Viktor-Matitsin/Hardware/FMU_V.2/BOM_FMU_V.2.xlsx

Oty | Value | Device | Package | Parts | Description | LINK
1 | 0u01 | CAP0603 | 0603-CAP | C515 | Capacitor | https://www.digikey.com/product-detail/en/kemet/C0603C103K3RACTU/399-7840-1-ND/3471563
4 | 0u01 | CAP0805 | 0805-CAP | C913, C914, C918, C920 | Capacitor | https://www.digikey.com/product-detail/en/kemet/C0805C103K3RACTU/399-7994-1-ND/3471717
2 | 0u022 | CAP0805 | 0805-CAP | C917, C919 | Capacitor | https://www.digikey.com/product-detail/en/kemet/C0805C223K3RACTU/399-11169-1-ND/4357887
32 | 0u1 | CAP0603 | 0603-CAP | C101, C201, C301, C302, C305, C308, C309, C401, C402, C403, C404, C405, C503, C507, C508, C514, C516, C606, C607, C608, C610, C612, C615, C616, C617, C619, C702, C703, C704, C707, C804, C805 | Capacitor | https://www.digikey.com/product-detail/en/kemet/C0603C104K3RACTU/399-1281-1-ND/416057
2 | 0u1 | CAP0805 | 0805-CAP | C333, C334 | Capacitor | https://www.digikey.com/product-detail/en/tdk-corporation/C2012X7R2A104K125AA/445-1418-1-ND/569084
4 | 0u33 | CAP1210 | 1210-CAP | C406, C407, C408, C409 | Capacitor | https://www.digikey.com/product-detail/en/kemet/C1210C334K1RAC7800/399-14726-1-ND/7104018
2 | 0u47 | CAP0603 | 0603-CAP | C204, C509 | Capacitor | https://www.digikey.com/product-detail/en/kemet/C0603C474K3RAC7867/399-11934-1-ND/5267654
2 | 0u47 | CAP0805 | 0805-CAP | C915, C915 | Capacitor | https://www.digikey.com/product-detail/en/kemet/C0805C474K5RACTU/399-8100-1-ND/3471823
8 | 100u | CAP1206 | 1206-CAP | C925, C926, C927, C929, C930, C931, C614, C618 | Capacitor | https://www.digikey.com/product-detail/en/taiyo-yuden/EMK325ABJ107MM-T/587-3152-1-ND/2774765
2 | 100u | CAP_POL1206 | EIA3216 | C310, C311 | Capacitor | https://www.digikey.com/product-detail/en/avx-corporation/TLNS107M010R2500/478-6249-1-ND/2470134
1 | 10u | CAP0603 | 0603-CAP | C807 | Capacitor | https://www.digikey.com/product-detail/en/kemet/C0603C106M9PACTU/399-5504-1-ND/1950682
7 | 10u/25V | CAP0805 | 0805-CAP | C312, C410, C506, C511, C803, C601, C620 | Capacitor | https://www.digikey.com/product-detail/en/kemet/C0805C106K3PAC7800/399-11939-1-ND/5267657
3 | 1u | CAP0603 | 0603-CAP | C202, C808, C603 | Capacitor | https://www.digikey.com/product-detail/en/kemet/C0603C105K3RACTU/399-7376-1-ND/3317410
4 | 1u | CAP0805 | 0805-CAP | C303, C304, C306, C307 | Capacitor | https://www.digikey.com/product-detail/en/kemet/C0805C105K3RACTU/399-8004-1-ND/3471727
4 | 22u/25V | CAP0805 | 0805-CAP | C313, C411, C604, C605 | Capacitor | https://www.digikey.com/product-detail/en/murata-electronics-north-america/GRT21BR61E226ME13L/490-12389-1-ND/5417090
4 | 2u2 | CAP0603 | 0603-CAP | C512, C513, C611, C613 | Capacitor | https://www.digikey.com/product-detail/en/kemet/C0603C225K4PACTU/399-7886-1-ND/3471609
4 | 330p | CAP0805 | 0805-CAP | C911, C912, C923, C924 | Capacitor | https://www.digikey.com/product-detail/en/kemet/C0805C331K1RACTU/399-9224-1-ND/3522742
2 | 33u | CAP1206 | 1206 | C928, C932 | Capacitor | https://www.digikey.com/product-detail/en/kemet/C1206C476M8PACTU/399-5508-1-ND/1950686
8 | 22u | CAP1812 | 1812-CAP | C901, C902,C903, C904, C905, C906, C907, C908 | Capacitor | https://www.digikey.com/product-detail/en/tdk-corporation/CKG57NX7S2A226M500JH/445-5217-1-ND/2116352
1 | 5n6 | CAP0603 | 0603-CAP | C203 | Capacitor | https://www.digikey.com/product-detail/en/kemet/C0603C562K5RACTU/399-7943-1-ND/3471666
4 | 8p | CAP0603 | 0603-CAP | C102, C103, C705, C706 | Capacitor | https://www.digikey.com/product-detail/en/kemet/CBR06C809BAGAC/399-8740-1-ND/3480389
6 | 100K | RESISTOR0603-RES | 0603-RES | R214, R301, R302, R303, R304, R305 | Resistor | https://www.digikey.com/product-detail/en/vishay-dale/CRCW0603100KFKEA/541-100KHCT-ND/1180038
8 | 10K | RESISTOR0603-RES | 0603-RES | R102, R103, R212, R611, R615, R701, R702, R706 | Resistor | https://www.digikey.com/product-detail/en/vishay-dale/CRCW060310K0FKEA/541-10.0KHCT-ND/1179924
7 | 10K/0,1% | RESISTOR0603-RES | 0603-RES | R407, R408, R609, R610, R809, R810, R811 | Resistor | https://www.digikey.com/product-detail/en/vishay-dale/TNPW060310K0BEEA/TNP10.0KAACT-ND/1857057
2 | 10R | RESISTOR2512-RES | 2512-RES | R916, R917 | Resistor | https://www.digikey.com/product-detail/en/vishay-dale/CRCW251210R0FKEGHP/541-10.0RCT-ND/2222586
10 | 120R | RESISTOR0603-RES | 0603-RES | R201, R202, R203, R204, R208, R209, R210, R211, R404, R405 | Resistor | https://www.digikey.com/product-detail/en/vishay-dale/CRCW0603120RFKEAHP/541-120SCT-ND/5326818
1 | 120R | RESISTOR0805-RES | 0805-RES | R310 | Resistor | https://www.digikey.com/product-detail/en/vishay-dale/CRCW0805120RFKEAHP/541-120TCT-ND/5326877
2 | 16K5 | RESISTOR0603-RES | 0603-RES | R218, R617 | Resistor | https://www.digikey.com/product-detail/en/vishay-dale/CRCW060316K5FKEA/541-16.5KHCT-ND/1179947
1 | 1K | RESISTOR0603-RES | 0603-RES | R608 | Resistor | https://www.digikey.com/product-detail/en/vishay-dale/CRCW06031K00FKEA/541-1.00KHCT-ND/1179809
3 | 1K2 | RESISTOR0603-RES | 0603-RES | R309, R311, R312 | Resistor | https://www.digikey.com/product-detail/en/vishay-dale/CRCW06031K20FKEA/541-1.20KHCT-ND/1179817
4 | 1K5 | RESISTOR0603-RES | 0603-RES | R401, R402, R306, R307 | Resistor | https://www.digikey.com/product-detail/en/vishay-dale/CRCW06031K50FKEA/541-1.50KHCT-ND/1179827
2 | 1K65 | RESISTOR0805-RES | 0805-RES | R914, R915 | Resistor | https://www.digikey.com/product-detail/en/vishay-dale/CRCW08051K65FKEA/541-1.65KCCT-ND/1180806
5 | 1M | RESISTOR0603-RES | 0603-RES | R104, R602, R604, R901, R902 | Resistor | https://www.digikey.com/product-detail/en/vishay-dale/RCS06031M00FKEA/541-2803-1-ND/5867096
2 | 21K | RESISTOR0805-RES | 0805-RES | R910, R911 | Resistor | https://www.digikey.com/product-detail/en/yageo/RC0603FR-0721KL/311-21.0KHRCT-ND/729995
10 | 220R | RESISTOR0603-RES | 0603-RES | R621, R703, R704, R705, R802, R803, R804, R805, R806, R807 | Resistor | https://www.digikey.com/product-detail/en/vishay-dale/CRCW0603220RFKEAHP/541-220SCT-ND/2825993
2 | 22K/1% | RESISTOR0603-RES | 0603-RES | R903, R904 | Resistor | https://www.digikey.com/product-detail/en/vishay-dale/CRCW060322K0FKEA/541-22.0KHCT-ND/1179960
2 | 22K | RESISTOR0603-RES | 0603-RES | R903, R904 | Resistor | https://www.digikey.com/product-detail/en/yageo/RC0603JR-0722KL/311-22KGRCT-ND/729691
1 | 25K5 | RESISTOR0603-RES | 0603-RES | R616 | Resistor | https://www.digikey.com/product-detail/en/vishay-dale/CRCW060325K5FKEA/541-25.5KHCT-ND/1179968
4 | 330R | RESISTOR0603-RES | 0603-RES | R206, R213, R216, R921 | Resistor | https://www.digikey.com/product-detail/en/vishay-dale/CRCW0603330RFKEAHP/541-330SCT-ND/2826009
1 | 453K | RESISTOR0603-RES | 0603-RES | R217 | Resistor | https://www.digikey.com/product-detail/en/vishay-dale/CRCW0603453KFKEA/541-453KHCT-ND/1180112
1 | 470R | RESISTOR0603-RES | 0603-RES | R101 | Resistor | https://www.digikey.com/product-detail/en/vishay-dale/CRCW0603470RFKEA/541-470HCT-ND/1179771
2 | 49K9 | RESISTOR0805-RES | 0805-RES | R912, R913 | Resistor | https://www.digikey.com/product-detail/en/vishay-dale/CRCW080549K9FKEA/541-49.9KCCT-ND/1180976
2 | 510R | RESISTOR0603-RES | 0603-RES | R205, R215 | Resistor | https://www.digikey.com/product-detail/en/vishay-dale/CRCW0603510RFKEAHP/541-510S-CT-ND/5326852
2 | 5K11 | RESISTOR0805-RES | 0805-RES | R918, R919 | Resistor | https://www.digikey.com/product-detail/en/vishay-dale/CRCW08055K11FKEA/541-5.11KCCT-ND/1180864
4 | 60R | RESISTOR0805-RES | 0805-RES | R409, R410, R411, R412 | Resistor | https://www.digikey.com/product-detail/en/vishay-dale/CRCW080559R0FKEA/541-59.0CCT-ND/1180643
1 | 9K09 | RESISTOR0603-RES | 0603-RES | R207 | Resistor | https://www.digikey.com/product-detail/en/vishay-dale/TNPW06039K09BEEA/TNP9.09KAACT-ND/1857092
1 | 2908-05WB-MG | MICROSDSDI | MICROSD | U301 | CONN MICRO SD CARD PUSH-PUSH R/A | https://www.digikey.com/product-detail/en/3m/2908-05WB-MG/3M5607CT-ND/1242498
2 | ADUM5402CRWZ-RL | ADUM1301 | SO-16W | U303, U401 | DGTL ISO 2.5KV GEN PURP 16SOIC | https://www.digikey.com/product-detail/en/analog-devices-inc/ADUM5402CRWZ-RL/ADUM5402CRWZ-RLDKR-ND/3664615
2 | BQ24315DSGR | BQ24315 | QFN8-DSG | U601, U602 | IC LI+ CHARGER FRONT END 8-SON | https://www.digikey.com/product-detail/en/texas-instruments/BQ24315DSGR/296-23341-1-ND/1833318
1 | FM25V01A-G | FM25V01 | SO08 | U102 | IC FRAM 128KBIT 40MHZ 8SOIC | https://www.digikey.com/product-detail/en/cypress-semiconductor-corp/FM25V01A-G/428-3385-ND/5210379
1 | ICM20608-G | ICM20608 | LGA-16-3PX5P | U502 | IMU ACCEL/GYRO I2C/SPI 16LGA | https://www.digikey.com/product-detail/en/tdk-invensense/ICM-20608-G/1428-1052-1-ND/5177387
3 | LM1117IMPX-3.3/NOPB | LM1117 | TO-261-4 | U603, U604, U803 | IC REG LIN 3.3V 800MA SOT223-4 | https://www.digikey.com/product-detail/en/texas-instruments/LM1117IMPX-3.3-NOPB/LM1117IMPX-3.3-NOPBCT-ND/3440160
2 | LM5005MHX/NOPB | LM5005 | TSSOP20 | U901, U902 | IC REG BUCK ADJ 2.5A 20TSSOP | https://www.digikey.com/product-detail/en/texas-instruments/LM5005MHX-NOPB/LM5005MHX-NOPBCT-ND/3526995
1 | LT3469ETS8 | LT3469 | SOT23-8 | U202 | IC AMP DVR W/REG 1.3MHZ TSOT23-8 | https://www.digikey.com/product-detail/en/linear-technology/LT3469ETS8-TRMPBF/LT3469ETS8-TRMPBFCT-ND/3830402
1 | MAX13487EESA+T | MAX13487 | SO08 | U304 | IC TXRX RS485/RS422 8-SOIC | https://www.digikey.com/product-detail/en/maxim-integrated/MAX13487EESA-T/MAX13487EESA-CT-ND/5639993
1 | MAX232ECWE | MAX232E | SO16L | U305 | IC TXRX RS232 5V ESD-PROT 16SOIC | https://www.digikey.com/product-detail/en/maxim-integrated/MAX232ECWE-/MAX232ECWE--ND/947838
2 | MAX3051EKA+T | MAX3051 | SOT23-8 | U402, U403 | IC TXRX CAN 3.3V SOT23-8 | https://www.digikey.com/product-detail/en/maxim-integrated/MAX3051EKA-T/MAX3051EKA-TCT-ND/2699450
1 | MPU-6000 | MPU-6000 | QFN-24 (4x4x1 mm) | U504 | IMU ACCEL/GYRO I2C/SPI 24QFN | https://www.digikey.com/product-detail/en/tdk-invensense/MPU-6000/1428-1005-1-ND/4038006
1 | MPU-9250 | MPU-9250 | QFN-24 (3x3x1 mm) | U503 | IMU ACCEL/GYRO/MAG I2C/SPI 24QFN | https://www.digikey.com/product-detail/en/tdk-invensense/MPU-9250/1428-1019-1-ND/4626450
1 | MS5611-01BA03-00 | MS5611-01BA | MS5611-01BA | U506 | BAROMETRIC PRESSURE SENSOR | https://www.digikey.com/products/en?keywords=MS5611-01BA03-00
1 | NUF2042XV6T1G | NUF2042XV6 | SOT563-6 | U302 | FILTER RC(PI) 22 OHM/42PF SMD | https://www.digikey.com/product-detail/en/on-semiconductor/NUF2042XV6T1G/NUF2042XV6T1GOSCT-ND/2122047
1 | STM32F100C8T6B | STM32F10XCXT6 | TQFP48 | U701 | IC MCU 32BIT 64KB FLASH 48LQFP | https://www.digikey.com/product-detail/en/stmicroelectronics/STM32F100C8T6B/497-10499-ND/2259224
1 | STM32F427VIT6 | STM32F4X7VX | TQFP100 | U101 | IC MCU 32BIT 2MB FLASH 100LQFP | https://www.digikey.com/product-detail/en/stmicroelectronics/STM32F427VIT6/497-14049-ND/4357419
2 | TXS0108EPWR | TXS0108TSSOP-20 | R-PDSO-G20 | U201, U801 | IC 8BIT NON-INV TRANSLTR 20TSSOP | https://www.digikey.com/product-detail/en/texas-instruments/TXS0108EPWR/296-23011-1-ND/1775304
1 | MSS1P4-M3/89A | MSS1P4-M3 | MicroSMP | D302 | DIODE SCHOTTKY 40V 1A MICROSMP | https://www.digikey.com/product-detail/en/vishay-semiconductor-diodes-division/MSS1P4-M3-89A/MSS1P4-M3-89AGICT-ND/2071761
1 | 30BQ100TR | DIODE-SCHOTTKI-SMA | SMA-DIODE | D909 | DIODE SCHOTTKY 100V SMC | https://www.digikey.com/product-detail/en/smc-diode-solutions/30BQ100TR/1655-1389-1-ND/6022834
4 | 6CWQ10FN-M3 | MOSFET-NCHANNEL-DPAK | D-PAK (TO-252AA) “M” | D901, D902, D903, D904 | DIODE ARRAY SCHOTTKY 100V DPAK | https://www.digikey.com/products/en?keywords=6CWQ10FN-M3
6 | PESD0402-140 | DIODE-TVS | 0402-TVS | D201, D202, D203, D401, D403, D701 | TVS DIODE 14VWM 40VC 0402 | https://www.digikey.com/product-detail/en/littelfuse-inc/PESD0402-140/PESD0402-140CT-ND/1968526
3 | PESD1CAN | PESD1CAN | SOT23 | D301, D404, D405 | TVS DIODE 24VWM 50VC SC70 | https://www.digikey.com/product-detail/en/nexperia-usa-inc/PESD1CAN-UX/1727-1306-1-ND/4386316
1 | RB751V40T1G | DIODE-SCHOTTKY_SOD323 | SOD323 | D601 | DIODE SCHOTTKY 30V 30MA SOD323 | https://www.digikey.com/product-detail/en/on-semiconductor/RB751V40T1G/RB751V40T1GOSCT-ND/964629
3 | APHHS1005ZGC | LED0603 | 0603-LED | LED2, LED3, LED6 | LED GREEN CLEAR 0402 SMD | https://www.digikey.com/product-detail/en/kingbright/APHHS1005ZGC/754-1503-1-ND/2263583
1 | APHHS1005QBC/D | LED0603 | 0603-LED | LED5 | LED BLUE CLEAR 0402 SMD | https://www.digikey.com/product-detail/en/kingbright/APHHS1005QBC-D/754-1504-1-ND/2263581
2 | APHHS1005SURCK | LED0603 | 0603-LED | LED1, LED4 | LED RED CLEAR 0402 SMD | https://www.digikey.com/product-detail/en/kingbright/APHHS1005SURCK/754-1104-1-ND/1747821
2 | DR120-330-R | SLF10145 | SLF10145 | L901, L902 | 33µH Shielded Wirewound Inductor | https://www.digikey.com/product-detail/en/eaton/DR127-330-R/513-1047-1-ND/695328
1 | LBR2012T470K | INDUCTOR0805 | 0805-IND | L204 | FIXED IND 47UH 75MA 1.7 OHM SMD | https://www.digikey.com/product-detail/en/taiyo-yuden/LBR2012T470K/587-2047-1-ND/1788994
11 | NFM15PC104D0J3D | KNH16C104DA5TS | 0402-1.0x0.5mm | L201, L202, L203, L401, L404, L603, L604,L801, L802, L903, L904 | CAP FEEDTHRU 0.1UF 20% 6.3V 0402 | https://www.digikey.com/product-detail/en/murata-electronics-north-america/NFM15PC104D0J3D/490-14730-1-ND/6606336
1 | MS621FE-FL11E | MS621FE | MS621FE | B601 | BATT LITH 3V 5.5MAH COIN 6.8MM | https://www.digikey.com/products/en?keywords=MS621FE-FL11E
2 | NX3225SA-24.000MHZ-STD-CSR-1 | OSCILLATOR-3.2X2.5 | OSCILLATOR-3.2X2.5 | X101, X701 | 24MHz ±15ppm Crystal 8pF | https://www.digikey.com/product-detail/en/ndk-america-inc/NX3225SA-24.000MHZ-STD-CSR-1/644-1052-1-ND/1128924
2 | EVQ-P7A01P | SWITCH-MOMENTARY-2 | EVQP7J01K | S601, S701 | SWITCH TACTILE SPST-NO 0.05A 12V | https://www.digikey.com/product-detail/en/panasonic-electronic-components/EVQ-P7A01P/P16763CT-ND/4429456
1 | 473460001 | MOLEX-47346-0001 | MOLEX-47346-0001 | USB1 | CONN RCPT 5POS MICRO USB-2 R/A | https://www.digikey.com/product-detail/en/molex-llc/0473460001/WM17141CT-ND/1782474
