Viktor-Matitsin/Hardware/FMU_V.2/FMU_V.2.brd

## EAGLE design FMU_V.2/FMU_V.2.brd (2017-08-23)

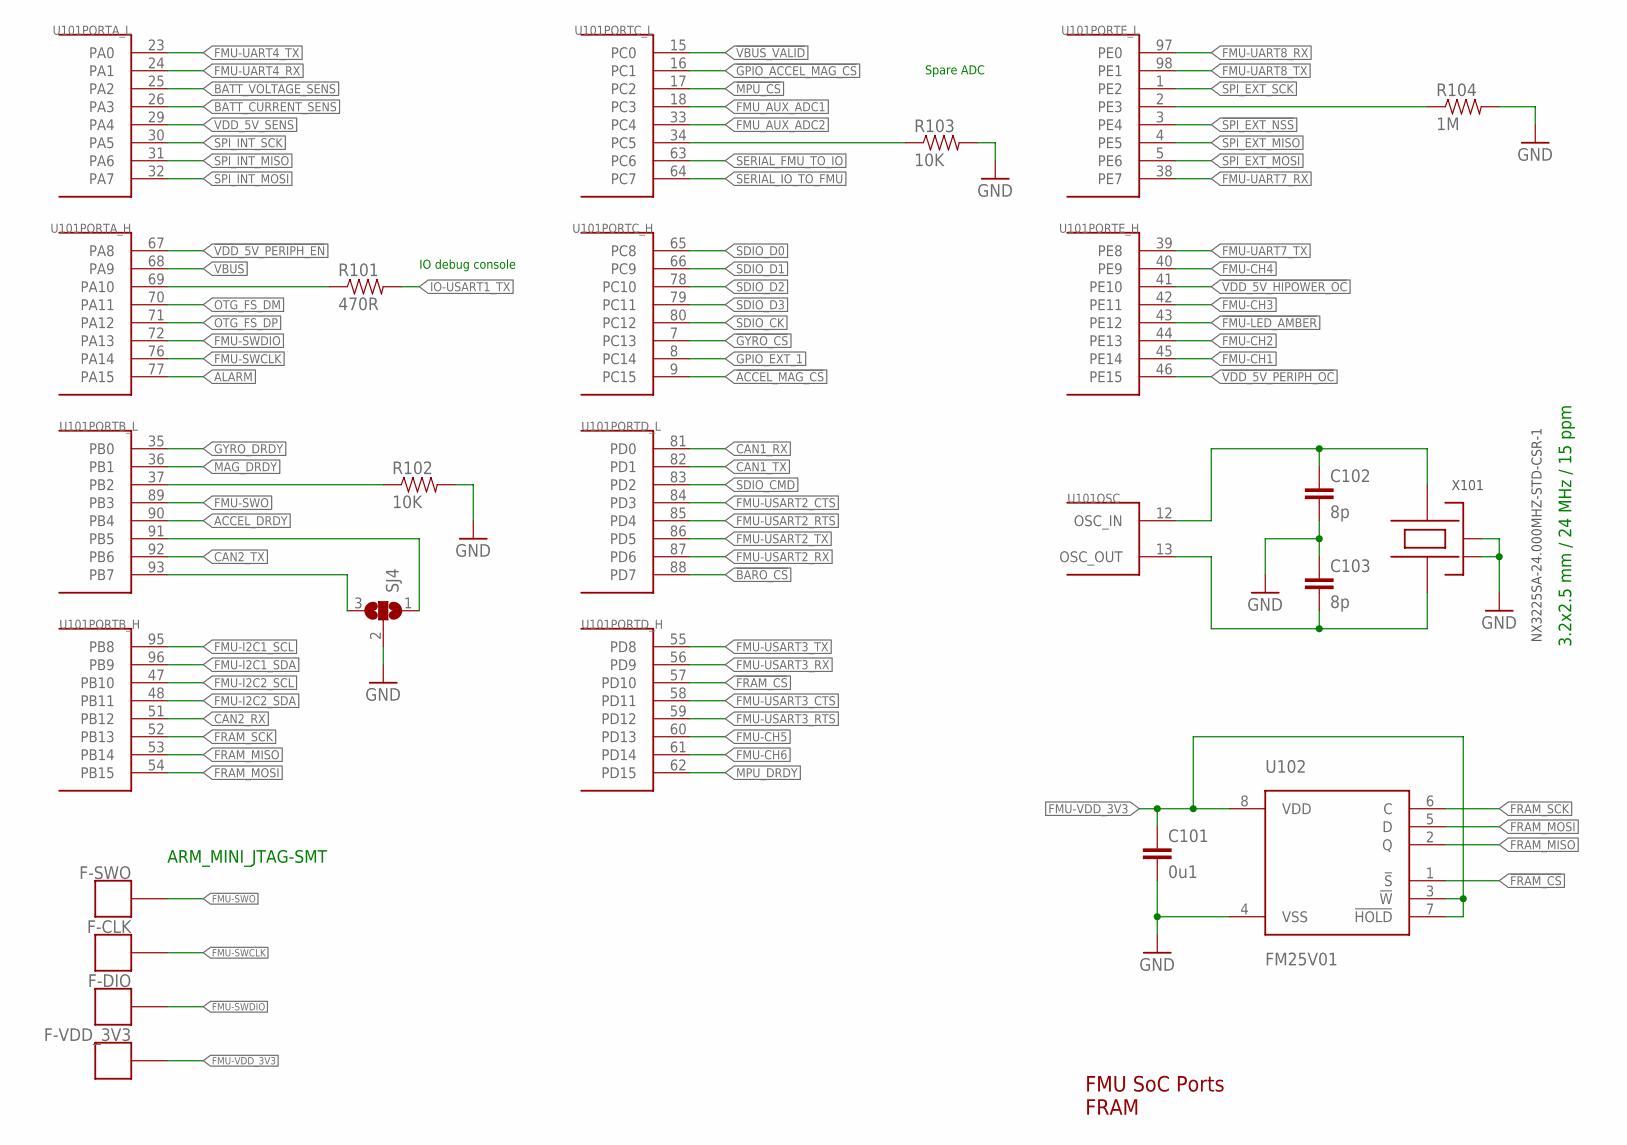
[picture p1: schematic FMU_V.2.sch, sheet 1]

Parts:
C101: 0u1; 0603-CAP
C102, C103: 8p; 0603-CAP
F-CLK: PAD.04; PAD.04X.04
F-DIO: PAD.04; PAD.04X.04
F-SWO: PAD.04; PAD.04X.04
F-VDD_3V3: PAD.04; PAD.04X.04
R101: 470R; 0603-RES
R102, R103: 10K; 0603-RES
R104: 1M; 0603-RES
SJ4: SJ2W; SJ_2
U101: STM32F4X7VX; TQFP100; PARTNO STM32F427VI
U102: FM25V01; SO08; PARTNO FM25V01-G
X101: NX3225SA-24.000MHZ-STD-CSR-1; OSCILLATOR-3.2X2.5; PARTNO NX3225SA-24.000000MHZ

Connections:
!ACCEL_MAG_CS: U101.9 (PC15); also elsewhere on the board
!BARO_CS: U101.88 (PD7); also elsewhere on the board
!FMU-LED_AMBER: U101.43 (PE12); also elsewhere on the board
!FRAM_CS: U101.57 (PD10), U102.1 (!S)
!GPIO_ACCEL_MAG_CS: U101.16 (PC1); also elsewhere on the board
!GYRO_CS: U101.7 (PC13); also elsewhere on the board
!MPU_CS: U101.17 (PC2); also elsewhere on the board
!SPI_EXT_NSS: U101.3 (PE4); also elsewhere on the board
!VBUS_VALID: U101.15 (PC0)
!VDD_5V_HIPOWER_OC: U101.41 (PE10); also elsewhere on the board
!VDD_5V_PERIPH_EN: U101.67 (PA8); also elsewhere on the board
!VDD_5V_PERIPH_OC: U101.46 (PE15); also elsewhere on the board
!VDD_BRICK_VALID: SJ4.1, U101.91 (PB5)
!VDD_SERVO_VALID: SJ4.3, U101.93 (PB7)
ACCEL_DRDY: U101.90 (PB4); also elsewhere on the board
ALARM: U101.77 (PA15); also elsewhere on the board
BATT_CURRENT_SENS: U101.26 (PA3); also elsewhere on the board
BATT_VOLTAGE_SENS: U101.25 (PA2); also elsewhere on the board
CAN1_RX: U101.81 (PD0); also elsewhere on the board
CAN1_TX: U101.82 (PD1); also elsewhere on the board
CAN2_RX: U101.51 (PB12); also elsewhere on the board
CAN2_TX: U101.92 (PB6); also elsewhere on the board
FMU-CH1: U101.45 (PE14); also elsewhere on the board
FMU-CH2: U101.44 (PE13); also elsewhere on the board
FMU-CH3: U101.42 (PE11); also elsewhere on the board
FMU-CH4: U101.40 (PE9); also elsewhere on the board
FMU-CH5: U101.60 (PD13); also elsewhere on the board
FMU-CH6: U101.61 (PD14); also elsewhere on the board
FMU-I2C1_SCL: U101.95 (PB8); also elsewhere on the board
FMU-I2C1_SDA: U101.96 (PB9); also elsewhere on the board
FMU-I2C2_SCL: U101.47 (PB10); also elsewhere on the board
FMU-I2C2_SDA: U101.48 (PB11); also elsewhere on the board
FMU-SWCLK: F-CLK.P$1, U101.76 (PA14)
FMU-SWDIO: F-DIO.P$1, U101.72 (PA13)
FMU-SWO: F-SWO.P$1, U101.89 (PB3)
FMU-UART4_RX: U101.24 (PA1); also elsewhere on the board
FMU-UART4_TX: U101.23 (PA0); also elsewhere on the board
FMU-UART7_RX: U101.38 (PE7); also elsewhere on the board
FMU-UART7_TX: U101.39 (PE8); also elsewhere on the board
FMU-UART8_RX: U101.97 (PE0); also elsewhere on the board
FMU-UART8_TX: U101.98 (PE1); also elsewhere on the board
FMU-USART2_CTS: U101.84 (PD3); also elsewhere on the board
FMU-USART2_RTS: U101.85 (PD4); also elsewhere on the board
FMU-USART2_RX: U101.87 (PD6); also elsewhere on the board
FMU-USART2_TX: U101.86 (PD5); also elsewhere on the board
FMU-USART3_CTS: U101.58 (PD11)
FMU-USART3_RTS: U101.59 (PD12)
FMU-USART3_RX: U101.56 (PD9); also elsewhere on the board
FMU-USART3_TX: U101.55 (PD8); also elsewhere on the board
FMU-VDD_3V3: C101.P$1 (1), F-VDD_3V3.P$1, U102.3 (!W), U102.7 (!HOLD), U102.8 (VDD); also elsewhere on the board
FMU_AUX_ADC1: U101.18 (PC3); also elsewhere on the board
FMU_AUX_ADC2: U101.33 (PC4); also elsewhere on the board
FRAM_MISO: U101.53 (PB14), U102.2 (Q)
FRAM_MOSI: U101.54 (PB15), U102.5 (D)
FRAM_SCK: U101.52 (PB13), U102.6 (C)
GND: C101.P$2 (2), C102.P$2 (2), C103.P$1 (1), R102.2, R103.2, R104.2, SJ4.2, U102.4 (VSS), X101.2 (NC_2), X101.4 (NC_4); also elsewhere on the board
GPIO_EXT_1: U101.8 (PC14); also elsewhere on the board
GYRO_DRDY: U101.35 (PB0); also elsewhere on the board
IO-USART1_TX: R101.2; also elsewhere on the board
MAG_DRDY: U101.36 (PB1); also elsewhere on the board
MPU_DRDY: U101.62 (PD15); also elsewhere on the board
unnamed: C103.P$2 (2), U101.13 (OSC_OUT), X101.1
unnamed: C102.P$1 (1), U101.12 (OSC_IN), X101.3
unnamed: R104.1, U101.2 (PE3)
unnamed: R103.1, U101.34 (PC5)
unnamed: R101.1, U101.69 (PA10)
OTG_FS_DM: U101.70 (PA11); also elsewhere on the board
OTG_FS_DP: U101.71 (PA12); also elsewhere on the board
PC5: R102.1, U101.37 (PB2)
SDIO_CK: U101.80 (PC12); also elsewhere on the board
SDIO_CMD: U101.83 (PD2); also elsewhere on the board
SDIO_D0: U101.65 (PC8); also elsewhere on the board
SDIO_D1: U101.66 (PC9); also elsewhere on the board
SDIO_D2: U101.78 (PC10); also elsewhere on the board
SDIO_D3: U101.79 (PC11); also elsewhere on the board
SERIAL_FMU_TO_IO: U101.63 (PC6); also elsewhere on the board
SERIAL_IO_TO_FMU: U101.64 (PC7); also elsewhere on the board
SPI_EXT_MISO: U101.4 (PE5); also elsewhere on the board
SPI_EXT_MOSI: U101.5 (PE6); also elsewhere on the board
SPI_EXT_SCK: U101.1 (PE2); also elsewhere on the board
SPI_INT_MISO: U101.31 (PA6); also elsewhere on the board
SPI_INT_MOSI: U101.32 (PA7); also elsewhere on the board
SPI_INT_SCK: U101.30 (PA5); also elsewhere on the board
VBUS: U101.68 (PA9); also elsewhere on the board
VDD_5V_SENS: U101.29 (PA4); also elsewhere on the board

Notes on the sheet:
FMU SoC Ports FRAM
IO debug console
Spare ADC
3.2x2.5 mm / 24 MHz / 15 ppm
ARM_MINI_JTAG-SMT

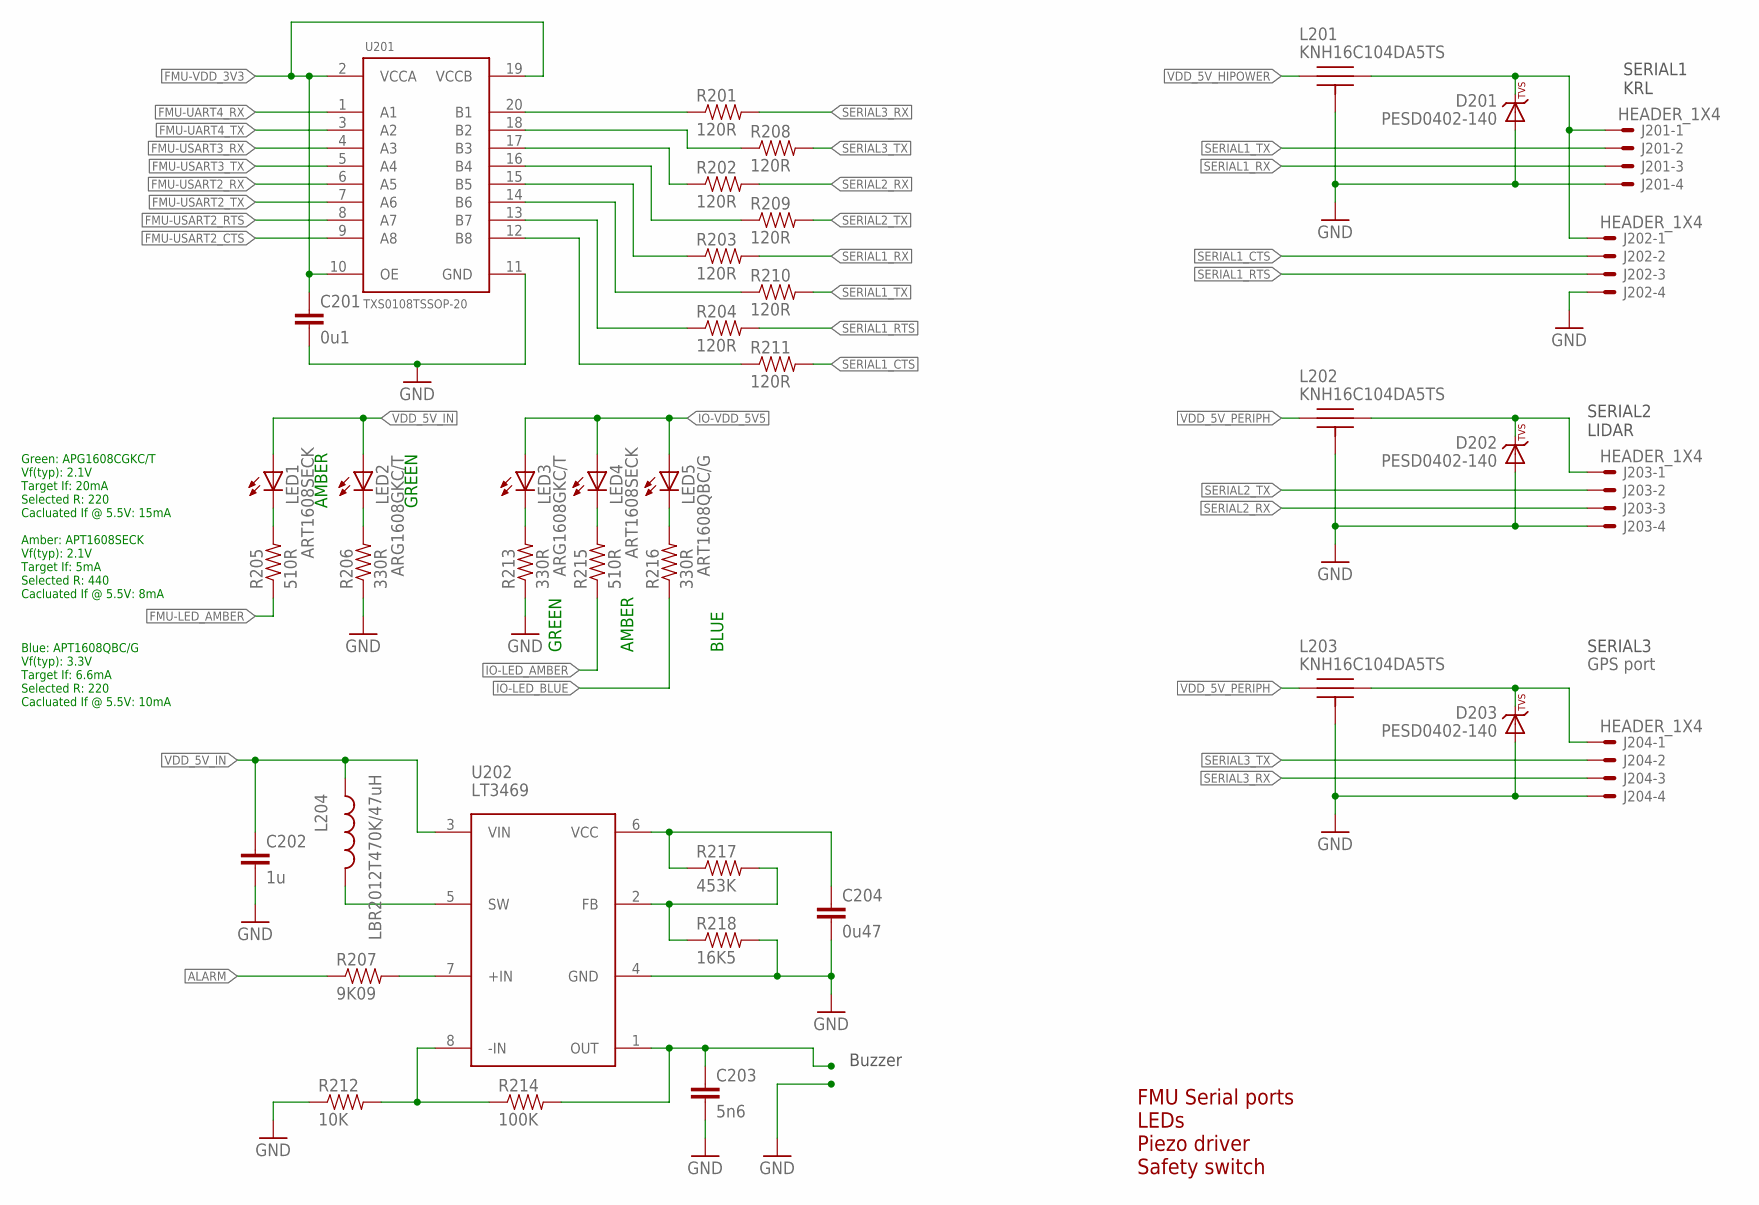
[picture p2: schematic FMU_V.2.sch, sheet 2]

Parts:
C201: 0u1; 0603-CAP
C202: 1u; 0603-CAP
C203: 5n6; 0603-CAP
C204: 0u47; 0603-CAP
D201, D202, D203: PESD0402-140; 0402-TVS; PARTNO PESD0402-140
J201, J202, J203, J204: HEADER_1X4; HEADER_2.54MM-1X04
L201, L202, L203: KNH16C104DA5TS; KYOCERA-KNH16-DA; PARTNO KNH16C104DA5TS
L204: LBR2012T470K/47uH; 0805-IND
LED1, LED4: ART1608SECK; 0603-LED
LED2, LED3: ARG1608GKC/T; 0603-LED
LED5: ART1608QBC/G; 0603-LED
R201, R202, R203, R204, R208, R209, R210, R211: 120R; 0603-RES
R205, R215: 510R; 0603-RES
R206, R213, R216: 330R; 0603-RES
R207: 9K09; 0603-RES
R212: 10K; 0603-RES
R214: 100K; 0603-RES
R217: 453K; 0603-RES
R218: 16K5; 0603-RES
U201: TXS0108TSSOP-20; R-PDSO-G20
U202: LT3469; SOT23-8

Connections:
!FMU-LED_AMBER: R205.1; also elsewhere on the board
!IO-LED_AMBER: R215.1; also elsewhere on the board
!IO-LED_BLUE: R216.1; also elsewhere on the board
ALARM: R207.1; also elsewhere on the board
FMU-UART4_RX: U201.1 (A1); also elsewhere on the board
FMU-UART4_TX: U201.3 (A2); also elsewhere on the board
FMU-USART2_CTS: U201.9 (A8); also elsewhere on the board
FMU-USART2_RTS: U201.8 (A7); also elsewhere on the board
FMU-USART2_RX: U201.6 (A5); also elsewhere on the board
FMU-USART2_TX: U201.7 (A6); also elsewhere on the board
FMU-USART3_RX: U201.4 (A3); also elsewhere on the board
FMU-USART3_TX: U201.5 (A4); also elsewhere on the board
FMU-VDD_3V3: C201.P$1 (1), U201.2 (VCCA), U201.10 (OE), U201.19 (VCCB); also elsewhere on the board
GND: C201.P$2 (2), C202.P$2 (2), C203.P$2 (2), C204.P$2 (2), D201.A, D202.A, D203.A, J201.4, J202.4, J203.4, J204.4, L201.P$3, L201.P$4, L201.P$5, L202.P$3, L202.P$4, L202.P$5, L203.P$3, L203.P$4, L203.P$5, R206.1, R212.1, R213.1, R218.2, U201.11 (GND), U202.4 (GND); also elsewhere on the board
IO-VDD_5V5: LED3.A, LED4.A, LED5.A; also elsewhere on the board
unnamed: D201.C, J201.1, J202.1, L201.P$2
unnamed: R201.1, U201.20 (B1)
unnamed: R208.1, U201.18 (B2)
unnamed: R202.1, U201.17 (B3)
unnamed: R209.1, U201.16 (B4)
unnamed: R203.1, U201.15 (B5)
unnamed: R210.1, U201.14 (B6)
unnamed: R204.1, U201.13 (B7)
unnamed: R211.1, U201.12 (B8)
unnamed: LED1.C, R205.2
unnamed: LED2.C, R206.2
unnamed: L204.P$2 (2), U202.5 (SW)
unnamed: LED3.C, R213.2
unnamed: LED4.C, R215.2
unnamed: LED5.C, R216.2
unnamed: D203.C, J204.1, L203.P$2
unnamed: D202.C, J203.1, L202.P$2
unnamed: C203.P$1 (1), R214.2, U202.1 (OUT)
unnamed: R207.2, U202.7 (+IN)
unnamed: R212.2, R214.1, U202.8 (-IN)
unnamed: C204.P$1 (1), R217.1, U202.6 (VCC)
unnamed: R217.2, R218.1, U202.2 (FB)
SERIAL1_CTS: J202.2, R211.2
SERIAL1_RTS: J202.3, R204.2
SERIAL1_RX: J201.3, R203.2
SERIAL1_TX: J201.2, R210.2
SERIAL2_RX: J203.3, R202.2
SERIAL2_TX: J203.2, R209.2
SERIAL3_RX: J204.3, R201.2
SERIAL3_TX: J204.2, R208.2
VDD_5V_HIPOWER: L201.P$1; also elsewhere on the board
VDD_5V_IN: C202.P$1 (1), L204.P$1 (1), LED1.A, LED2.A, U202.3 (VIN); also elsewhere on the board
VDD_5V_PERIPH: L202.P$1, L203.P$1; also elsewhere on the board

Notes on the sheet:
FMU Serial ports LEDs Piezo driver Safety switch
SERIAL2 LIDAR
SERIAL1 KRL
SERIAL3
GPS port
Green: APG1608CGKC/T Vf(typ): 2.1V Target If: 20mA Selected R: 220 Cacluated If @ 5.5V: 15mA Amber: APT1608SECK Vf(typ): 2.1V Target If: 5mA Selected R: 440 Cacluated If @ 5.5V: 8mA Blue: APT1608QBC/G Vf(typ): 3.3V Target If: 6.6mA Selected R: 220 Cacluated If @ 5.5V: 10mA
Buzzer
AMBER
GREEN
BLUE

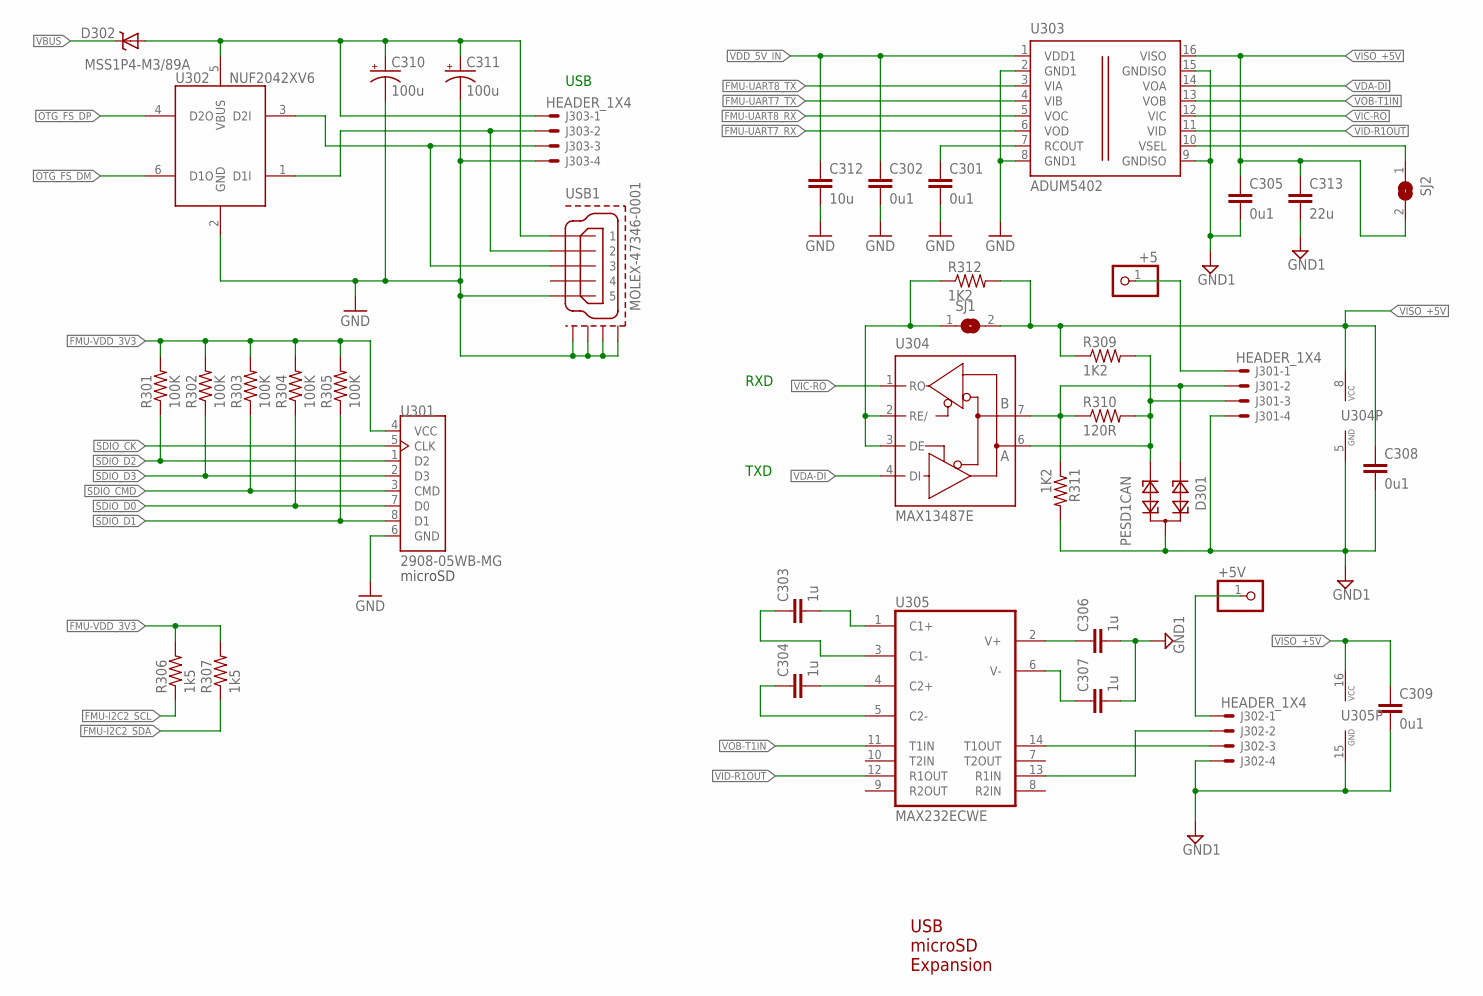
[picture p3: schematic FMU_V.2.sch, sheet 3]

Parts:
+5, +5V: PINHD-1X1; 1X01
C301, C302, C305, C308, C309: 0u1; 0603-CAP
C303, C304, C306, C307: 1u; 0805-CAP
C310, C311: 100u; EIA3216
C312: 10u; 0805-CAP
C313: 22u; 0805-CAP
D301: PESD1CAN; SOT23
D302: MSS1P4-M3/89A; MICROSMP
J301, J302, J303: HEADER_1X4; HEADER_2.54MM-1X04
R301, R302, R303, R304, R305: 100K; 0603-RES
R306, R307: 1k5; 0603-RES
R309, R311, R312: 1K2; 0603-RES
R310: 120R; 0805
SJ1, SJ2: SJ
U301: 2908-05WB-MG; MICROSD; PARTNO 2908-05WB-MG
U302: NUF2042XV6; SOT563-6; PARTNO NUF2042XV6T1G
U303: ADUM5402; SO-16W
U304: MAX13487E; SO08
U305: MAX232ECWE; SO16L
USB1: MOLEX-47346-0001

Connections:
1: C310.A (+), C311.A (+), D302.ANODE (A), J303.1, U302.5 (VBUS), USB1.VBUS (1)
FMU-I2C2_SCL: R306.1; also elsewhere on the board
FMU-I2C2_SDA: R307.1; also elsewhere on the board
FMU-UART7_RX: U303.6 (VOD); also elsewhere on the board
FMU-UART7_TX: U303.4 (VIB); also elsewhere on the board
FMU-UART8_RX: U303.5 (VOC); also elsewhere on the board
FMU-UART8_TX: U303.3 (VIA); also elsewhere on the board
FMU-VDD_3V3: R301.2, R302.2, R303.2, R304.2, R305.2, R306.2, R307.2, U301.4 (VCC); also elsewhere on the board
GND: C301.P$2 (2), C302.P$2 (2), C310.C (-), C311.C (-), C312.P$2 (2), J303.4, U301.6 (GND), U302.2 (GND), U303.2 (GND1), U303.8 (GND1), USB1.GND (5), USB1.GND1, USB1.GND2, USB1.GND3, USB1.GND4; also elsewhere on the board
GND1: C305.P$2 (2), C306.P$2 (2), C307.P$2 (2), C308.P$2 (2), C309.P$2 (2), C313.P$2 (2), D301.3, J301.4, J302.4, R311.2, U303.9 (GNDISO), U303.15 (GNDISO), U304.5 (GND), U305.15 (GND); also elsewhere on the board
unnamed: SJ2.1, U303.10 (VSEL)
unnamed: C304.P$2 (2), U305.4 (C2+)
unnamed: C304.P$1 (1), U305.5 (C2-)
unnamed: C303.P$1 (1), U305.3 (C1-)
unnamed: R312.1, SJ1.1, U304.2 (RE/), U304.3 (DE)
unnamed: C301.P$1 (1), U303.7 (RCOUT)
unnamed: C303.P$2 (2), U305.1 (C1+)
unnamed: C306.P$1 (1), U305.2 (V+)
unnamed: D301.1, J301.2, R310.1, R311.1, U304.7 (B)
unnamed: D301.2, J301.3, R309.2, R310.2, U304.6 (A)
unnamed: C307.P$1 (1), U305.6 (V-)
unnamed: J302.3, U305.14 (T1OUT)
unnamed: J302.2, U305.13 (R1IN)
unnamed: +5.1, J301.1
unnamed: +5V.1, J302.1
OTG_DM1: J303.2, U302.1 (D1I), USB1.D- (2)
OTG_DP1: J303.3, U302.3 (D2I), USB1.D+ (3)
OTG_FS_DM: U302.6 (D1O); also elsewhere on the board
OTG_FS_DP: U302.4 (D2O); also elsewhere on the board
SDIO_CK: U301.5 (CLK); also elsewhere on the board
SDIO_CMD: R303.1, U301.3 (CMD); also elsewhere on the board
SDIO_D0: R304.1, U301.7 (D0); also elsewhere on the board
SDIO_D1: R305.1, U301.8 (D1); also elsewhere on the board
SDIO_D2: R301.1, U301.1 (D2); also elsewhere on the board
SDIO_D3: R302.1, U301.2 (D3); also elsewhere on the board
VBUS: D302.CATHODE (C); also elsewhere on the board
VDA-DI: U303.14 (VOA), U304.4 (DI)
VDD_5V_IN: C302.P$1 (1), C312.P$1 (1), U303.1 (VDD1); also elsewhere on the board
VIC-RO: U303.12 (VIC), U304.1 (RO)
VID-R1OUT: U303.11 (VID), U305.12 (R1OUT)
VISO_+5V: C305.P$1 (1), C308.P$1 (1), C309.P$1 (1), C313.P$1 (1), R309.1, R312.2, SJ1.2, SJ2.2, U303.16 (VISO), U304.8 (VCC), U305.16 (VCC)
VOB-T1IN: U303.13 (VOB), U305.11 (T1IN)

Notes on the sheet:
USB microSD Expansion
microSD
USB
RXD
TXD

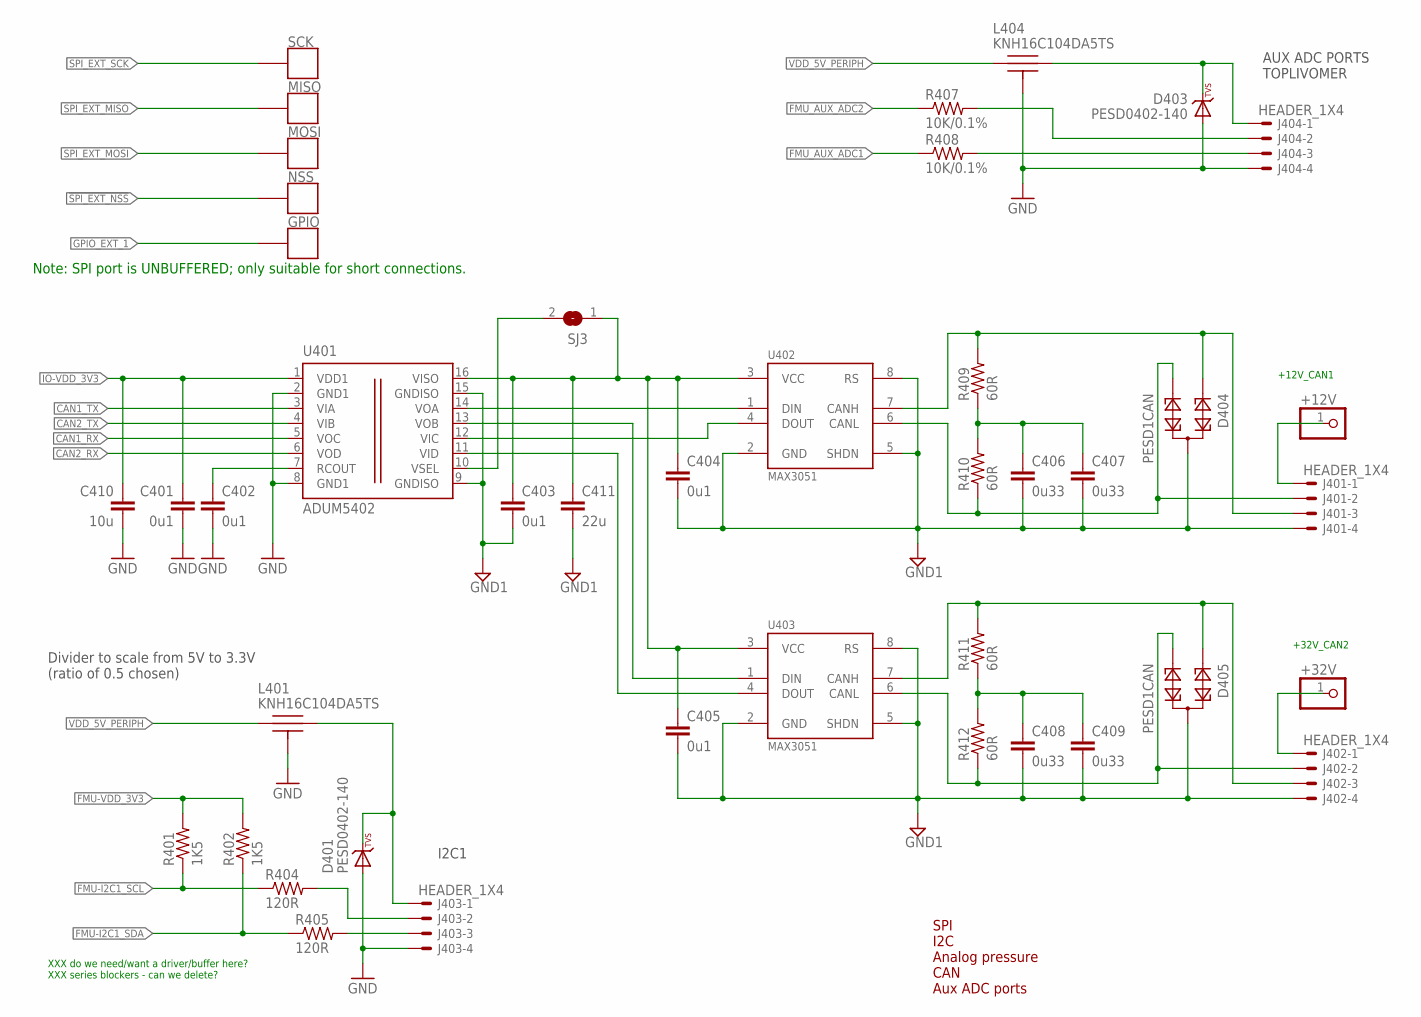
[picture p4: schematic FMU_V.2.sch, sheet 4]

Parts:
+12V, +32V: PINHD-1X1; 1X01
C401, C402, C403, C404, C405: 0u1; 0603-CAP
C406, C407, C408, C409: 0u33; 1210
C410: 10u; 0805-CAP
C411: 22u; 0805-CAP
D401, D403: PESD0402-140; 0402-TVS; PARTNO PESD0402-140
D404, D405: PESD1CAN; SOT23
GPIO: PAD.04; PAD.04X.04
J401, J402, J403, J404: HEADER_1X4; HEADER_2.54MM-1X04
L401, L404: KNH16C104DA5TS; KYOCERA-KNH16-DA; PARTNO KNH16C104DA5TS
MISO: PAD.04; PAD.04X.04
MOSI: PAD.04; PAD.04X.04
NSS: PAD.04; PAD.04X.04
R401, R402: 1K5; 0603-RES
R404, R405: 120R; 0603-RES
R407, R408: 10K/0.1%; 0603-RES
R409, R410, R411, R412: 60R; 0805
SCK: PAD.04; PAD.04X.04
SJ3: SJ
U401: ADUM5402; SO-16W
U402, U403: MAX3051; SOT23-8; PARTNO MAX3051EKA

Connections:
!SPI_EXT_NSS: NSS.P$1; also elsewhere on the board
CAN1_RX: U401.5 (VOC); also elsewhere on the board
CAN1_TX: U401.3 (VIA); also elsewhere on the board
CAN2_RX: U401.6 (VOD); also elsewhere on the board
CAN2_TX: U401.4 (VIB); also elsewhere on the board
FMU-I2C1_SCL: R401.1, R404.1; also elsewhere on the board
FMU-I2C1_SDA: R402.1, R405.1; also elsewhere on the board
FMU-VDD_3V3: R401.2, R402.2; also elsewhere on the board
FMU_AUX_ADC1: R408.1; also elsewhere on the board
FMU_AUX_ADC2: R407.1; also elsewhere on the board
FMU_AUX_ADC2_PROT: J404.2, R407.2
GND: C401.P$2 (2), C402.P$2 (2), C410.P$2 (2), D401.A, D403.A, J403.4, J404.4, L401.P$3, L401.P$4, L401.P$5, L404.P$3, L404.P$4, L404.P$5, U401.2 (GND1), U401.8 (GND1); also elsewhere on the board
GND1: C403.P$2 (2), C404.P$2 (2), C405.P$2 (2), C406.2, C407.2, C408.2, C409.2, C411.P$2 (2), D404.3, D405.3, J401.4, J402.4, U401.9 (GNDISO), U401.15 (GNDISO), U402.2 (GND), U402.5 (SHDN), U402.8 (RS), U403.2 (GND), U403.5 (SHDN), U403.8 (RS); also elsewhere on the board
GPIO_EXT_1: GPIO.P$1; also elsewhere on the board
IO-VDD_3V3: C401.P$1 (1), C410.P$1 (1), U401.1 (VDD1); also elsewhere on the board
unnamed: J404.3, R408.2
unnamed: C406.1, C407.1, R409.1, R410.2
unnamed: D405.1, J402.3, R411.2, U403.7 (CANH)
unnamed: D404.1, J401.3, R409.2, U402.7 (CANH)
unnamed: SJ3.2, U401.10 (VSEL)
unnamed: U401.13 (VOB), U403.1 (DIN)
unnamed: D405.2, J402.2, R412.1, U403.6 (CANL)
unnamed: D404.2, J401.2, R410.1, U402.6 (CANL)
unnamed: U401.14 (VOA), U402.1 (DIN)
unnamed: U401.12 (VIC), U402.4 (DOUT)
unnamed: U401.11 (VID), U403.4 (DOUT)
unnamed: C402.P$1 (1), U401.7 (RCOUT)
unnamed: J403.2, R404.2
unnamed: C408.1, C409.1, R411.1, R412.2
unnamed: J403.3, R405.2
unnamed: C403.P$1 (1), C404.P$1 (1), C405.P$1 (1), C411.P$1 (1), SJ3.1, U401.16 (VISO), U402.3 (VCC), U403.3 (VCC)
unnamed: D401.C, J403.1, L401.P$2
unnamed: D403.C, J404.1, L404.P$2
P1: +12V.1, J401.1
P2: +32V.1, J402.1
SPI_EXT_MISO: MISO.P$1; also elsewhere on the board
SPI_EXT_MOSI: MOSI.P$1; also elsewhere on the board
SPI_EXT_SCK: SCK.P$1; also elsewhere on the board
VDD_5V_PERIPH: L401.P$1, L404.P$1; also elsewhere on the board

Notes on the sheet:
XXX do we need/want a driver/buffer here? XXX series blockers - can we delete?
I2C1
AUX ADC PORTS TOPLIVOMER
SPI I2C Analog pressure CAN Aux ADC ports
Note: SPI port is UNBUFFERED; only suitable for short connections.
Divider to scale from 5V to 3.3V (ratio of 0.5 chosen)
+12V_CAN1
+32V_CAN2

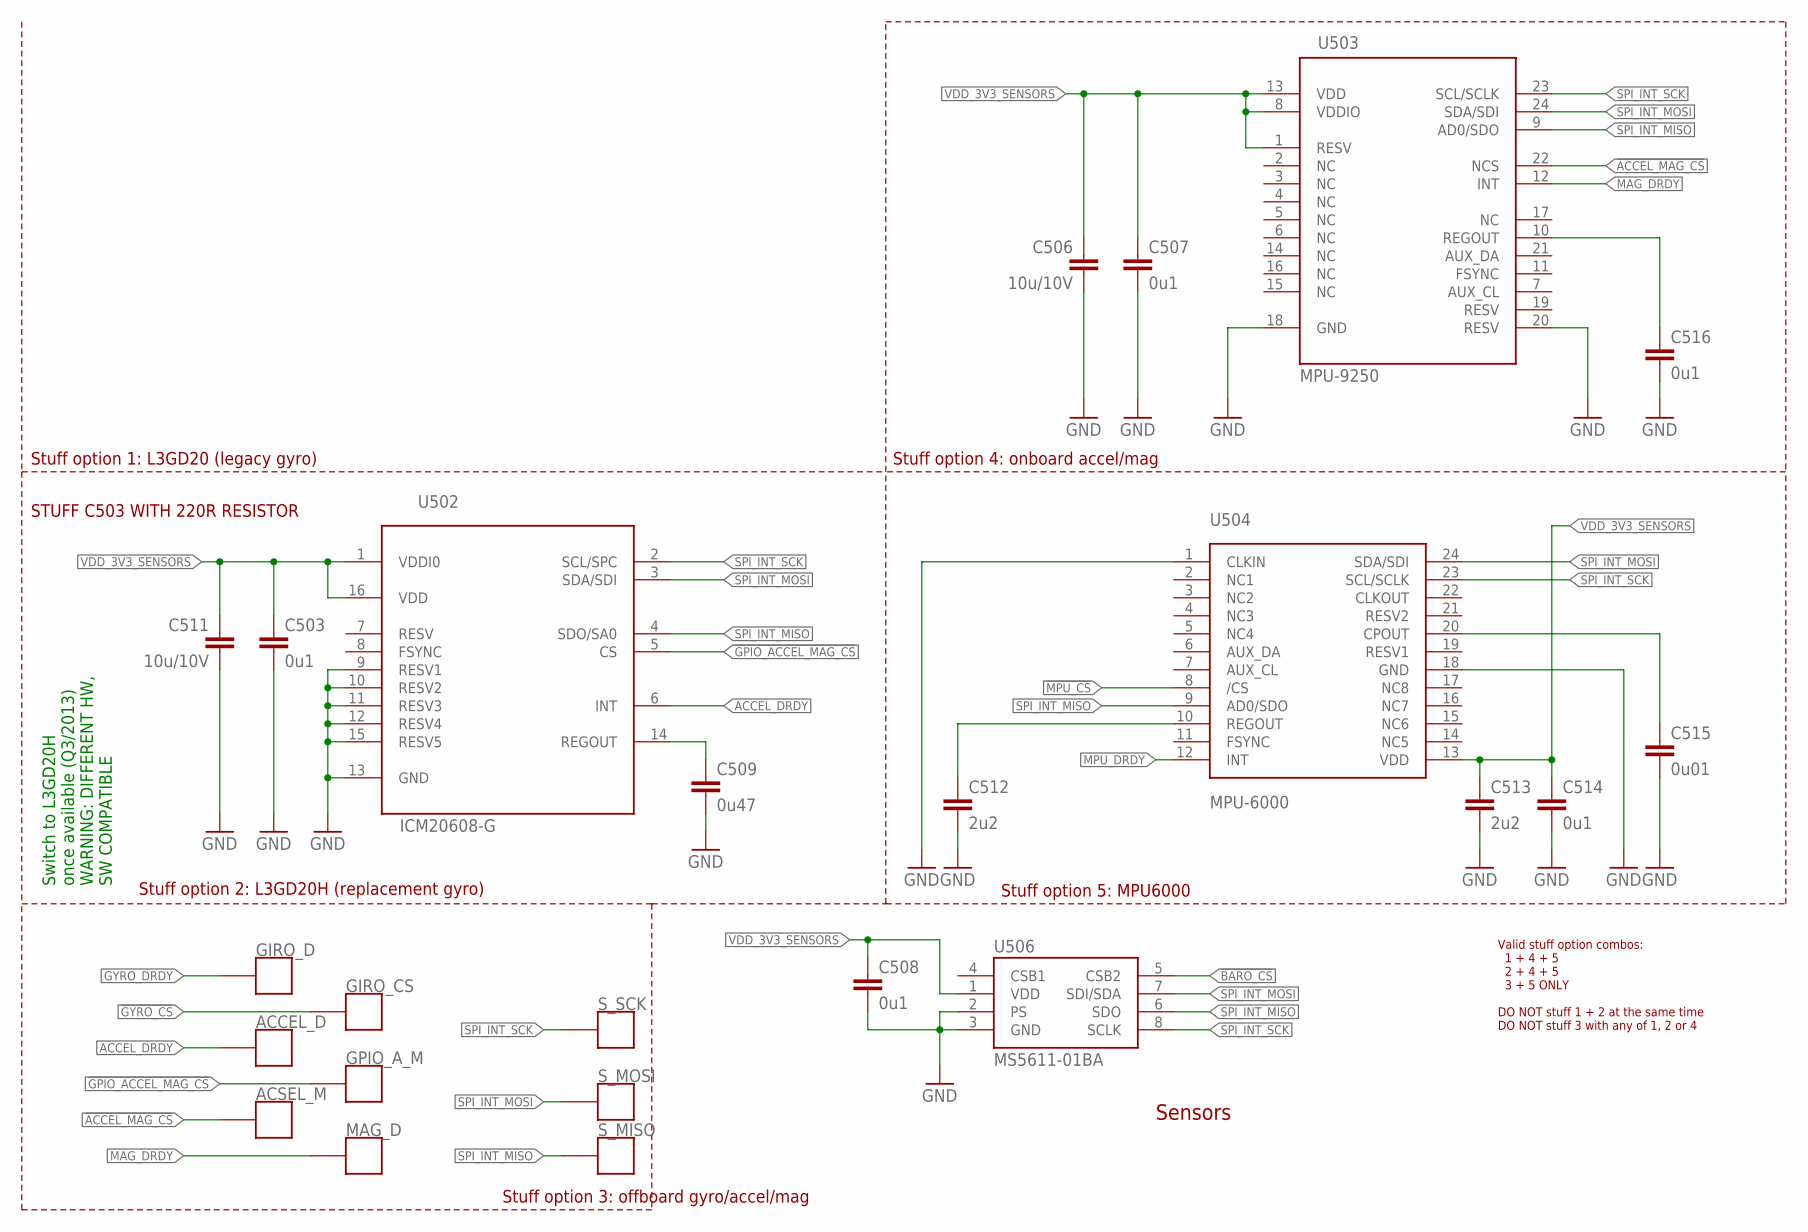
[picture p5: schematic FMU_V.2.sch, sheet 5]

Parts:
ACCEL_D: PAD.04; PAD.04X.04
ACSEL_M: PAD.04; PAD.04X.04
C503, C507, C508, C514, C516: 0u1; 0603-CAP
C506, C511: 10u/10V; 0805-CAP; PARTNO CC0805ZKY5V6BB106
C509: 0u47; 0603-CAP
C512, C513: 2u2; 0603-CAP; PARTNO C1608X6S1C225K080AC
C515: 0u01; 0603-CAP; PARTNO 06033C103JAT2A
GIRO_CS: PAD.04; PAD.04X.04
GIRO_D: PAD.04; PAD.04X.04
GPIO_A_M: PAD.04; PAD.04X.04
MAG_D: PAD.04; PAD.04X.04
S_MISO: PAD.04; PAD.04X.04
S_MOSI: PAD.04; PAD.04X.04
S_SCK: PAD.04; PAD.04X.04
U502: ICM20608-G; LGA-16-3PX5P
U503: MPU-9250; QFN
U504: MPU-6000; QFN-24; PARTNO MPU-6000
U506: MS5611-01BA; PARTNO MS5611-01BA

Connections:
!ACCEL_MAG_CS: ACSEL_M.P$1, U503.22 (NCS); also elsewhere on the board
!BARO_CS: U506.5 (CSB2); also elsewhere on the board
!GPIO_ACCEL_MAG_CS: GPIO_A_M.P$1, U502.5 (CS); also elsewhere on the board
!GYRO_CS: GIRO_CS.P$1; also elsewhere on the board
!MPU_CS: U504.8 (/CS); also elsewhere on the board
ACCEL_DRDY: ACCEL_D.P$1, U502.6 (INT); also elsewhere on the board
GND: C503.P$2 (2), C506.P$2 (2), C507.P$2 (2), C508.P$2 (2), C509.P$2 (2), C511.P$2 (2), C512.P$2 (2), C513.P$2 (2), C514.P$2 (2), C515.P$2 (2), C516.P$2 (2), U502.9 (RESV1), U502.10 (RESV2), U502.11 (RESV3), U502.12 (RESV4), U502.13 (GND), U502.15 (RESV5), U503.18 (GND), U503.20 (RESV), U504.1 (CLKIN), U504.18 (GND), U506.2 (PS), U506.3 (GND); also elsewhere on the board
GYRO_DRDY: GIRO_D.P$1; also elsewhere on the board
MAG_DRDY: MAG_D.P$1, U503.12 (INT); also elsewhere on the board
MPU_DRDY: U504.12 (INT); also elsewhere on the board
unnamed: C509.P$1 (1), U502.14 (REGOUT)
unnamed: C516.P$1 (1), U503.10 (REGOUT)
unnamed: C512.P$1 (1), U504.10 (REGOUT)
unnamed: C515.P$1 (1), U504.20 (CPOUT)
SPI_INT_MISO: S_MISO.P$1, U502.4 (SDO/SA0), U503.9 (AD0/SDO), U504.9 (AD0/SDO), U506.6 (SDO); also elsewhere on the board
SPI_INT_MOSI: S_MOSI.P$1, U502.3 (SDA/SDI), U503.24 (SDA/SDI), U504.24 (SDA/SDI), U506.7 (SDI/SDA); also elsewhere on the board
SPI_INT_SCK: S_SCK.P$1, U502.2 (SCL/SPC), U503.23 (SCL/SCLK), U504.23 (SCL/SCLK), U506.8 (SCLK); also elsewhere on the board
VDD_3V3_SENSORS: C503.P$1 (1), C506.P$1 (1), C507.P$1 (1), C508.P$1 (1), C511.P$1 (1), C513.P$1 (1), C514.P$1 (1), U502.1 (VDDI0), U502.16 (VDD), U503.1 (RESV), U503.8 (VDDIO), U503.13 (VDD), U504.13 (VDD), U506.1 (VDD); also elsewhere on the board

Notes on the sheet:
Sensors
Switch to L3GD20H once available (Q3/2013) WARNING: DIFFERENT HW, SW COMPATIBLE
Stuff option 1: L3GD20 (legacy gyro)
Stuff option 2: L3GD20H (replacement gyro)
Stuff option 4: onboard accel/mag
Valid stuff option combos: 1 + 4 + 5 2 + 4 + 5 3 + 5 ONLY DO NOT stuff 1 + 2 at the same time DO NOT stuff 3 with any of 1, 2 or 4
Stuff option 5: MPU6000
Stuff option 3: offboard gyro/accel/mag
STUFF C503 WITH 220R RESISTOR

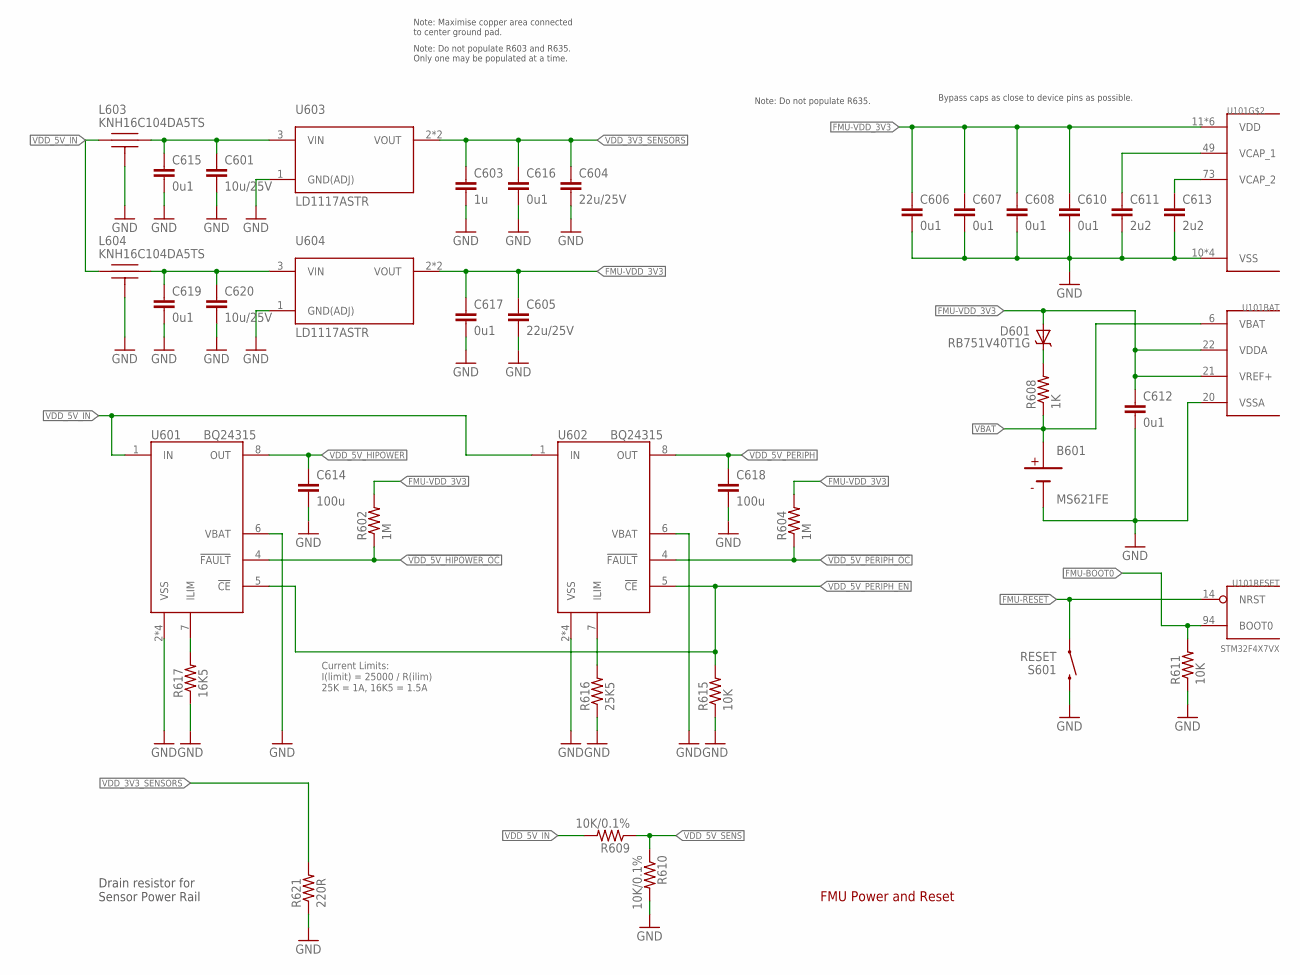
[picture p6: schematic FMU_V.2.sch, sheet 6]

Parts:
B601: MS621FE; PARTNO MS621FE-FL11E
C601, C620: 10u/25V; 0805-CAP; PARTNO CL21A106KAYNNNE
C603: 1u; 0603-CAP; PARTNO CC0603ZRY5V7BB105
C604, C605: 22u/25V; 0805-CAP; PARTNO CL21A226MAQNNNE
C606, C607, C608, C610, C612, C615, C616, C617, C619: 0u1; 0603-CAP
C611, C613: 2u2; 0603-CAP; PARTNO C1608X6S1C225K080AC
C614, C618: 100u; 1206-CAP; PARTNO C3216X5R1A107M160AC
D601: RB751V40T1G; SOD323
L603, L604: KNH16C104DA5TS; KYOCERA-KNH16-DA; PARTNO KNH16C104DA5TS
R602, R604: 1M; 0603-RES
R608: 1K; 0603-RES
R609, R610: 10K/0.1%; 0603-RES
R611, R615: 10K; 0603-RES
R616: 25K5; 0603-RES
R617: 16K5; 0603-RES
R621: 220R; 0603-RES
S601: RESET; EVQP7J01K; PARTNO EVQ-P7J01P
U101: STM32F4X7VX; TQFP100; PARTNO STM32F427VI
U601, U602: BQ24315; QFN8-DSG; PARTNO BQ24315DSGR
U603, U604: LD1117ASTR; SOT-223

Connections:
!VDD_5V_HIPOWER_OC: R602.1, U601.4 (!FAULT); also elsewhere on the board
!VDD_5V_PERIPH_EN: R615.2, U601.5 (!CE), U602.5 (!CE); also elsewhere on the board
!VDD_5V_PERIPH_OC: R604.1, U602.4 (!FAULT); also elsewhere on the board
FMU-!RESET: S601.A1 (1), U101.14 (NRST)
FMU-BOOT0: R611.2, U101.94 (BOOT0); also elsewhere on the board
FMU-VDD_3V3: C605.P$1 (1), C606.P$1 (1), C607.P$1 (1), C608.P$1 (1), C610.P$1 (1), C612.P$1 (1), C617.P$1 (1), D601.A, R602.2, R604.2, U101.11 (VDD), U101.19 (VDD), U101.21 (VREF+), U101.22 (VDDA), U101.28 (VDD), U101.50 (VDD), U101.75 (VDD), U101.100 (VDD), U604.2 (VOUT), U604.4 (VOUT); also elsewhere on the board
FMU-VDD_5V5: C601.P$1 (1), C615.P$1 (1), L603.P$2, U603.3 (VIN)
GND: B601.2 (NEG), C601.P$2 (2), C603.P$2 (2), C604.P$2 (2), C605.P$2 (2), C606.P$2 (2), C607.P$2 (2), C608.P$2 (2), C610.P$2 (2), C611.P$2 (2), C612.P$2 (2), C613.P$2 (2), C614.P$2 (2), C615.P$2 (2), C616.P$2 (2), C617.P$2 (2), C618.P$2 (2), C619.P$2 (2), C620.P$2 (2), L603.P$3, L603.P$4, L603.P$5, L604.P$3, L604.P$4, L604.P$5, R610.2, R611.1, R615.1, R616.1, R617.1, R621.1, S601.B3 (2), U101.10 (VSS), U101.20 (VSSA), U101.27 (VSS), U101.74 (VSS), U101.99 (VSS), U601.2 (VSS), U601.6 (VBAT), U601.GND (VSS), U601.P$2 (VSS), U601.P$3 (VSS), U602.2 (VSS), U602.6 (VBAT), U602.GND (VSS), U602.P$2 (VSS), U602.P$3 (VSS), U603.1 (GND(ADJ)), U604.1 (GND(ADJ)); also elsewhere on the board
unnamed: C613.P$1 (1), U101.73 (VCAP_2)
unnamed: C611.P$1 (1), U101.49 (VCAP_1)
unnamed: D601.C, R608.2
unnamed: C619.P$1 (1), C620.P$1 (1), L604.P$2, U604.3 (VIN)
unnamed: R616.2, U602.7 (ILIM)
unnamed: R617.2, U601.7 (ILIM)
VBAT: B601.1 (POS), R608.1, U101.6 (VBAT); also elsewhere on the board
VDD_3V3_SENSORS: C603.P$1 (1), C604.P$1 (1), C616.P$1 (1), R621.2, U603.2 (VOUT), U603.4 (VOUT); also elsewhere on the board
VDD_5V_HIPOWER: C614.P$1 (1), U601.8 (OUT); also elsewhere on the board
VDD_5V_IN: L603.P$1, L604.P$1, R609.2, U601.1 (IN), U602.1 (IN); also elsewhere on the board
VDD_5V_PERIPH: C618.P$1 (1), U602.8 (OUT); also elsewhere on the board
VDD_5V_SENS: R609.1, R610.1; also elsewhere on the board

Notes on the sheet:
FMU Power and Reset
Bypass caps as close to device pins as possible.
Note: Maximise copper area connected to center ground pad.
Current Limits: I(limit) = 25000 / R(ilim) 25K = 1A, 16K5 = 1.5A
Drain resistor for Sensor Power Rail
Note: Do not populate R603 and R635. Only one may be populated at a time.
Note: Do not populate R635.
