Viktor-Matitsin/Hardware/FMU_V.2/FMU_V.2.brd

## EAGLE design FMU_V.2/FMU_V.2.brd (continued)

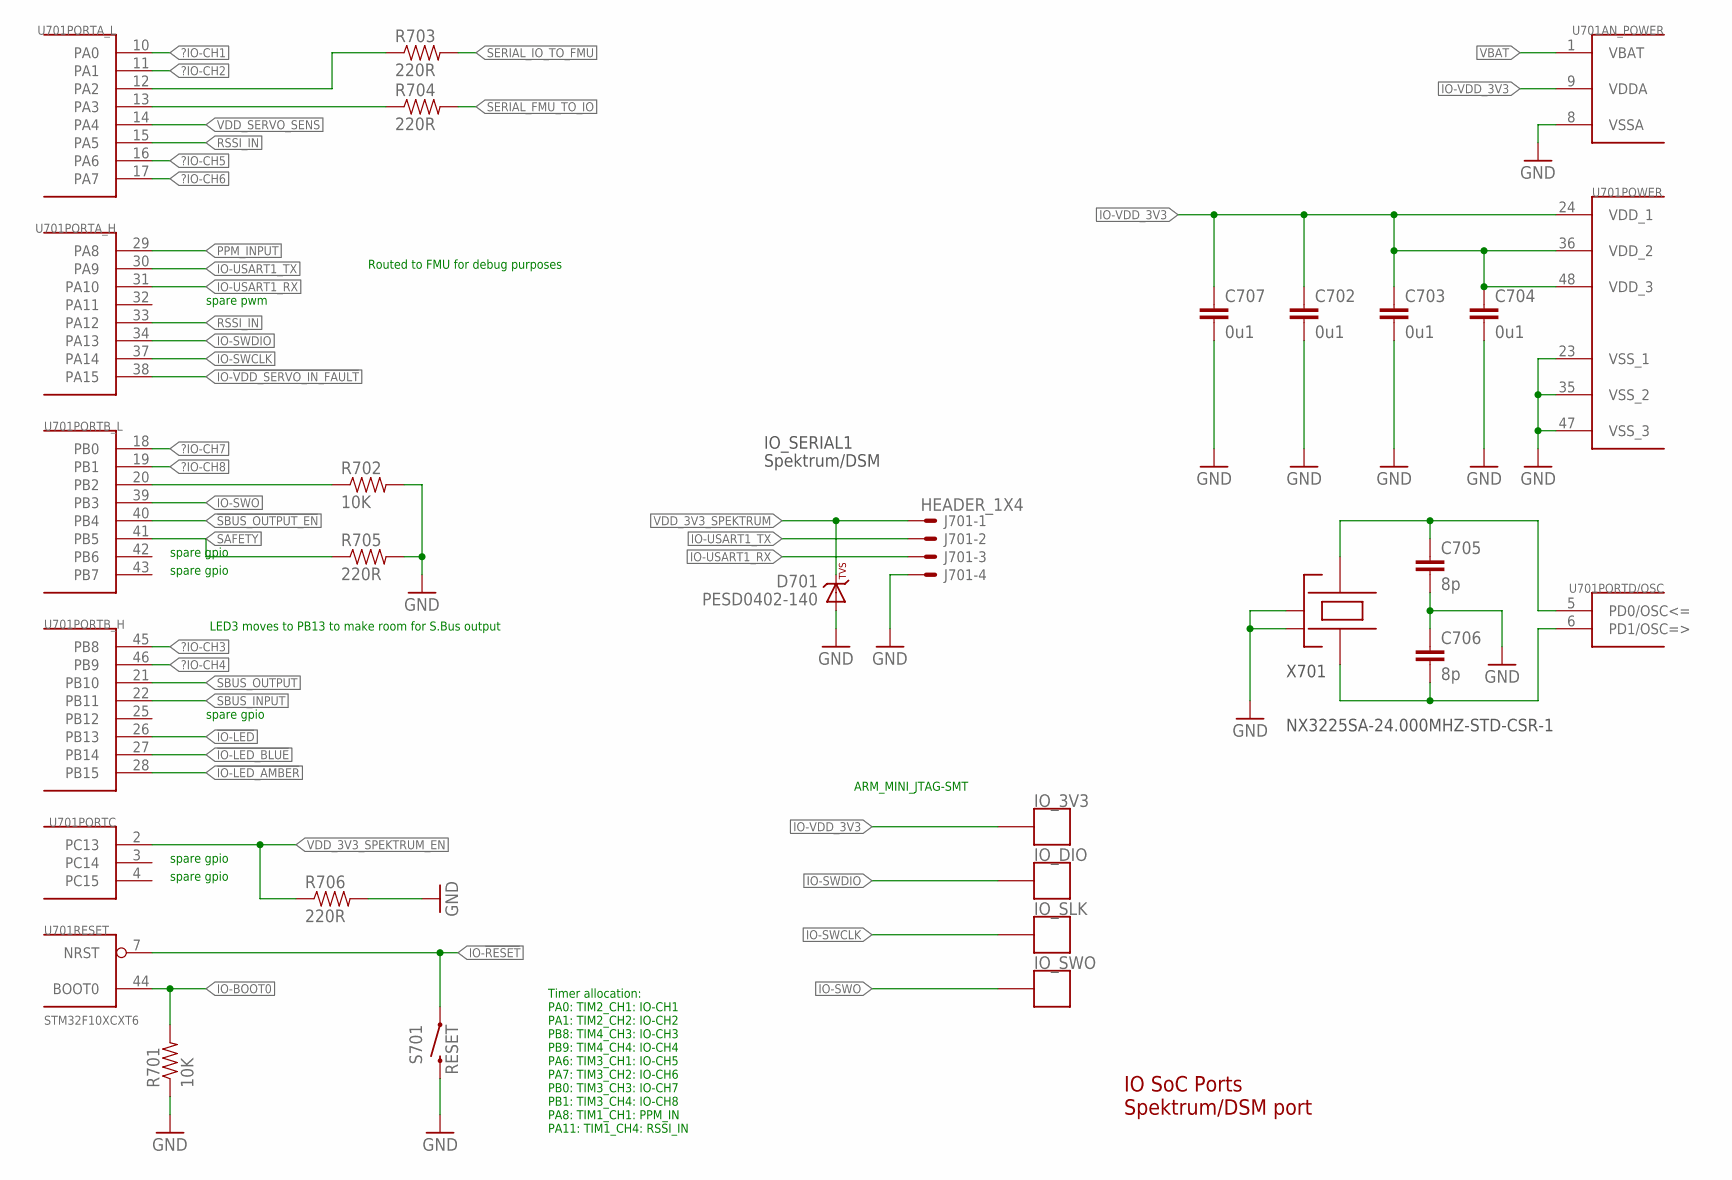
[picture p7: schematic FMU_V.2.sch, sheet 7]

Parts:
C702, C703, C704, C707: 0u1; 0603-CAP
C705, C706: 8p; 0603-CAP
D701: PESD0402-140; 0402-TVS; PARTNO PESD0402-140
IO_3V3: PAD.04; PAD.04X.04
IO_DIO: PAD.04; PAD.04X.04
IO_SLK: PAD.04; PAD.04X.04
IO_SWO: PAD.04; PAD.04X.04
J701: HEADER_1X4; HEADER_2.54MM-1X04
R701, R702: 10K; 0603-RES
R703, R704, R705, R706: 220R; 0603-RES
S701: RESET; EVQP7J01K; PARTNO EVQ-P7J01P
U701: STM32F10XCXT6; TQFP48; PARTNO STM32F100C8T6B
X701: NX3225SA-24.000MHZ-STD-CSR-1; OSCILLATOR-3.2X2.5; PARTNO NX3225SA-24.000000MHZ

Connections:
!IO-LED: U701.26 (PB13)
!IO-LED_AMBER: U701.28 (PB15); also elsewhere on the board
!IO-LED_BLUE: U701.27 (PB14); also elsewhere on the board
!SBUS_OUTPUT_EN: U701.40 (PB4)
?IO-CH1: U701.10 (PA0)
?IO-CH2: U701.11 (PA1)
?IO-CH3: U701.45 (PB8)
?IO-CH4: U701.46 (PB9)
?IO-CH5: U701.16 (PA6)
?IO-CH6: U701.17 (PA7)
?IO-CH7: U701.18 (PB0)
?IO-CH8: U701.19 (PB1)
GND: C702.P$2 (2), C703.P$2 (2), C704.P$2 (2), C705.P$2 (2), C706.P$1 (1), C707.P$2 (2), D701.A, J701.4, R701.1, R702.2, R705.2, R706.2, S701.B3 (2), U701.8 (VSSA), U701.23 (VSS_1), U701.35 (VSS_2), U701.47 (VSS_3), X701.2 (NC_2), X701.4 (NC_4); also elsewhere on the board
IO-!RESET: S701.A1 (1), U701.7 (NRST)
IO-!VDD_SERVO_IN_FAULT: U701.38 (PA15)
IO-BOOT0: R701.2, U701.44 (BOOT0); also elsewhere on the board
IO-BOOT1: R702.1, U701.20 (PB2)
IO-SWCLK: IO_SLK.P$1, U701.37 (PA14)
IO-SWDIO: IO_DIO.P$1, U701.34 (PA13)
IO-SWO: IO_SWO.P$1, U701.39 (PB3)
IO-USART1_RX: J701.3, U701.31 (PA10)
IO-USART1_TX: J701.2, U701.30 (PA9); also elsewhere on the board
IO-VDD_3V3: C702.P$1 (1), C703.P$1 (1), C704.P$1 (1), C707.P$1 (1), IO_3V3.P$1, U701.9 (VDDA), U701.24 (VDD_1), U701.36 (VDD_2), U701.48 (VDD_3); also elsewhere on the board
unnamed: R704.1, U701.13 (PA3)
unnamed: R703.1, U701.12 (PA2)
unnamed: C706.P$2 (2), U701.6 (PD1/OSC=>), X701.1
unnamed: C705.P$1 (1), U701.5 (PD0/OSC<=), X701.3
PPM_INPUT: U701.29 (PA8)
RSSI_IN: U701.15 (PA5), U701.33 (PA12)
SAFETY: R705.1, U701.41 (PB5)
SBUS_INPUT: U701.22 (PB11)
SBUS_OUTPUT: U701.21 (PB10)
SERIAL_FMU_TO_IO: R704.2; also elsewhere on the board
SERIAL_IO_TO_FMU: R703.2; also elsewhere on the board
VBAT: U701.1 (VBAT); also elsewhere on the board
VDD_3V3_SPEKTRUM: D701.C, J701.1; also elsewhere on the board
VDD_3V3_SPEKTRUM_EN: R706.1, U701.2 (PC13)
VDD_SERVO_SENS: U701.14 (PA4); also elsewhere on the board

Notes on the sheet:
IO SoC Ports Spektrum/DSM port
LED3 moves to PB13 to make room for S.Bus output
Routed to FMU for debug purposes
IO_SERIAL1
Spektrum/DSM
Timer allocation: PA0: TIM2_CH1: IO-CH1 PA1: TIM2_CH2: IO-CH2 PB8: TIM4_CH3: IO-CH3 PB9: TIM4_CH4: IO-CH4 PA6: TIM3_CH1: IO-CH5 PA7: TIM3_CH2: IO-CH6 PB0: TIM3_CH3: IO-CH7 PB1: TIM3_CH4: IO-CH8 PA8: TIM1_CH1: PPM_IN PA11: TIM1_CH4: RSSI_IN
spare pwm
spare gpio
ARM_MINI_JTAG-SMT

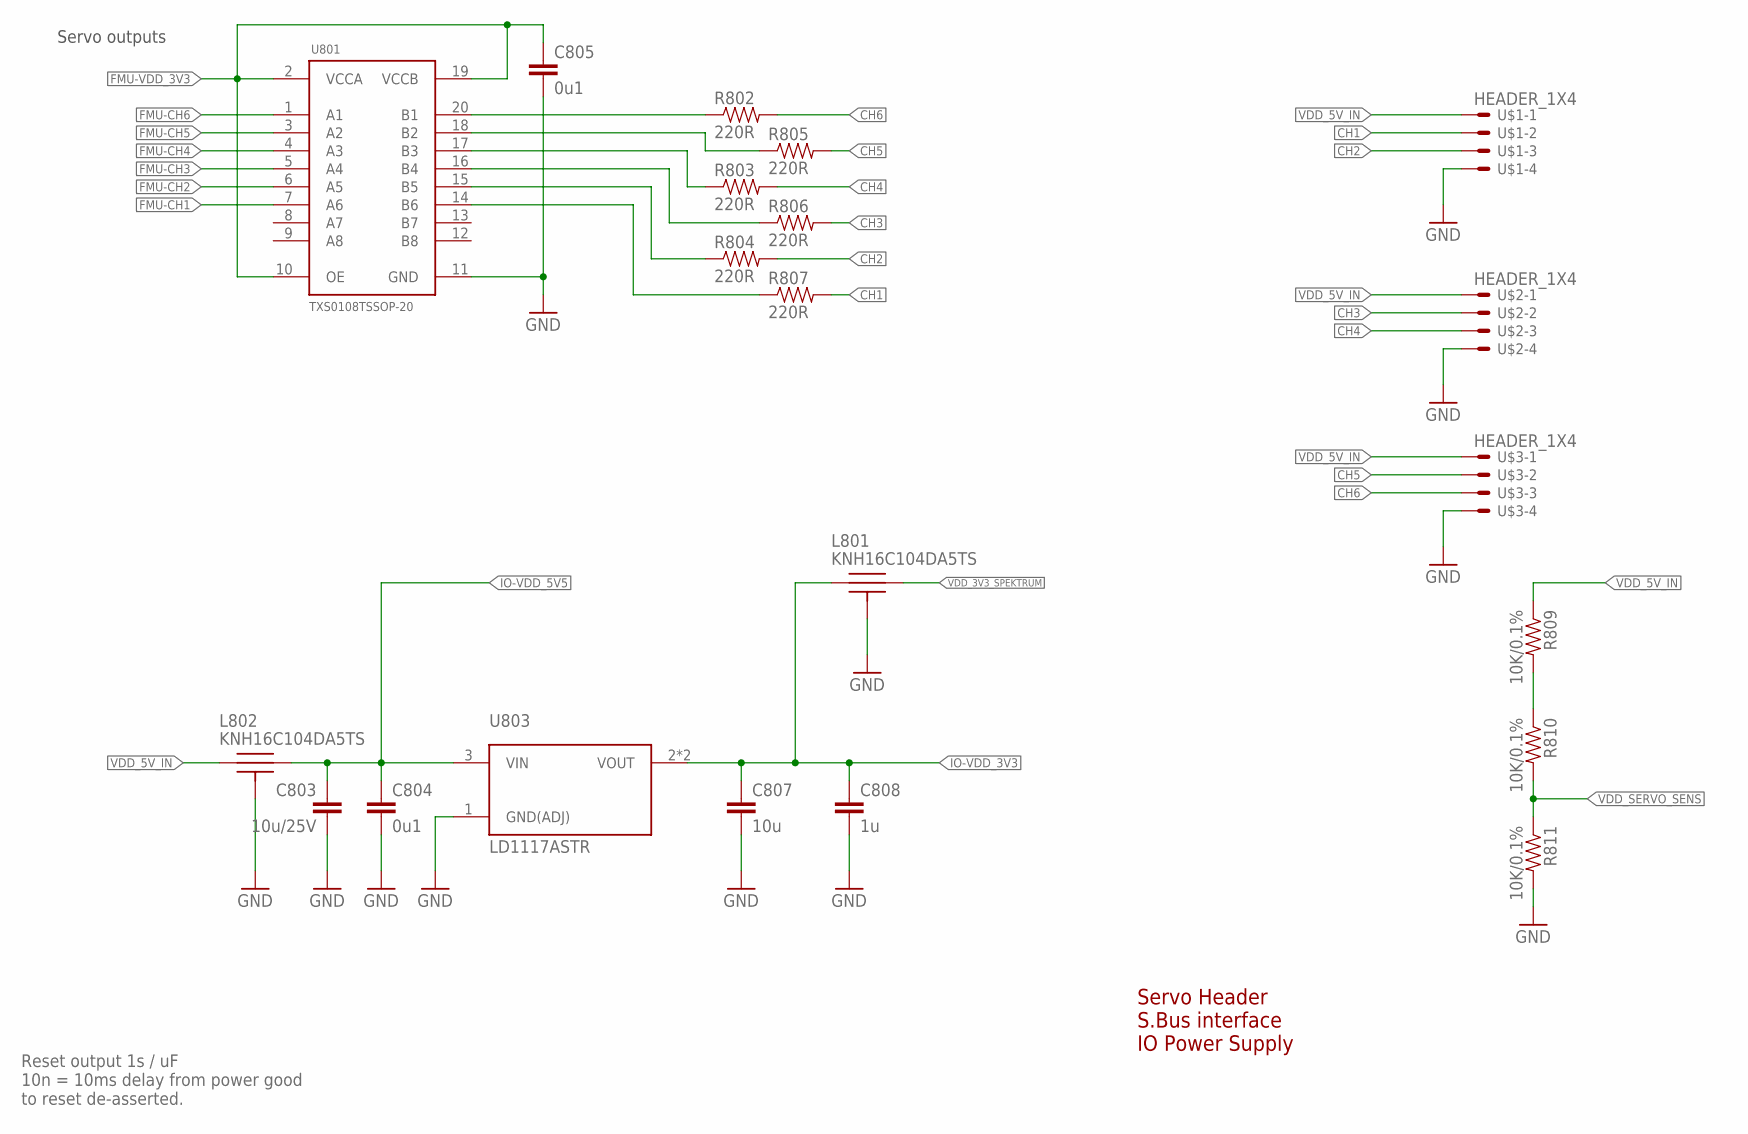
[picture p8: schematic FMU_V.2.sch, sheet 8]

Parts:
C803: 10u/25V; 0805-CAP
C804, C805: 0u1; 0603-CAP
C807: 10u; 0603-CAP
C808: 1u; 0603-CAP
L801, L802: KNH16C104DA5TS; KYOCERA-KNH16-DA
R802, R803, R804, R805, R806, R807: 220R; 0603-RES
R809, R810, R811: 10K/0.1%; 0603-RES
U801: TXS0108TSSOP-20; R-PDSO-G20
U803: LD1117ASTR; SOT-223
U$1, U$2, U$3: HEADER_1X4; HEADER_2.54MM-1X04

Connections:
CH1: R807.2, U$1.2
CH2: R804.2, U$1.3
CH3: R806.2, U$2.2
CH4: R803.2, U$2.3
CH5: R805.2, U$3.2
CH6: R802.2, U$3.3
FMU-CH1: U801.7 (A6); also elsewhere on the board
FMU-CH2: U801.6 (A5); also elsewhere on the board
FMU-CH3: U801.5 (A4); also elsewhere on the board
FMU-CH4: U801.4 (A3); also elsewhere on the board
FMU-CH5: U801.3 (A2); also elsewhere on the board
FMU-CH6: U801.1 (A1); also elsewhere on the board
FMU-VDD_3V3: C805.P$1 (1), U801.2 (VCCA), U801.10 (OE), U801.19 (VCCB); also elsewhere on the board
GND: C803.P$2 (2), C804.P$2 (2), C805.P$2 (2), C807.P$2 (2), C808.P$2 (2), L801.P$3, L801.P$4, L801.P$5, L802.P$3, L802.P$4, L802.P$5, R811.2, U801.11 (GND), U803.1 (GND(ADJ)), U$1.4, U$2.4, U$3.4; also elsewhere on the board
IO-VDD_3V3: C807.P$1 (1), C808.P$1 (1), L801.P$1, U803.2 (VOUT), U803.4 (VOUT); also elsewhere on the board
IO-VDD_5V5: C803.P$1 (1), C804.P$1 (1), L802.P$2, U803.3 (VIN); also elsewhere on the board
unnamed: R809.2, R810.1
unnamed: R802.1, U801.20 (B1)
unnamed: R805.1, U801.18 (B2)
unnamed: R803.1, U801.17 (B3)
unnamed: R806.1, U801.16 (B4)
unnamed: R804.1, U801.15 (B5)
unnamed: R807.1, U801.14 (B6)
VDD_3V3_SPEKTRUM: L801.P$2; also elsewhere on the board
VDD_5V_IN: L802.P$1, R809.1, U$1.1, U$2.1, U$3.1; also elsewhere on the board
VDD_SERVO_SENS: R810.2, R811.1; also elsewhere on the board

Notes on the sheet:
Servo Header S.Bus interface IO Power Supply
Servo outputs
Reset output 1s / uF 10n = 10ms delay from power good to reset de-asserted.

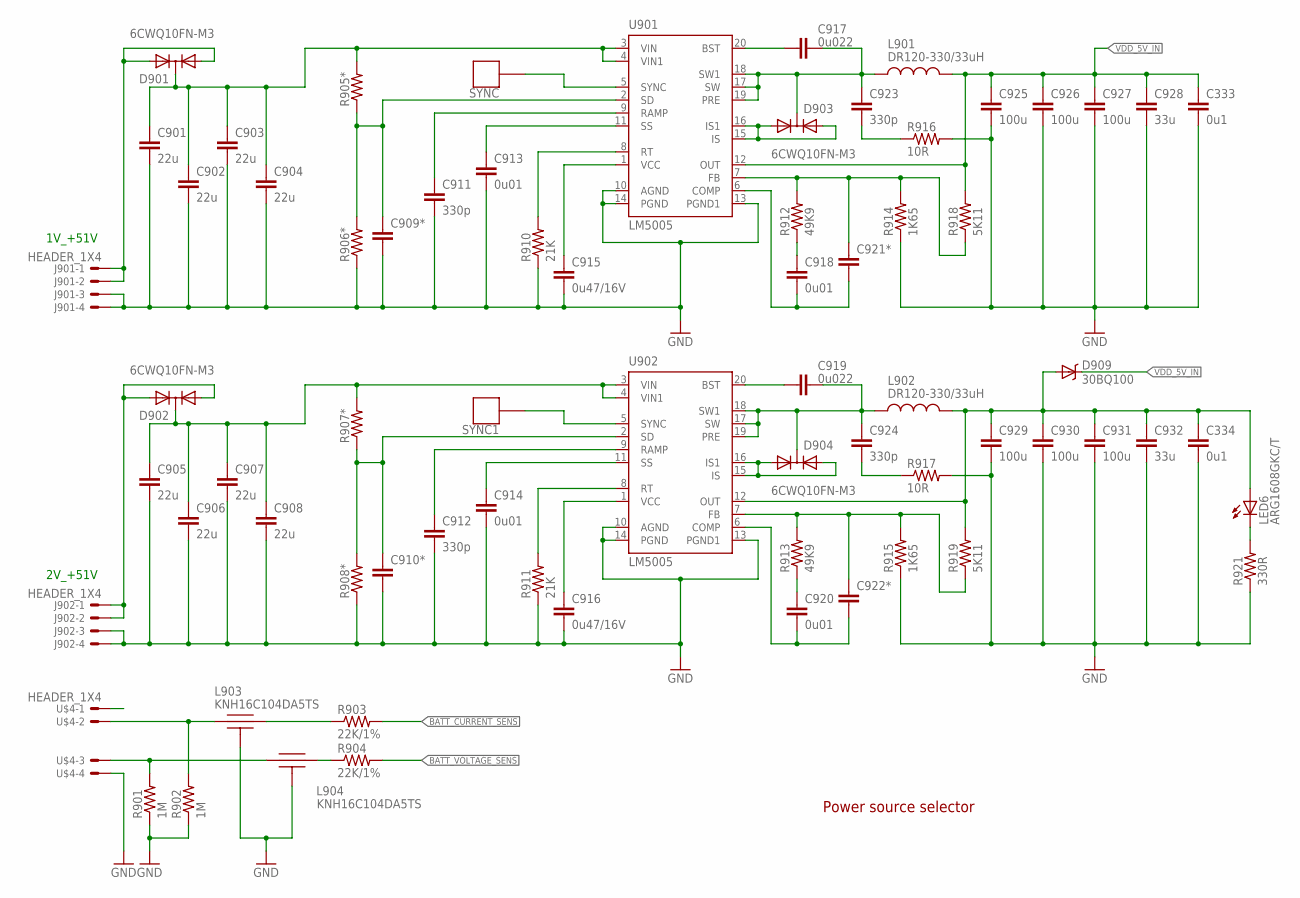
[picture p9: schematic FMU_V.2.sch, sheet 9]

Parts:
C333, C334: 0u1; 0805-CAP
C901, C902, C903, C904, C905, C906, C907, C908: 22u; 1812-CAP
C909*, C910*, C921*, C922*: CAP0805; 0805-CAP
C911, C912, C923, C924: 330p; 0805-CAP
C913, C914, C918, C920: 0u01; 0805-CAP
C915, C916: 0u47/16V; 0805-CAP
C917, C919: 0u022; 0805-CAP
C925, C926, C927, C929, C930, C931: 100u; 1206-CAP
C928, C932: 33u; 1206-CAP
D901, D902, D903, D904: 6CWQ10FN-M3; DPAK
D909: 30BQ100; SMA-DIODE
J901, J902: HEADER_1X4; HEADER_2.54MM-1X04
L901, L902: DR120-330/33uH; SLF10145
L903, L904: KNH16C104DA5TS; KYOCERA-KNH16-DA; PARTNO KNH16C104DA5TS
LED6: ARG1608GKC/T; 0603-LED
R901, R902: 1M; 0603-RES
R903, R904: 22K/1%; 0603-RES
R905*, R906*, R907*, R908*: RESISTOR0805; 0805
R910, R911: 21K; 0805
R912, R913: 49K9; 0805
R914, R915: 1K65; 0805
R916, R917: 10R; R2512
R918, R919: 5K11; 0805
R921: 330R; 0603-RES
SYNC, SYNC1: PAD.03; PAD.03X.03
U901, U902: LM5005; TSSOP20
U$4: HEADER_1X4; HEADER_2.54MM-1X04

Connections:
BATT_CURRENT_SENS: R903.2; also elsewhere on the board
BATT_VOLTAGE_SENS: R904.2; also elsewhere on the board
CURRENT: L903.P$1, R902.2, U$4.2
GND: C333.P$2 (2), C334.P$2 (2), C901.2, C902.2, C903.2, C904.2, C905.2, C906.2, C907.2, C908.2, C909*.P$2 (2), C910*.P$2 (2), C911.P$2 (2), C912.P$2 (2), C913.P$2 (2), C914.P$2 (2), C915.P$2 (2), C916.P$2 (2), C925.P$2 (2), C926.P$2 (2), C927.P$2 (2), C928.P$2 (2), C929.P$2 (2), C930.P$2 (2), C931.P$2 (2), C932.P$2 (2), J901.3, J901.4, J902.3, J902.4, L903.P$3, L903.P$4, L903.P$5, L904.P$3, L904.P$4, L904.P$5, R901.1, R902.1, R906*.1, R908*.1, R910.1, R911.1, R914.1, R915.1, R916.2, R917.2, R921.1, U901.10 (AGND), U901.13 (PGND1), U901.14 (PGND), U902.10 (AGND), U902.13 (PGND1), U902.14 (PGND), U$4.4; also elsewhere on the board
unnamed: C918.P$1 (1), R912.1
unnamed: LED6.C, R921.2
unnamed: C920.P$1 (1), R913.1
unnamed: C911.P$1 (1), U901.9 (RAMP)
unnamed: D903.1 (A1), D903.3 (A2), U901.15 (IS), U901.16 (IS1)
unnamed: SYNC.P$1, U901.5 (SYNC)
unnamed: C909*.P$1 (1), R905*.1, R906*.2, U901.2 (SD)
unnamed: C913.P$1 (1), U901.11 (SS)
unnamed: D901.1 (A1), D901.3 (A2), J901.1, J901.2
unnamed: C901.1, C902.1, C903.1, C904.1, D901.4 (C), R905*.2, U901.3 (VIN), U901.4 (VIN1)
unnamed: C334.P$1 (1), C929.P$1 (1), C930.P$1 (1), C931.P$1 (1), C932.P$1 (1), D909.A, L902.P$2 (2), LED6.A, R919.2, U902.12 (OUT)
unnamed: C917.P$2 (2), C923.P$1 (1), D903.4 (C), L901.P$1 (1), U901.17 (SW), U901.18 (SW1), U901.19 (PRE)
unnamed: C915.P$1 (1), U901.1 (VCC)
unnamed: L904.P$2, R904.1
unnamed: L903.P$2, R903.1
unnamed: C905.1, C906.1, C907.1, C908.1, D902.4 (C), R907*.2, U902.3 (VIN), U902.4 (VIN1)
unnamed: R910.2, U901.8 (RT)
unnamed: C917.P$1 (1), U901.20 (BST)
unnamed: C923.P$2 (2), R916.1
unnamed: C916.P$1 (1), U902.1 (VCC)
unnamed: C921*.P$1 (1), R912.2, R914.2, R918.1, U901.7 (FB)
unnamed: C918.P$2 (2), C921*.P$2 (2), U901.6 (COMP)
unnamed: R911.2, U902.8 (RT)
unnamed: C914.P$1 (1), U902.11 (SS)
unnamed: C912.P$1 (1), U902.9 (RAMP)
unnamed: SYNC1.P$1, U902.5 (SYNC)
unnamed: C910*.P$1 (1), R907*.1, R908*.2, U902.2 (SD)
unnamed: D902.1 (A1), D902.3 (A2), J902.1, J902.2
unnamed: D904.1 (A1), D904.3 (A2), U902.15 (IS), U902.16 (IS1)
unnamed: C919.P$2 (2), C924.P$1 (1), D904.4 (C), L902.P$1 (1), U902.17 (SW), U902.18 (SW1), U902.19 (PRE)
unnamed: C919.P$1 (1), U902.20 (BST)
unnamed: C924.P$2 (2), R917.1
unnamed: C922*.P$1 (1), R913.2, R915.2, R919.1, U902.7 (FB)
unnamed: C920.P$2 (2), C922*.P$2 (2), U902.6 (COMP)
VDD_5V_IN: C333.P$1 (1), C925.P$1 (1), C926.P$1 (1), C927.P$1 (1), C928.P$1 (1), D909.C, L901.P$2 (2), R918.2, U901.12 (OUT); also elsewhere on the board
VOLTAGE: L904.P$1, R901.2, U$4.3

Notes on the sheet:
Power source selector
1V_+51V
2V_+51V

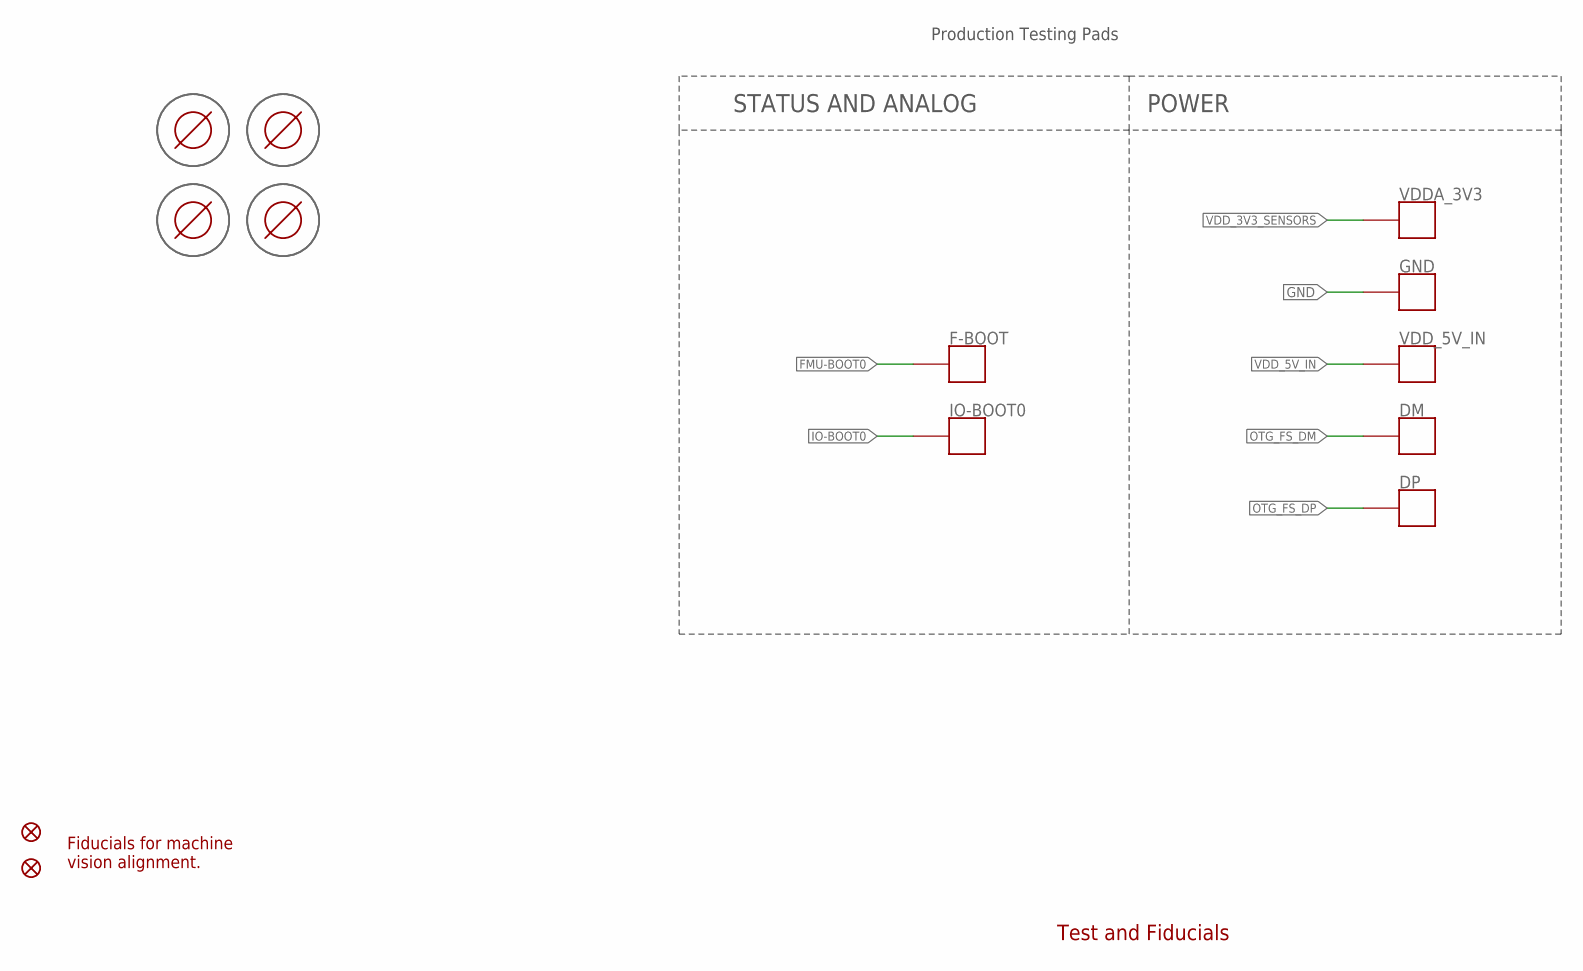
[picture p10: schematic FMU_V.2.sch, sheet 10]

Parts:
DM: PAD.04; PAD.04X.04; PARTNO *
DP: OTG_FS_DP; PAD.04X.04; PARTNO *
F-BOOT: PAD.04; PAD.04X.04; PARTNO *
GND: PAD.04; PAD.04X.04; PARTNO *
IO-BOOT0: PAD.04; PAD.04X.04; PARTNO *
JP3, JP4: FIDUCIAL1.5X3; FIDUCIAL-1.5X3
M3_MOUNT1, M3_MOUNT2, M3_MOUNT3, M3_MOUNT4: MOUNT-HOLE3.1MM; MOUNT-HOLE3.1; PARTNO *
VDDA_3V3: PAD.04; PAD.04X.04; PARTNO *
VDD_5V_IN: PAD.04; PAD.04X.04; PARTNO *

Connections:
FMU-BOOT0: F-BOOT.P$1; also elsewhere on the board
GND: GND.P$1; also elsewhere on the board
IO-BOOT0: IO-BOOT0.P$1; also elsewhere on the board
OTG_FS_DM: DM.P$1; also elsewhere on the board
OTG_FS_DP: DP.P$1; also elsewhere on the board
VDD_3V3_SENSORS: VDDA_3V3.P$1; also elsewhere on the board
VDD_5V_IN: VDD_5V_IN.P$1; also elsewhere on the board

Notes on the sheet:
Production Testing Pads
Test and Fiducials
Fiducials for machine vision alignment.
POWER
STATUS AND ANALOG

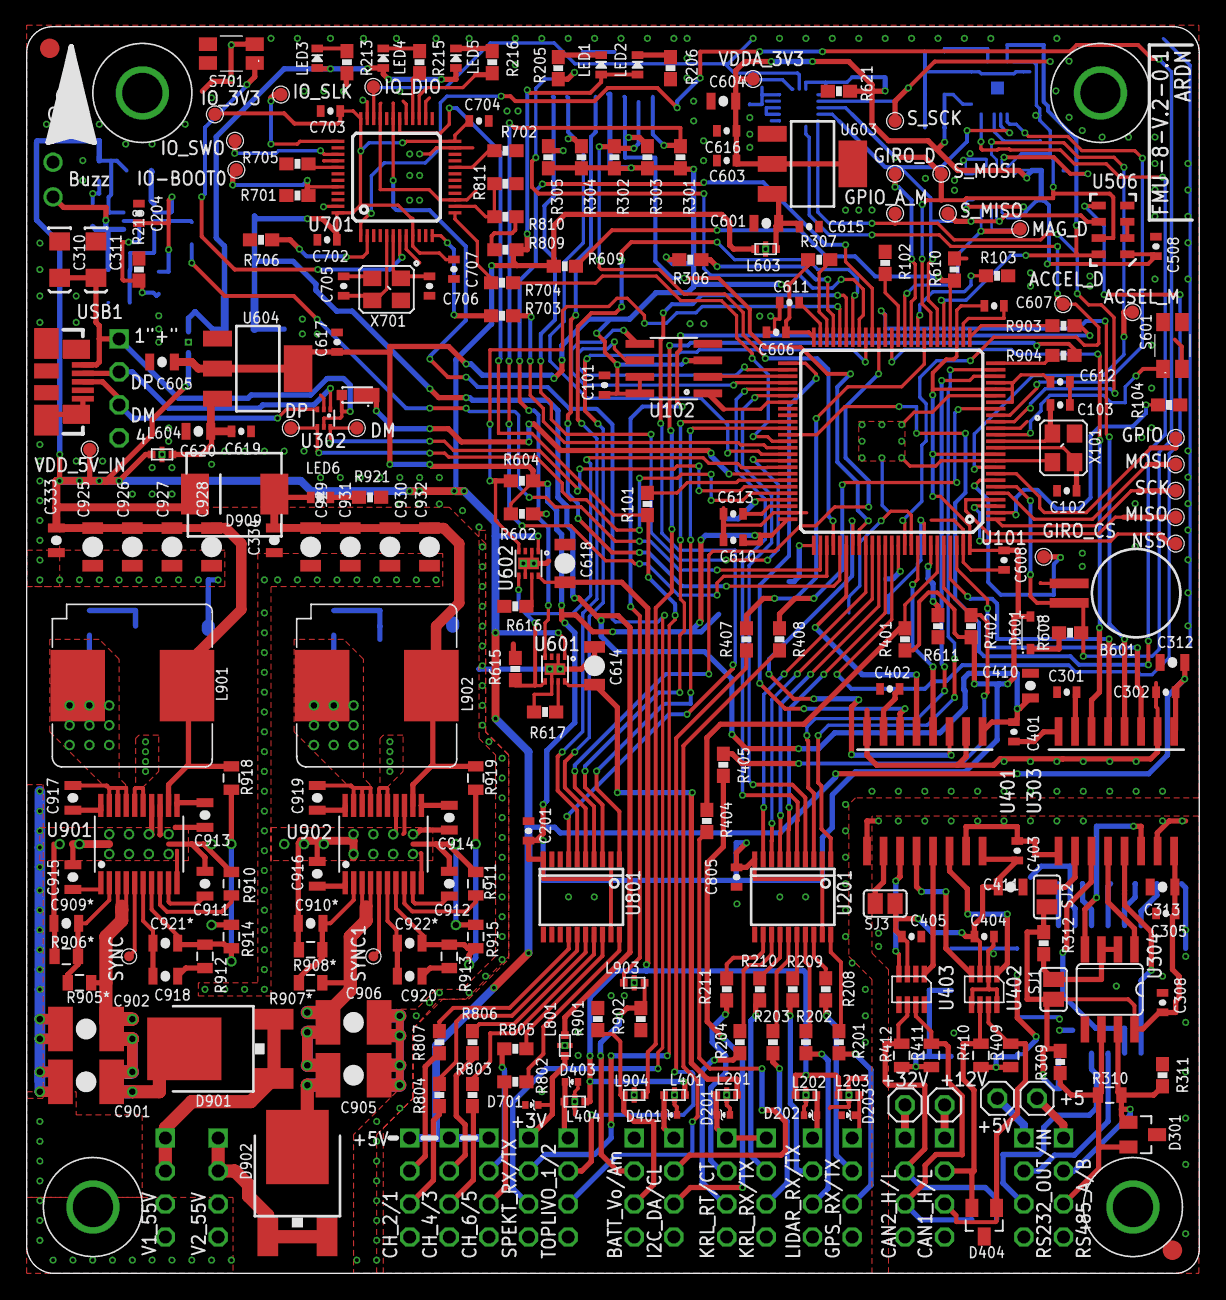
[picture p11: board FMU_V.2.brd from above]

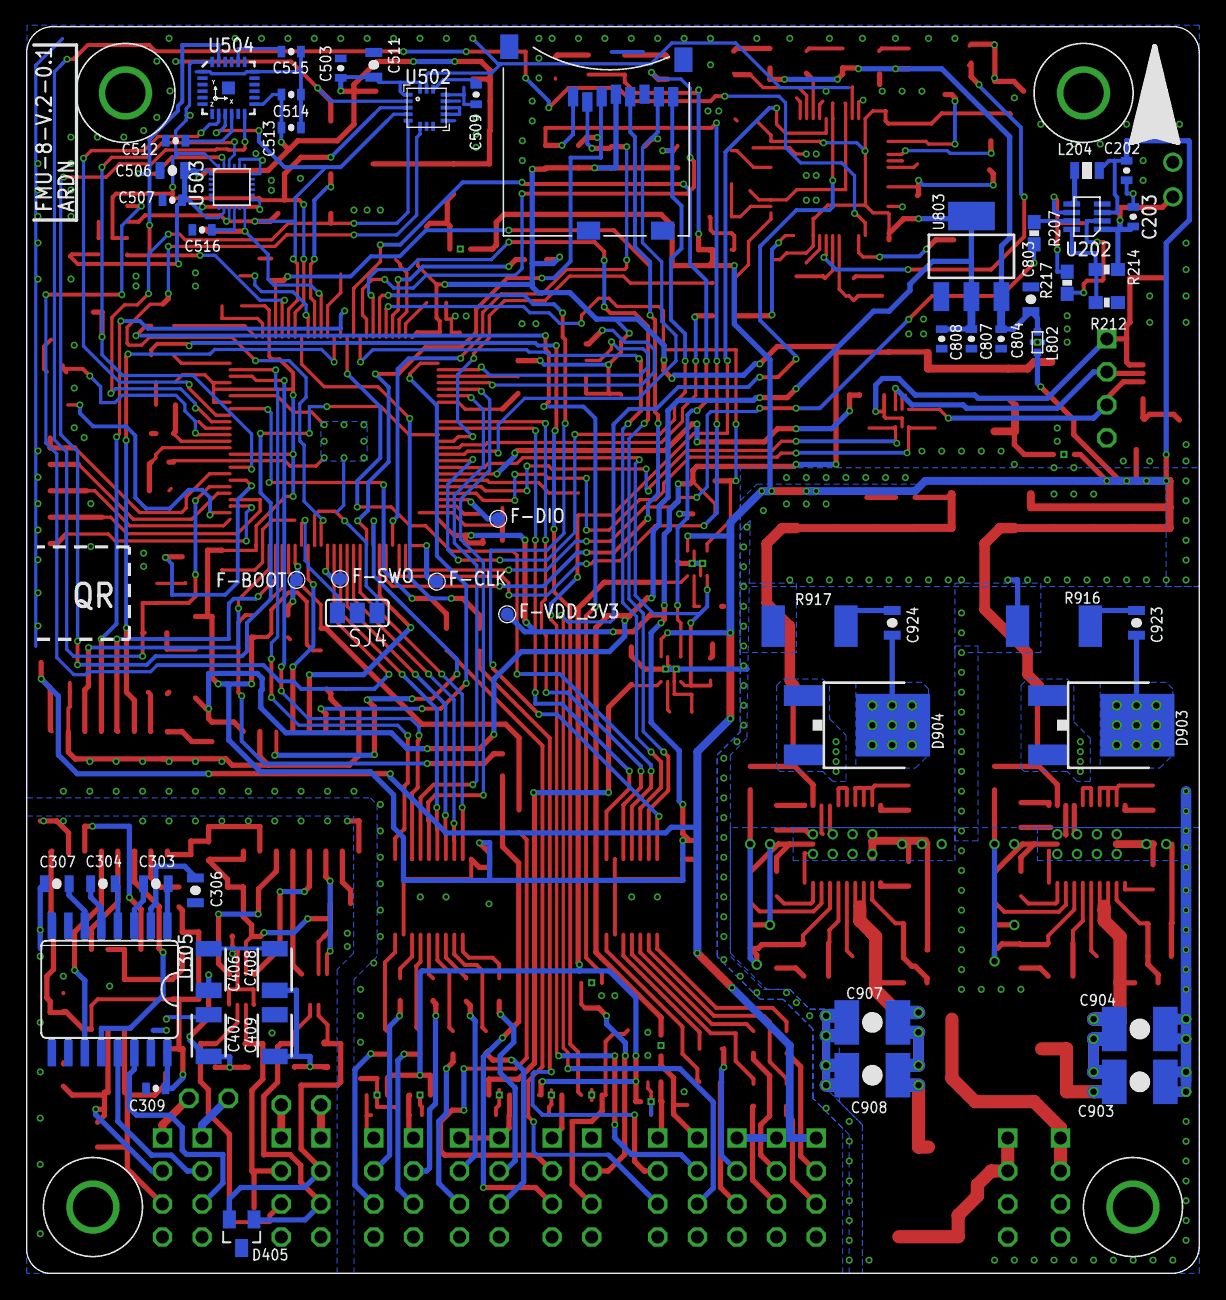
[picture p12: board FMU_V.2.brd from below]

Board: 2 copper layers, 90.2 x 95.9 mm, 322 parts (56 on the bottom side), 244 nets.
