Viktor-Matitsin/Hardware/FMU_V.1/PC104.brd

## EAGLE design FMU_V.1/PC104.brd (2017-08-15, an earlier design)

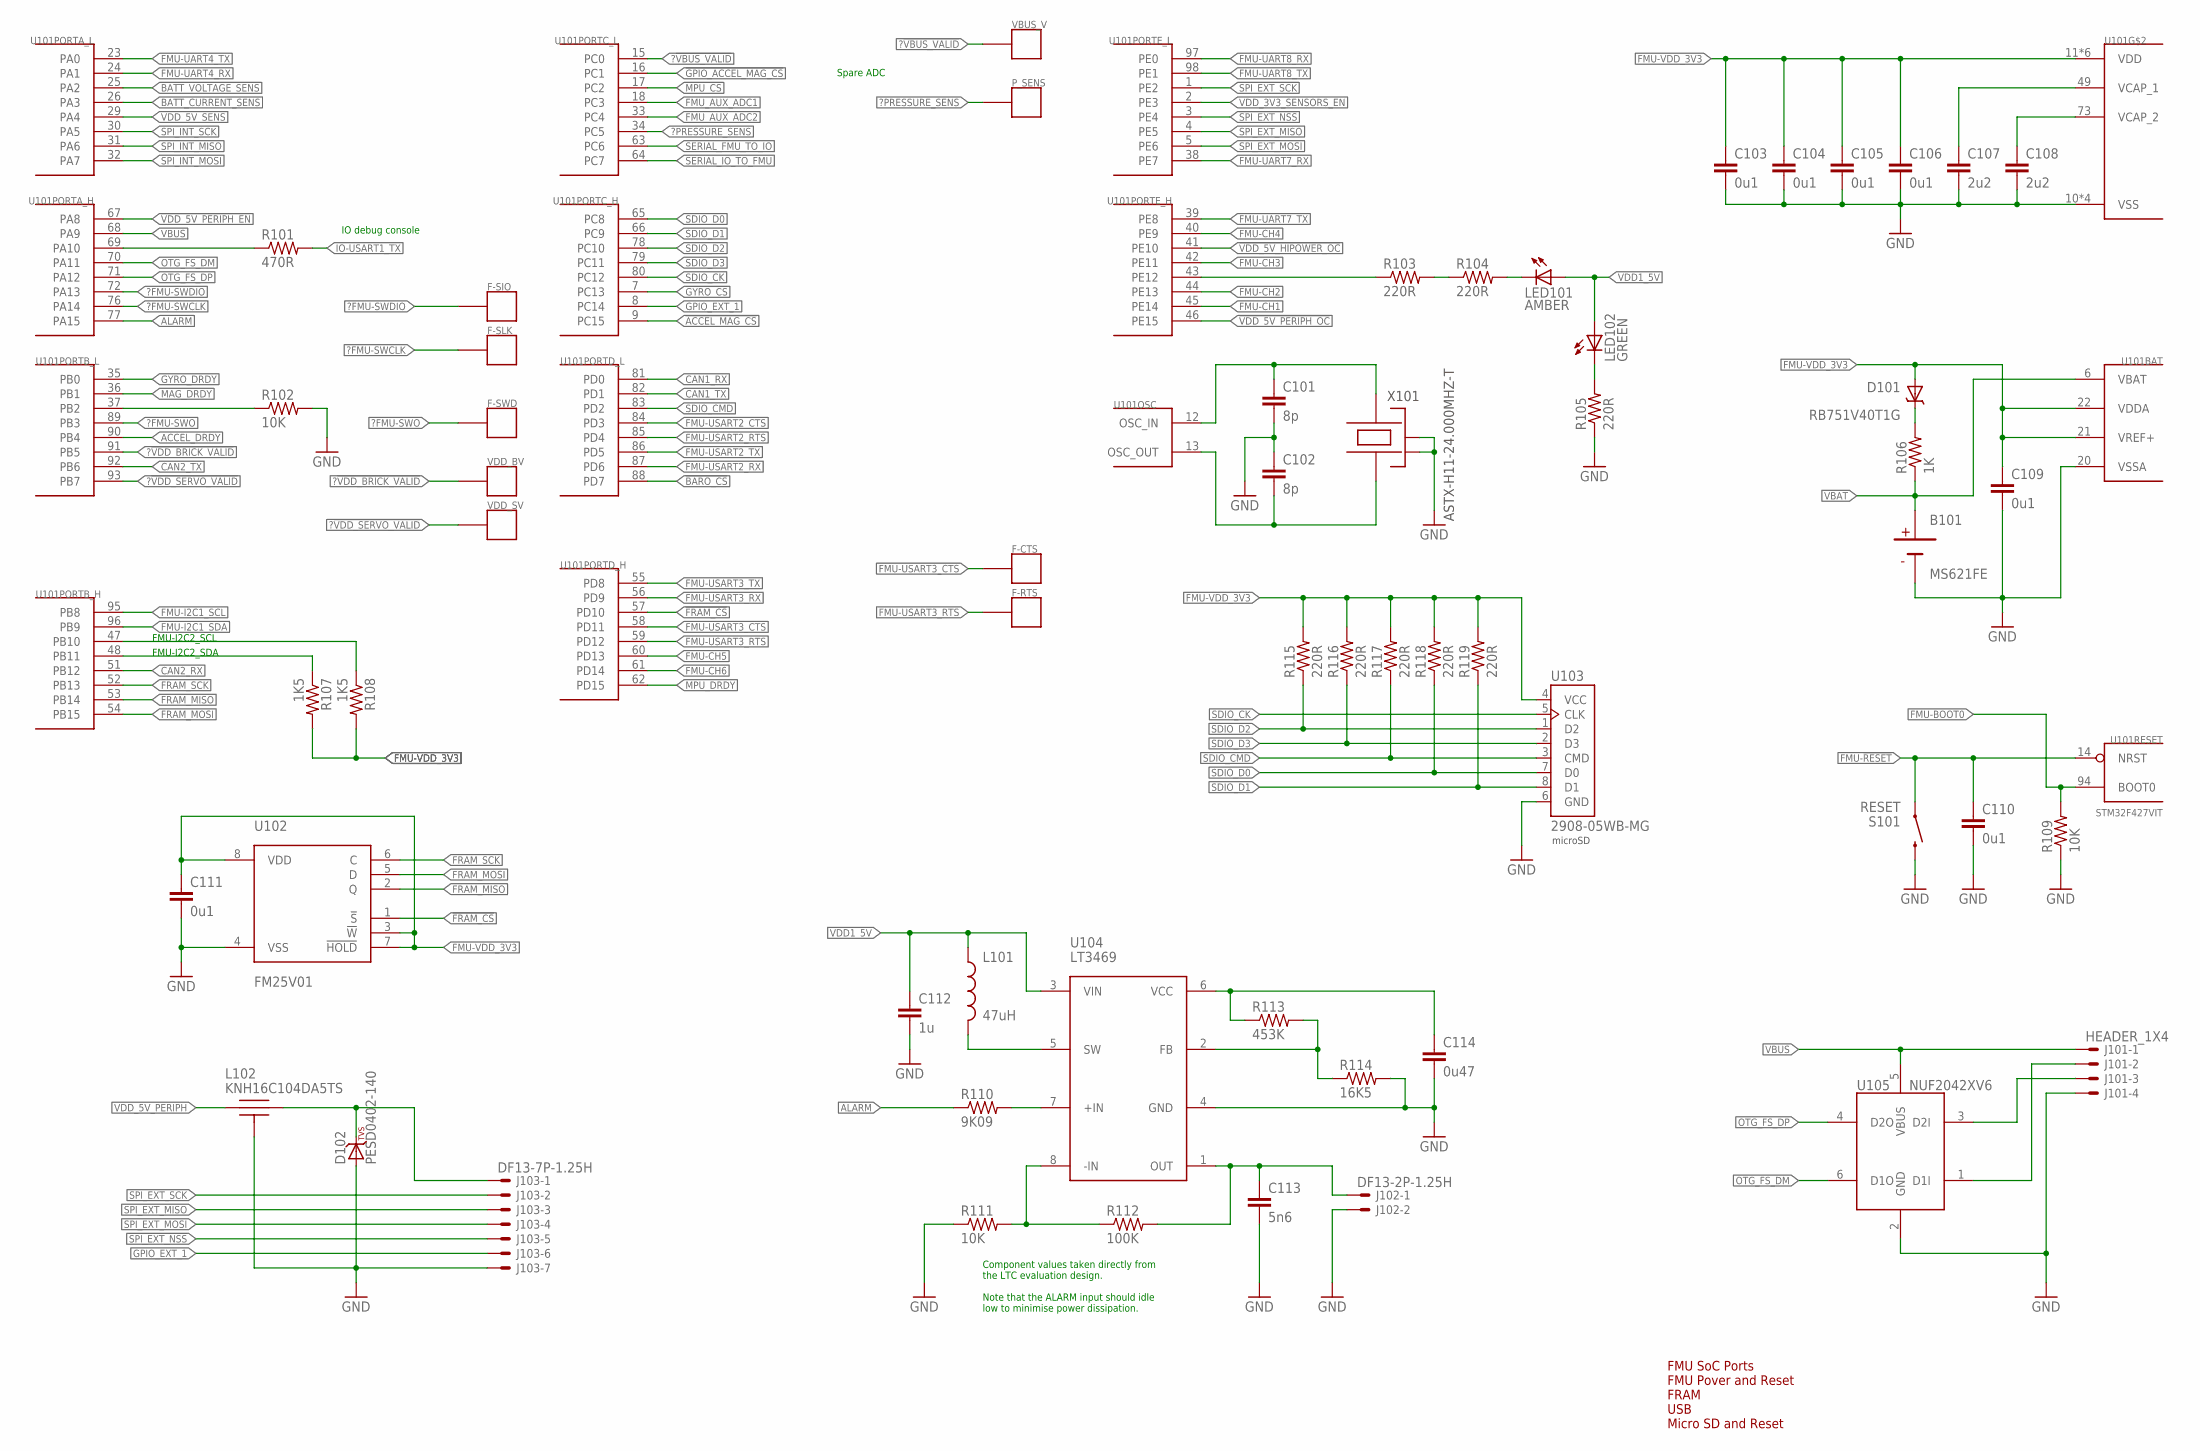
[picture p13: schematic PC104.sch, sheet 1]

Parts:
B101: MS621FE
C101, C102: 8p; 0603-CAP
C103, C104, C105, C106, C109, C110, C111: 0u1; 0603-CAP
C107, C108: 2u2; 0603-CAP
C112: 1u; 0603-CAP
C113: 5n6; 0603-CAP
C114: 0u47; 0603-CAP
D101: RB751V40T1G; SOD323
D102: PESD0402-140; 0402-TVS
F-CTS: PAD.04; PAD.04X.04
F-RTS: PAD.04; PAD.04X.04
F-SIO: PAD.04; PAD.04X.04
F-SLK: PAD.04; PAD.04X.04
F-SWD: PAD.04; PAD.04X.04
J101: HEADER_1X4; HEADER_2.54MM-1X04
J102: DF13-2P-1.25H; DF13A-2P-1.25H
J103: DF13-7P-1.25H; DF13A-7P-1.25H
L101: 47uH; 0805-IND
L102: KNH16C104DA5TS; KYOCERA-KNH16-DA
LED101: AMBER; 0603-LED
LED102: GREEN; 0603-LED
P_SENS: PAD.04; PAD.04X.04
R101: 470R; 0603-RES
R102, R109, R111: 10K; 0603-RES
R103, R104, R105, R115, R116, R117, R118, R119: 220R; 0603-RES
R106: 1K; 0603-RES
R107, R108: 1K5; 0603-RES
R110: 9K09; 0603-RES
R112: 100K; 0603-RES
R113: 453K; 0603-RES
R114: 16K5; 0603-RES
S101: RESET; EVQP7J01K
U101: STM32F427VIT; TQFP100
U102: FM25V01; SO08
U103: 2908-05WB-MG; MICROSD
U104: LT3469; SOT23-8
U105: NUF2042XV6; SOT563-6
VBUS_V: PAD.04; PAD.04X.04
VDD_BV: PAD.04; PAD.04X.04
VDD_SV: PAD.04; PAD.04X.04
X101: ASTX-H11-24.000MHZ-T; OSCILLATOR-3.2X2.5

Connections:
!ACCEL_MAG_CS: U101.9 (PC15); also elsewhere on the board
!BARO_CS: U101.88 (PD7); also elsewhere on the board
!FRAM_CS: U101.57 (PD10), U102.1 (!S)
!GPIO_ACCEL_MAG_CS: U101.16 (PC1); also elsewhere on the board
!GYRO_CS: U101.7 (PC13); also elsewhere on the board
!MPU_CS: U101.17 (PC2); also elsewhere on the board
!SPI_EXT_NSS: J103.5, U101.3 (PE4)
!VDD_5V_HIPOWER_OC: U101.41 (PE10); also elsewhere on the board
!VDD_5V_PERIPH_EN: U101.67 (PA8); also elsewhere on the board
!VDD_5V_PERIPH_OC: U101.46 (PE15); also elsewhere on the board
?!VBUS_VALID: U101.15 (PC0), VBUS_V.P$1
?!VDD_BRICK_VALID: U101.91 (PB5), VDD_BV.P$1
?!VDD_SERVO_VALID: U101.93 (PB7), VDD_SV.P$1
?FMU-SWCLK: F-SLK.P$1, U101.76 (PA14)
?FMU-SWDIO: F-SIO.P$1, U101.72 (PA13)
?FMU-SWO: F-SWD.P$1, U101.89 (PB3)
?PRESSURE_SENS: P_SENS.P$1, U101.34 (PC5)
ACCEL_DRDY: U101.90 (PB4); also elsewhere on the board
ALARM: R110.1, U101.77 (PA15)
BATT_CURRENT_SENS: U101.26 (PA3); also elsewhere on the board
BATT_VOLTAGE_SENS: U101.25 (PA2); also elsewhere on the board
CAN1_RX: U101.81 (PD0); also elsewhere on the board
CAN1_TX: U101.82 (PD1); also elsewhere on the board
CAN2_RX: U101.51 (PB12); also elsewhere on the board
CAN2_TX: U101.92 (PB6); also elsewhere on the board
FMU-!RESET: C110.P$1 (1), S101.A1 (1), U101.14 (NRST)
FMU-BOOT0: R109.2, U101.94 (BOOT0)
FMU-CH1: U101.45 (PE14); also elsewhere on the board
FMU-CH2: U101.44 (PE13); also elsewhere on the board
FMU-CH3: U101.42 (PE11); also elsewhere on the board
FMU-CH4: U101.40 (PE9); also elsewhere on the board
FMU-CH5: U101.60 (PD13); also elsewhere on the board
FMU-CH6: U101.61 (PD14); also elsewhere on the board
FMU-I2C1_SCL: U101.95 (PB8); also elsewhere on the board
FMU-I2C1_SDA: U101.96 (PB9); also elsewhere on the board
FMU-UART4_RX: U101.24 (PA1); also elsewhere on the board
FMU-UART4_TX: U101.23 (PA0); also elsewhere on the board
FMU-UART7_RX: U101.38 (PE7); also elsewhere on the board
FMU-UART7_TX: U101.39 (PE8); also elsewhere on the board
FMU-UART8_RX: U101.97 (PE0); also elsewhere on the board
FMU-UART8_TX: U101.98 (PE1); also elsewhere on the board
FMU-USART2_CTS: U101.84 (PD3); also elsewhere on the board
FMU-USART2_RTS: U101.85 (PD4); also elsewhere on the board
FMU-USART2_RX: U101.87 (PD6); also elsewhere on the board
FMU-USART2_TX: U101.86 (PD5); also elsewhere on the board
FMU-USART3_CTS: F-CTS.P$1, U101.58 (PD11)
FMU-USART3_RTS: F-RTS.P$1, U101.59 (PD12)
FMU-USART3_RX: U101.56 (PD9); also elsewhere on the board
FMU-USART3_TX: U101.55 (PD8); also elsewhere on the board
FMU-VDD_3V3: C103.P$1 (1), C104.P$1 (1), C105.P$1 (1), C106.P$1 (1), C109.P$1 (1), C111.P$1 (1), D101.A, R107.2, R108.2, R115.2, R116.2, R117.2, R118.2, R119.2, U101.11 (VDD), U101.19 (VDD), U101.21 (VREF+), U101.22 (VDDA), U101.28 (VDD), U101.50 (VDD), U101.75 (VDD), U101.100 (VDD), U102.3 (!W), U102.7 (!HOLD), U102.8 (VDD), U103.4 (VCC); also elsewhere on the board
FMU_AUX_ADC1: U101.18 (PC3); also elsewhere on the board
FMU_AUX_ADC2: U101.33 (PC4); also elsewhere on the board
FRAM_MISO: U101.53 (PB14), U102.2 (Q)
FRAM_MOSI: U101.54 (PB15), U102.5 (D)
FRAM_SCK: U101.52 (PB13), U102.6 (C)
GND: B101.2 (NEG), C101.P$2 (2), C102.P$1 (1), C103.P$2 (2), C104.P$2 (2), C105.P$2 (2), C106.P$2 (2), C107.P$2 (2), C108.P$2 (2), C109.P$2 (2), C110.P$2 (2), C111.P$2 (2), C112.P$2 (2), C113.P$2 (2), C114.P$2 (2), D102.A, J101.4, J102.2, J103.7, L102.P$3, L102.P$4, L102.P$5, R102.2, R105.1, R109.1, R111.1, R114.2, S101.B3 (2), U101.10 (VSS), U101.20 (VSSA), U101.27 (VSS), U101.74 (VSS), U101.99 (VSS), U102.4 (VSS), U103.6 (GND), U104.4 (GND), U105.2 (GND), X101.2 (NC_2), X101.4 (NC_4); also elsewhere on the board
GPIO_EXT_1: J103.6, U101.8 (PC14)
GYRO_DRDY: U101.35 (PB0); also elsewhere on the board
IO-USART1_TX: R101.2; also elsewhere on the board
MAG_DRDY: U101.36 (PB1); also elsewhere on the board
MPU_DRDY: U101.62 (PD15); also elsewhere on the board
unnamed: J101.3, U105.3 (D2I)
unnamed: C108.P$1 (1), U101.73 (VCAP_2)
unnamed: C102.P$2 (2), U101.13 (OSC_OUT), X101.1
unnamed: C101.P$1 (1), U101.12 (OSC_IN), X101.3
unnamed: C107.P$1 (1), U101.49 (VCAP_1)
unnamed: J101.2, U105.1 (D1I)
unnamed: R101.1, U101.69 (PA10)
unnamed: D101.C, R106.2
unnamed: R102.1, U101.37 (PB2)
unnamed: R103.1, U101.43 (PE12)
unnamed: C114.P$1 (1), R113.1, U104.6 (VCC)
unnamed: R113.2, R114.1, U104.2 (FB)
unnamed: L101.P$2 (2), U104.5 (SW)
unnamed: R103.2, R104.1
unnamed: LED101.C, R104.2
unnamed: LED102.C, R105.2
unnamed: R111.2, R112.1, U104.8 (-IN)
unnamed: C113.P$1 (1), J102.1, R112.2, U104.1 (OUT)
unnamed: R110.2, U104.7 (+IN)
unnamed: R108.1, U101.47 (PB10)
unnamed: R107.1, U101.48 (PB11)
unnamed: D102.C, J103.1, L102.P$2
OTG_FS_DM: U101.70 (PA11), U105.6 (D1O)
OTG_FS_DP: U101.71 (PA12), U105.4 (D2O)
SDIO_CK: U101.80 (PC12), U103.5 (CLK)
SDIO_CMD: R117.1, U101.83 (PD2), U103.3 (CMD)
SDIO_D0: R118.1, U101.65 (PC8), U103.7 (D0)
SDIO_D1: R119.1, U101.66 (PC9), U103.8 (D1)
SDIO_D2: R115.1, U101.78 (PC10), U103.1 (D2)
SDIO_D3: R116.1, U101.79 (PC11), U103.2 (D3)
SERIAL_FMU_TO_IO: U101.63 (PC6); also elsewhere on the board
SERIAL_IO_TO_FMU: U101.64 (PC7); also elsewhere on the board
SPI_EXT_MISO: J103.3, U101.4 (PE5)
SPI_EXT_MOSI: J103.4, U101.5 (PE6)
SPI_EXT_SCK: J103.2, U101.1 (PE2)
SPI_INT_MISO: U101.31 (PA6); also elsewhere on the board
SPI_INT_MOSI: U101.32 (PA7); also elsewhere on the board
SPI_INT_SCK: U101.30 (PA5); also elsewhere on the board
VBAT: B101.1 (POS), R106.1, U101.6 (VBAT); also elsewhere on the board
VBUS: J101.1, U101.68 (PA9), U105.5 (VBUS)
VDD1_5V: C112.P$1 (1), L101.P$1 (1), LED101.A, LED102.A, U104.3 (VIN); also elsewhere on the board
VDD_3V3_SENSORS_EN: U101.2 (PE3); also elsewhere on the board
VDD_5V_PERIPH: L102.P$1; also elsewhere on the board
VDD_5V_SENS: U101.29 (PA4); also elsewhere on the board

Notes on the sheet:
FMU SoC Ports FMU Pover and Reset FRAM USB Micro SD and Reset
Component values taken directly from the LTC evaluation design. Note that the ALARM input should idle low to minimise power dissipation.
FMU-I2C2_SCL
FMU-I2C2_SDA
Spare ADC
microSD
IO debug console
