Viktor-Matitsin/Hardware/FMU_V.1/PC104.brd

## EAGLE design FMU_V.1/PC104.brd (continued)

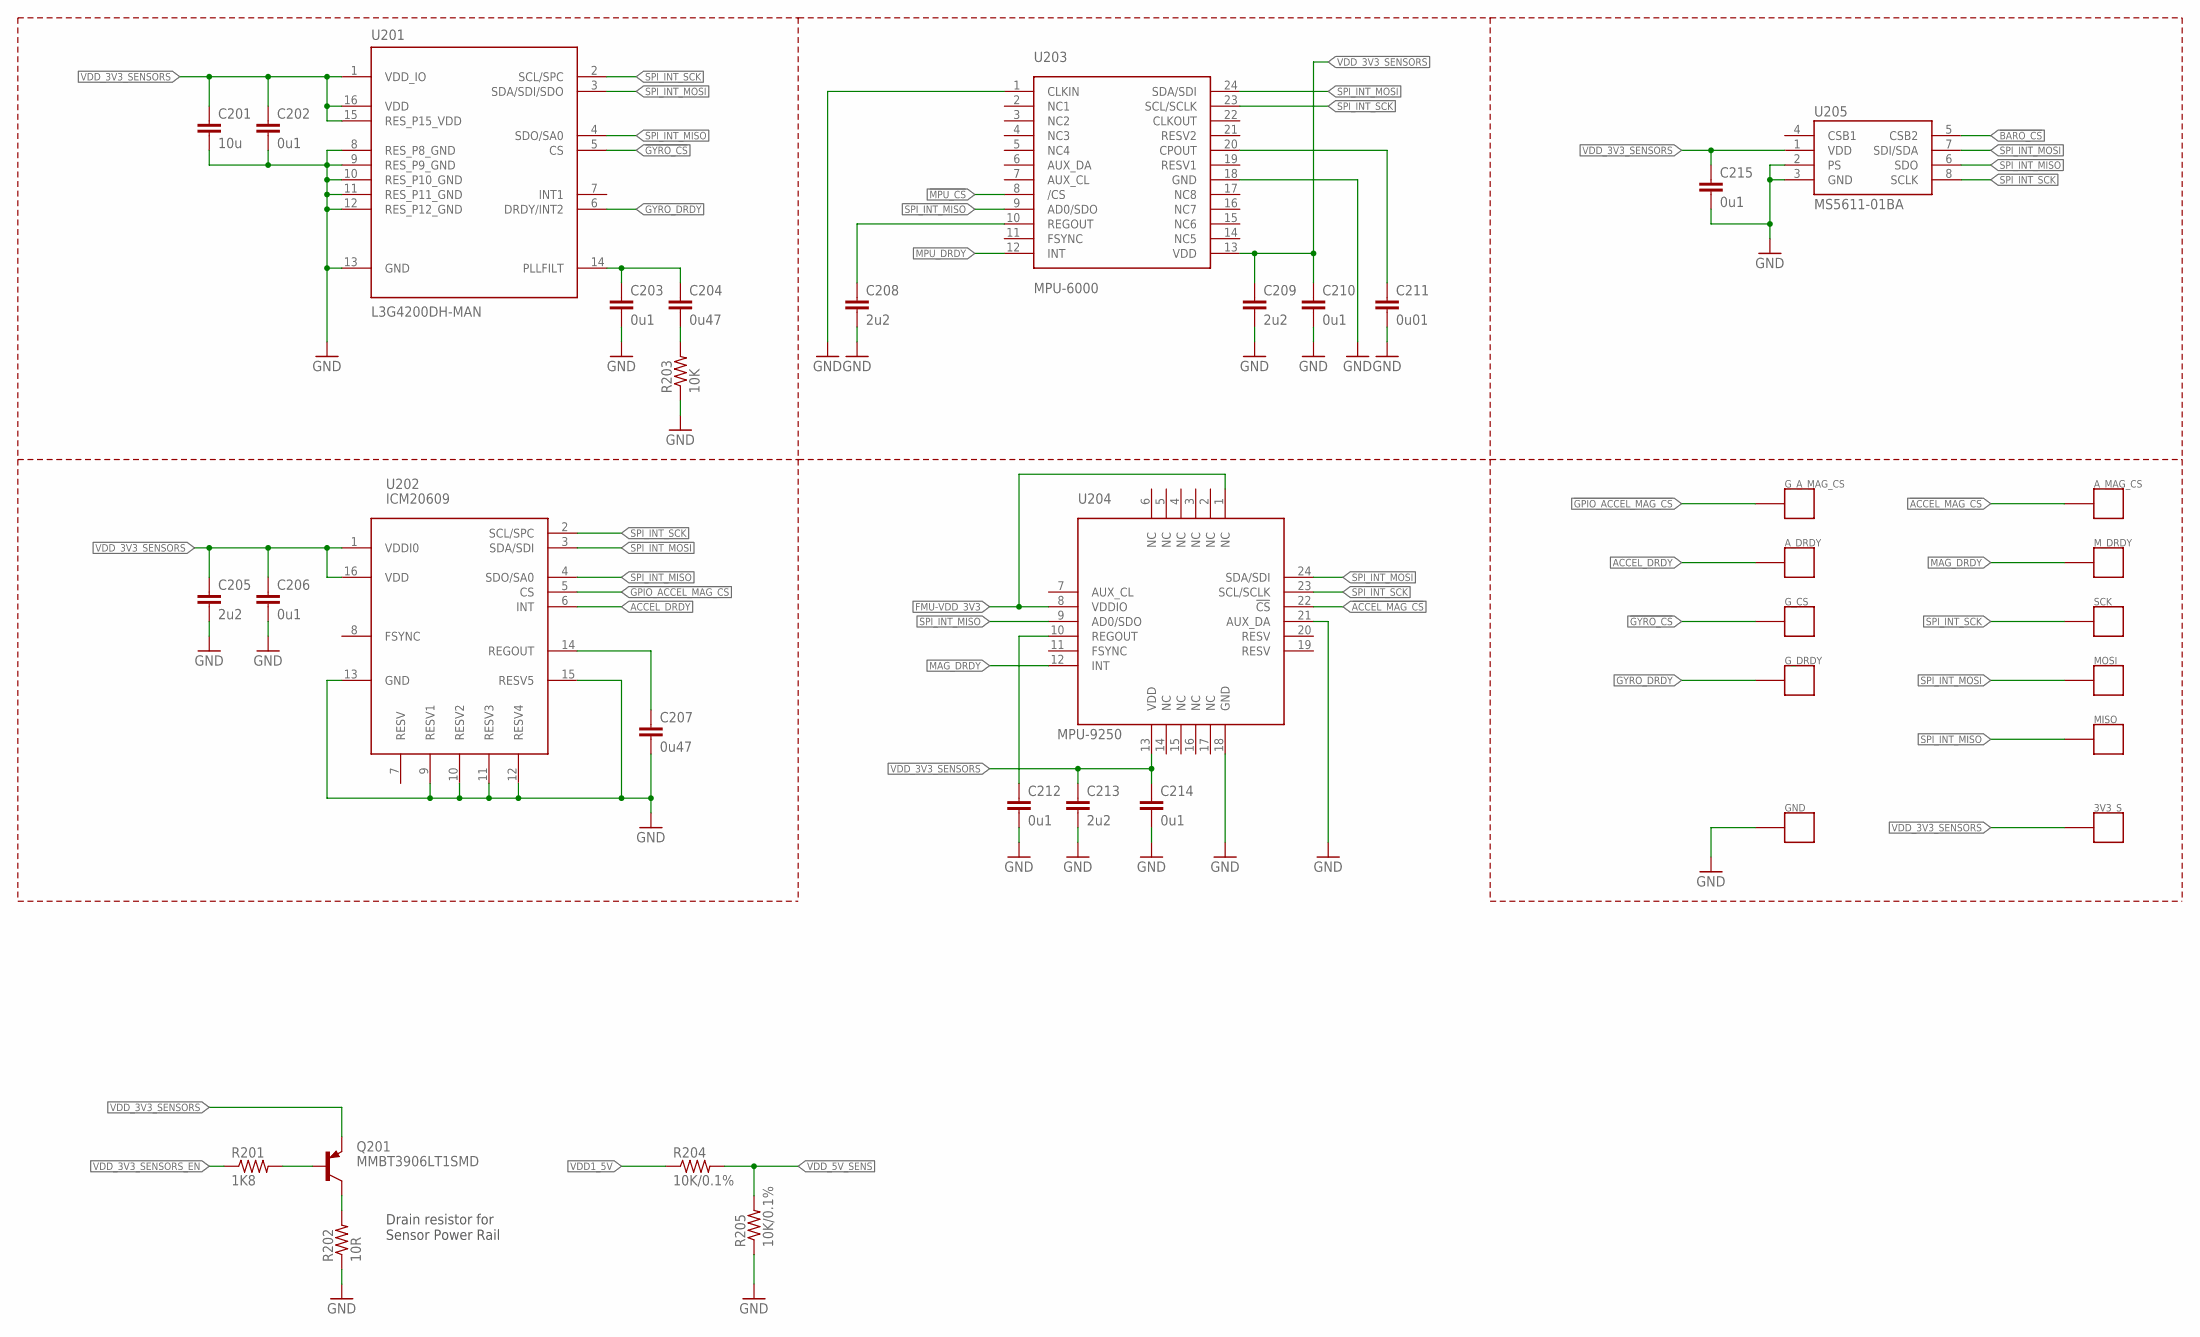
[picture p14: schematic PC104.sch, sheet 2]

Parts:
3V3_S: PAD.04; PAD.04X.04
A_DRDY: PAD.04; PAD.04X.04
A_MAG_CS: PAD.04; PAD.04X.04
C201: 10u; 0805-CAP
C202, C203, C206, C210, C212, C214, C215: 0u1; 0603-CAP
C204, C207: 0u47; 0603-CAP
C205, C208, C209, C213: 2u2; 0603-CAP
C211: 0u01; 0603-CAP
GND: PAD.04; PAD.04X.04
G_A_MAG_CS: PAD.04; PAD.04X.04
G_CS: PAD.04; PAD.04X.04
G_DRDY: PAD.04; PAD.04X.04
MISO: PAD.04; PAD.04X.04
MOSI: PAD.04; PAD.04X.04
M_DRDY: PAD.04; PAD.04X.04
Q201: MMBT3906LT1SMD; SOT23-BEC
R201: 1K8; 0603-RES
R202: 10R; 0603-RES
R203: 10K; 0603-RES
R204, R205: 10K/0.1%; 0603-RES
SCK: PAD.04; PAD.04X.04
U201: L3G4200DH-MAN
U202: ICM20609; LGA-16-3PX5P
U203: MPU-6000; QFN-24
U204: MPU-9250; MPU-6500
U205: MS5611-01BA

Connections:
!ACCEL_MAG_CS: A_MAG_CS.P$1, U204.22 (!CS); also elsewhere on the board
!BARO_CS: U205.5 (CSB2); also elsewhere on the board
!GPIO_ACCEL_MAG_CS: G_A_MAG_CS.P$1, U202.5 (CS); also elsewhere on the board
!GYRO_CS: G_CS.P$1, U201.5 (CS); also elsewhere on the board
!MPU_CS: U203.8 (/CS); also elsewhere on the board
ACCEL_DRDY: A_DRDY.P$1, U202.6 (INT); also elsewhere on the board
FMU-VDD_3V3: U204.1 (NC), U204.8 (VDDIO); also elsewhere on the board
GND: C201.P$2 (2), C202.P$2 (2), C203.P$2 (2), C205.P$2 (2), C206.P$2 (2), C207.P$2 (2), C208.P$2 (2), C209.P$2 (2), C210.P$2 (2), C211.P$2 (2), C212.P$2 (2), C213.P$2 (2), C214.P$2 (2), C215.P$2 (2), GND.P$1, R202.1, R203.1, R205.1, U201.8 (RES_P8_GND), U201.9 (RES_P9_GND), U201.10 (RES_P10_GND), U201.11 (RES_P11_GND), U201.12 (RES_P12_GND), U201.13 (GND), U202.9 (RESV1), U202.10 (RESV2), U202.11 (RESV3), U202.12 (RESV4), U202.13 (GND), U202.15 (RESV5), U203.1 (CLKIN), U203.18 (GND), U204.18 (GND), U204.21 (AUX_DA), U205.2 (PS), U205.3 (GND); also elsewhere on the board
GYRO_DRDY: G_DRDY.P$1, U201.6 (DRDY/INT2); also elsewhere on the board
MAG_DRDY: M_DRDY.P$1, U204.12 (INT); also elsewhere on the board
MPU_DRDY: U203.12 (INT); also elsewhere on the board
unnamed: C204.P$2 (2), R203.2
unnamed: Q201.B, R201.2
unnamed: Q201.C, R202.2
unnamed: C211.P$1 (1), U203.20 (CPOUT)
unnamed: C203.P$1 (1), C204.P$1 (1), U201.14 (PLLFILT)
unnamed: C208.P$1 (1), U203.10 (REGOUT)
unnamed: C212.P$1 (1), U204.10 (REGOUT)
unnamed: C207.P$1 (1), U202.14 (REGOUT)
SPI_INT_MISO: MISO.P$1, U201.4 (SDO/SA0), U202.4 (SDO/SA0), U203.9 (AD0/SDO), U204.9 (AD0/SDO), U205.6 (SDO); also elsewhere on the board
SPI_INT_MOSI: MOSI.P$1, U201.3 (SDA/SDI/SDO), U202.3 (SDA/SDI), U203.24 (SDA/SDI), U204.24 (SDA/SDI), U205.7 (SDI/SDA); also elsewhere on the board
SPI_INT_SCK: SCK.P$1, U201.2 (SCL/SPC), U202.2 (SCL/SPC), U203.23 (SCL/SCLK), U204.23 (SCL/SCLK), U205.8 (SCLK); also elsewhere on the board
VDD1_5V: R204.1; also elsewhere on the board
VDD_3V3_SENSORS: 3V3_S.P$1, C201.P$1 (1), C202.P$1 (1), C205.P$1 (1), C206.P$1 (1), C209.P$1 (1), C210.P$1 (1), C213.P$1 (1), C214.P$1 (1), C215.P$1 (1), Q201.E, U201.1 (VDD_IO), U201.15 (RES_P15_VDD), U201.16 (VDD), U202.1 (VDDI0), U202.16 (VDD), U203.13 (VDD), U204.13 (VDD), U205.1 (VDD); also elsewhere on the board
VDD_3V3_SENSORS_EN: R201.1; also elsewhere on the board
VDD_5V_SENS: R204.2, R205.2; also elsewhere on the board

Notes on the sheet:
Drain resistor for Sensor Power Rail

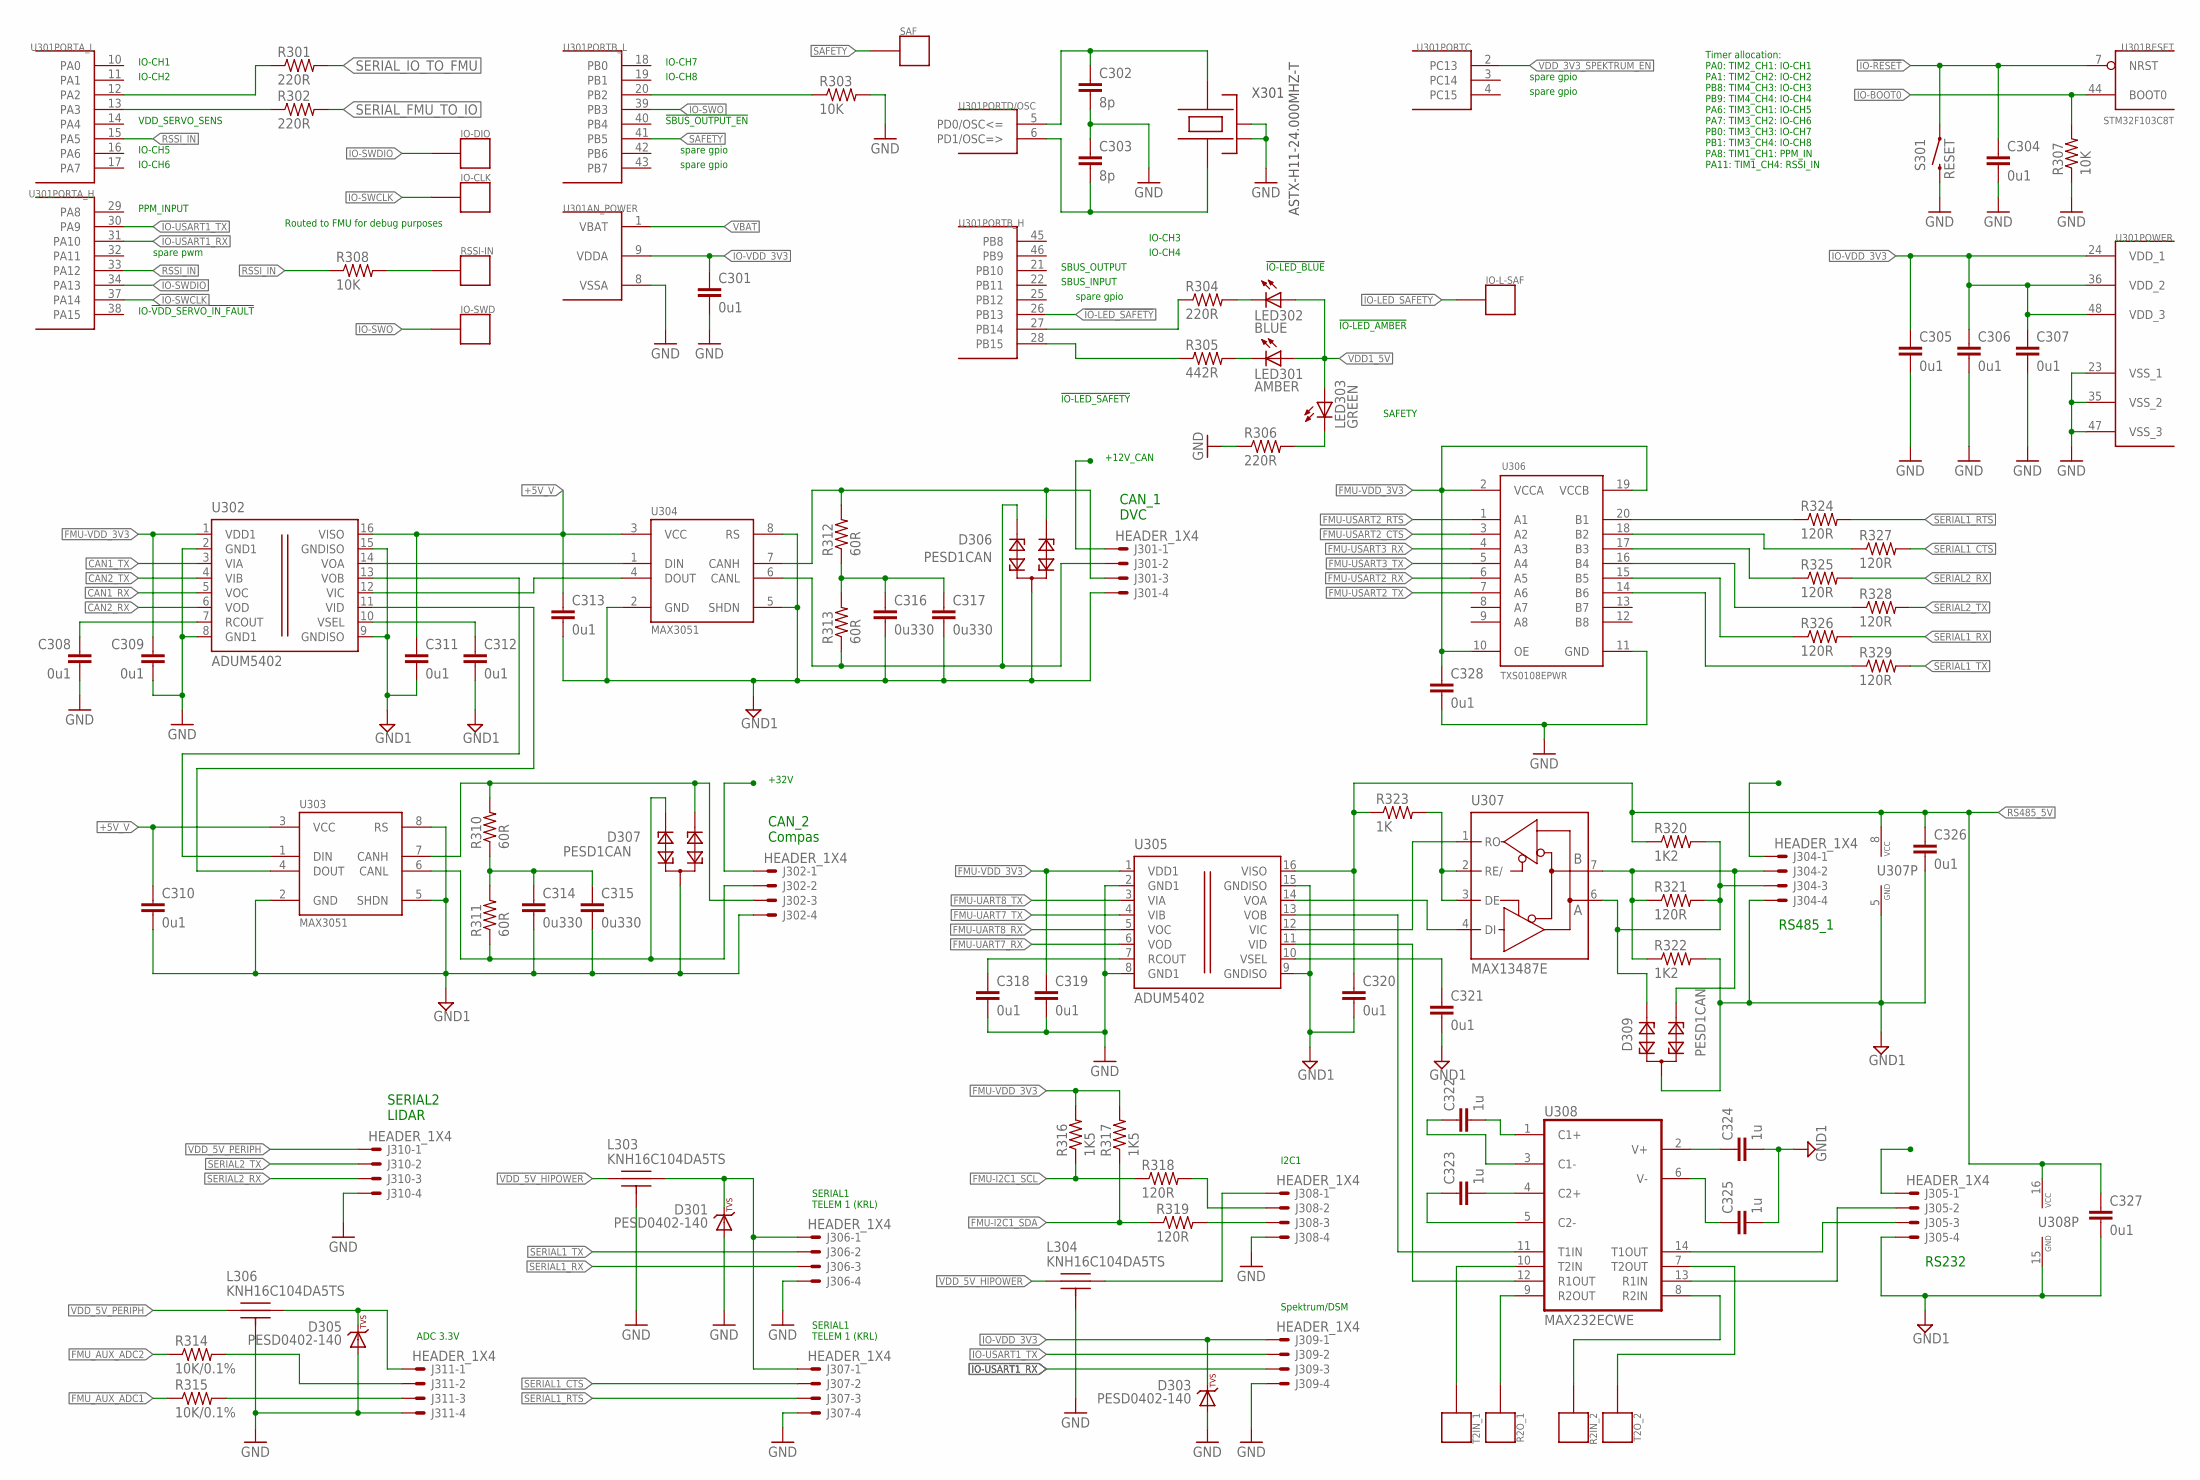
[picture p15: schematic PC104.sch, sheet 3]

Parts:
C301, C304, C305, C306, C307, C308, C309, C310, C311, C312, C313, C318, C319, C320, C321, C326, C327, C328: 0u1; 0603-CAP
C302, C303: 8p; 0603-CAP
C314, C315, C316, C317: 0u330; 1210
C322, C323, C324, C325: 1u; 0603-CAP
D301, D303, D305: PESD0402-140; 0402-TVS
D306, D307, D309: PESD1CAN; SOT23@1
IO-CLK: PAD.04; PAD.04X.04
IO-DIO: TP31; PAD.04X.04
IO-L-SAF: PAD.04; PAD.04X.04
IO-SWD: PAD.04; PAD.04X.04
J301, J302, J304, J305, J306, J307, J308, J309, J310, J311: HEADER_1X4; HEADER_2.54MM-1X04
L303, L304, L306: KNH16C104DA5TS; KYOCERA-KNH16-DA
LED301: AMBER; 0603-LED
LED302: BLUE; 0603-LED
LED303: GREEN; 0603-LED
R2IN_2, R2O_1: PAD.04; PAD.04X.04
R301, R302, R304, R306: 220R; 0603-RES
R303, R307, R308: 10K; 0603-RES
R305: 442R; 0603-RES
R310, R311, R312, R313: 60R; 0603-RES
R314, R315: 10K/0.1%; 0603-RES
R316, R317: 1K5; 0603-RES
R318, R319, R321, R324, R325, R326, R327, R328, R329: 120R; 0603-RES
R320, R322: 1K2; 0603-RES
R323: 1K; 0603-RES
RSSI-IN: PAD.04; PAD.04X.04
S301: RESET; EVQP7J01K
SAF: PAD.04; PAD.04X.04
T2IN_1: T2IN; PAD.04X.04
T2O_2: PAD.04; PAD.04X.04
U301: STM32F103C8T; TQFP48
U302, U305: ADUM5402; SO-16W
U303, U304: MAX3051; SO08
U306: TXS0108EPWR; R-PDSO-G20
U307: MAX13487E; SO08
U308: MAX232ECWE; SO16L
X301: ASTX-H11-24.000MHZ-T; OSCILLATOR-3.2X2.5

Connections:
!IO-LED_SAFETY: IO-L-SAF.P$1, U301.26 (PB13)
+5V: J305.1
+5V_V: C310.P$1 (1), C311.P$1 (1), C313.P$1 (1), U302.16 (VISO), U303.3 (VCC), U304.3 (VCC)
+12V: J304.1
+12V_CAN: J301.1
+32V_CAN: J302.1
CAN1_RX: U302.5 (VOC); also elsewhere on the board
CAN1_TX: U302.3 (VIA); also elsewhere on the board
CAN2_RX: U302.6 (VOD); also elsewhere on the board
CAN2_RX_IN: U302.11 (VID), U303.4 (DOUT)
CAN2_TX: U302.4 (VIB); also elsewhere on the board
CAN2_TX_IN: U302.13 (VOB), U303.1 (DIN)
FMU-I2C1_SCL: R316.1, R318.1; also elsewhere on the board
FMU-I2C1_SDA: R317.1, R319.1; also elsewhere on the board
FMU-UART7_RX: U305.6 (VOD); also elsewhere on the board
FMU-UART7_TX: U305.4 (VIB); also elsewhere on the board
FMU-UART8_RX: U305.5 (VOC); also elsewhere on the board
FMU-UART8_TX: U305.3 (VIA); also elsewhere on the board
FMU-USART2_CTS: U306.3 (A2); also elsewhere on the board
FMU-USART2_RTS: U306.1 (A1); also elsewhere on the board
FMU-USART2_RX: U306.6 (A5); also elsewhere on the board
FMU-USART2_TX: U306.7 (A6); also elsewhere on the board
FMU-USART3_RX: U306.4 (A3); also elsewhere on the board
FMU-USART3_TX: U306.5 (A4); also elsewhere on the board
FMU-VDD_3V3: C309.P$1 (1), C319.P$1 (1), C328.P$1 (1), R316.2, R317.2, U302.1 (VDD1), U305.1 (VDD1), U306.2 (VCCA), U306.10 (OE), U306.19 (VCCB); also elsewhere on the board
FMU_AUX_ADC1: R315.1; also elsewhere on the board
FMU_AUX_ADC2: R314.1; also elsewhere on the board
GND: C301.P$2 (2), C302.P$2 (2), C303.P$1 (1), C304.P$2 (2), C305.P$2 (2), C306.P$2 (2), C307.P$2 (2), C308.P$2 (2), C309.P$2 (2), C318.P$2 (2), C319.P$2 (2), C328.P$2 (2), D301.A, D303.A, D305.A, J306.4, J307.4, J308.4, J309.4, J310.4, J311.4, L303.P$3, L303.P$4, L303.P$5, L304.P$3, L304.P$4, L304.P$5, L306.P$3, L306.P$4, L306.P$5, R303.2, R306.1, R307.1, S301.B3 (2), U301.8 (VSSA), U301.23 (VSS_1), U301.35 (VSS_2), U301.47 (VSS_3), U302.2 (GND1), U302.8 (GND1), U305.2 (GND1), U305.8 (GND1), U306.11 (GND), X301.2 (NC_2), X301.4 (NC_4); also elsewhere on the board
GND1: C310.P$2 (2), C311.P$2 (2), C312.P$2 (2), C313.P$2 (2), C314.2, C315.2, C316.2, C317.2, C320.P$2 (2), C321.P$2 (2), C324.P$2 (2), C325.P$2 (2), C326.P$2 (2), C327.P$2 (2), D306.3, D307.3, D309.3, J301.4, J302.4, J304.4, J305.4, R322.2, U302.9 (GNDISO), U302.15 (GNDISO), U303.2 (GND), U303.5 (SHDN), U303.8 (RS), U304.2 (GND), U304.5 (SHDN), U304.8 (RS), U305.9 (GNDISO), U305.15 (GNDISO), U307.5 (GND), U308.15 (GND)
IO-!RESET: C304.P$1 (1), S301.A1 (1), U301.7 (NRST)
IO-BOOT0: R307.2, U301.44 (BOOT0)
IO-SWCLK: IO-CLK.P$1, U301.37 (PA14)
IO-SWDIO: IO-DIO.P$1, U301.34 (PA13)
IO-SWO: IO-SWD.P$1, U301.39 (PB3)
IO-USART1_RX: J309.3, U301.31 (PA10)
IO-USART1_TX: J309.2, U301.30 (PA9); also elsewhere on the board
IO-VDD_3V3: C301.P$1 (1), C305.P$1 (1), C306.P$1 (1), C307.P$1 (1), D303.C, J309.1, U301.9 (VDDA), U301.24 (VDD_1), U301.36 (VDD_2), U301.48 (VDD_3); also elsewhere on the board
unnamed: R301.1, U301.12 (PA2)
unnamed: R302.1, U301.13 (PA3)
unnamed: R303.1, U301.20 (PB2)
unnamed: C303.P$2 (2), U301.6 (PD1/OSC=>), X301.1
unnamed: D309.1, J304.3, R320.2, R321.2, U307.6 (A)
unnamed: J305.2, U308.13 (R1IN)
unnamed: D309.2, J304.2, R321.1, R322.1, U307.7 (B)
unnamed: R308.2, RSSI-IN.P$1
unnamed: C308.P$1 (1), U302.7 (RCOUT)
unnamed: LED303.C, R306.2
unnamed: J311.3, R315.2
unnamed: C312.P$1 (1), U302.10 (VSEL)
unnamed: D301.C, J306.1, J307.1, L303.P$2
unnamed: C323.P$2 (2), U308.4 (C2+)
unnamed: R304.1, U301.27 (PB14)
unnamed: C316.1, C317.1, R312.1, R313.2
unnamed: J308.2, R318.2
unnamed: C323.P$1 (1), U308.5 (C2-)
unnamed: LED301.C, R305.2
unnamed: J308.3, R319.2
unnamed: R305.1, U301.28 (PB15)
unnamed: LED302.C, R304.2
unnamed: R328.1, U306.16 (B4)
unnamed: R326.1, U306.15 (B5)
unnamed: C322.P$2 (2), U308.1 (C1+)
unnamed: C322.P$1 (1), U308.3 (C1-)
unnamed: J305.3, U308.14 (T1OUT)
unnamed: J308.1, L304.P$2
unnamed: D305.C, J311.1, L306.P$2
unnamed: R325.1, U306.17 (B3)
unnamed: R327.1, U306.18 (B2)
unnamed: C318.P$1 (1), U305.7 (RCOUT)
unnamed: R329.1, U306.14 (B6)
unnamed: R324.1, U306.20 (B1)
unnamed: J311.2, R314.2
unnamed: C321.P$1 (1), U305.10 (VSEL)
unnamed: C324.P$1 (1), U308.2 (V+)
unnamed: C314.1, C315.1, R310.1, R311.2
unnamed: D306.1, J301.2, R313.1, U304.6 (CANL)
unnamed: D306.2, J301.3, R312.2, U304.7 (CANH)
unnamed: D307.1, J302.3, R310.2, U303.7 (CANH)
unnamed: D307.2, J302.2, R311.1, U303.6 (CANL)
unnamed: C325.P$1 (1), U308.6 (V-)
unnamed: R323.2, U307.2 (RE/), U307.3 (DE)
unnamed: T2IN_1.P$1, U308.10 (T2IN)
unnamed: R2O_1.P$1, U308.9 (R2OUT)
unnamed: T2O_2.P$1, U308.7 (T2OUT)
unnamed: R2IN_2.P$1, U308.8 (R2IN)
unnamed: U302.14 (VOA), U304.1 (DIN)
unnamed: U302.12 (VIC), U304.4 (DOUT)
RS485_5V: C320.P$1 (1), C326.P$1 (1), C327.P$1 (1), R320.1, R323.1, U305.16 (VISO), U307.8 (VCC), U308.16 (VCC)
RSSI_IN: R308.1, U301.15 (PA5), U301.33 (PA12)
SAFETY: SAF.P$1, U301.41 (PB5)
SERIAL1_CTS: J307.2, R327.2
SERIAL1_RTS: J307.3, R324.2
SERIAL1_RX: J306.3, R326.2
SERIAL1_TX: J306.2, R329.2
SERIAL2_RX: J310.3, R325.2
SERIAL2_TX: J310.2, R328.2
SERIAL_FMU_TO_IO: R302.2; also elsewhere on the board
SERIAL_IO_TO_FMU: R301.2; also elsewhere on the board
VBAT: U301.1 (VBAT); also elsewhere on the board
VDD1_5V: LED301.A, LED302.A, LED303.A; also elsewhere on the board
VDD_3V3_SPEKTRUM_EN: U301.2 (PC13)
VDD_5V_HIPOWER: L303.P$1, L304.P$1; also elsewhere on the board
VDD_5V_PERIPH: J310.1, L306.P$1; also elsewhere on the board
VIC: U305.12 (VIC), U307.1 (RO)
VID: U305.11 (VID), U308.12 (R1OUT)
VOA: U305.14 (VOA), U307.4 (DI)
VOB: U305.13 (VOB), U308.11 (T1IN)
X301: C302.P$1 (1), U301.5 (PD0/OSC<=), X301.3

Notes on the sheet:
spare gpio
spare pwm
Timer allocation: PA0: TIM2_CH1: IO-CH1 PA1: TIM2_CH2: IO-CH2 PB8: TIM4_CH3: IO-CH3 PB9: TIM4_CH4: IO-CH4 PA6: TIM3_CH1: IO-CH5 PA7: TIM3_CH2: IO-CH6 PB0: TIM3_CH3: IO-CH7 PB1: TIM3_CH4: IO-CH8 PA8: TIM1_CH1: PPM_IN PA11: TIM1_CH4: RSSI_IN
Routed to FMU for debug purposes
Spektrum/DSM
I2C1
SERIAL1 TELEM 1 (KRL)
ADC 3.3V
IO-CH1
IO-CH2
IO-CH5
IO-CH6
VDD_SERVO_SENS
PPM_INPUT
IO-!VDD_SERVO_IN_FAULT
IO-CH7
IO-CH8
!SBUS_OUTPUT_EN
IO-CH3
IO-CH4
SBUS_OUTPUT
SBUS_INPUT
!IO-LED_SAFETY
!IO-LED_BLUE
!IO-LED_AMBER
SAFETY
CAN_1 DVC
CAN_2 Compas
RS485_1
RS232
SERIAL2 LIDAR
+12V_CAN
+32V

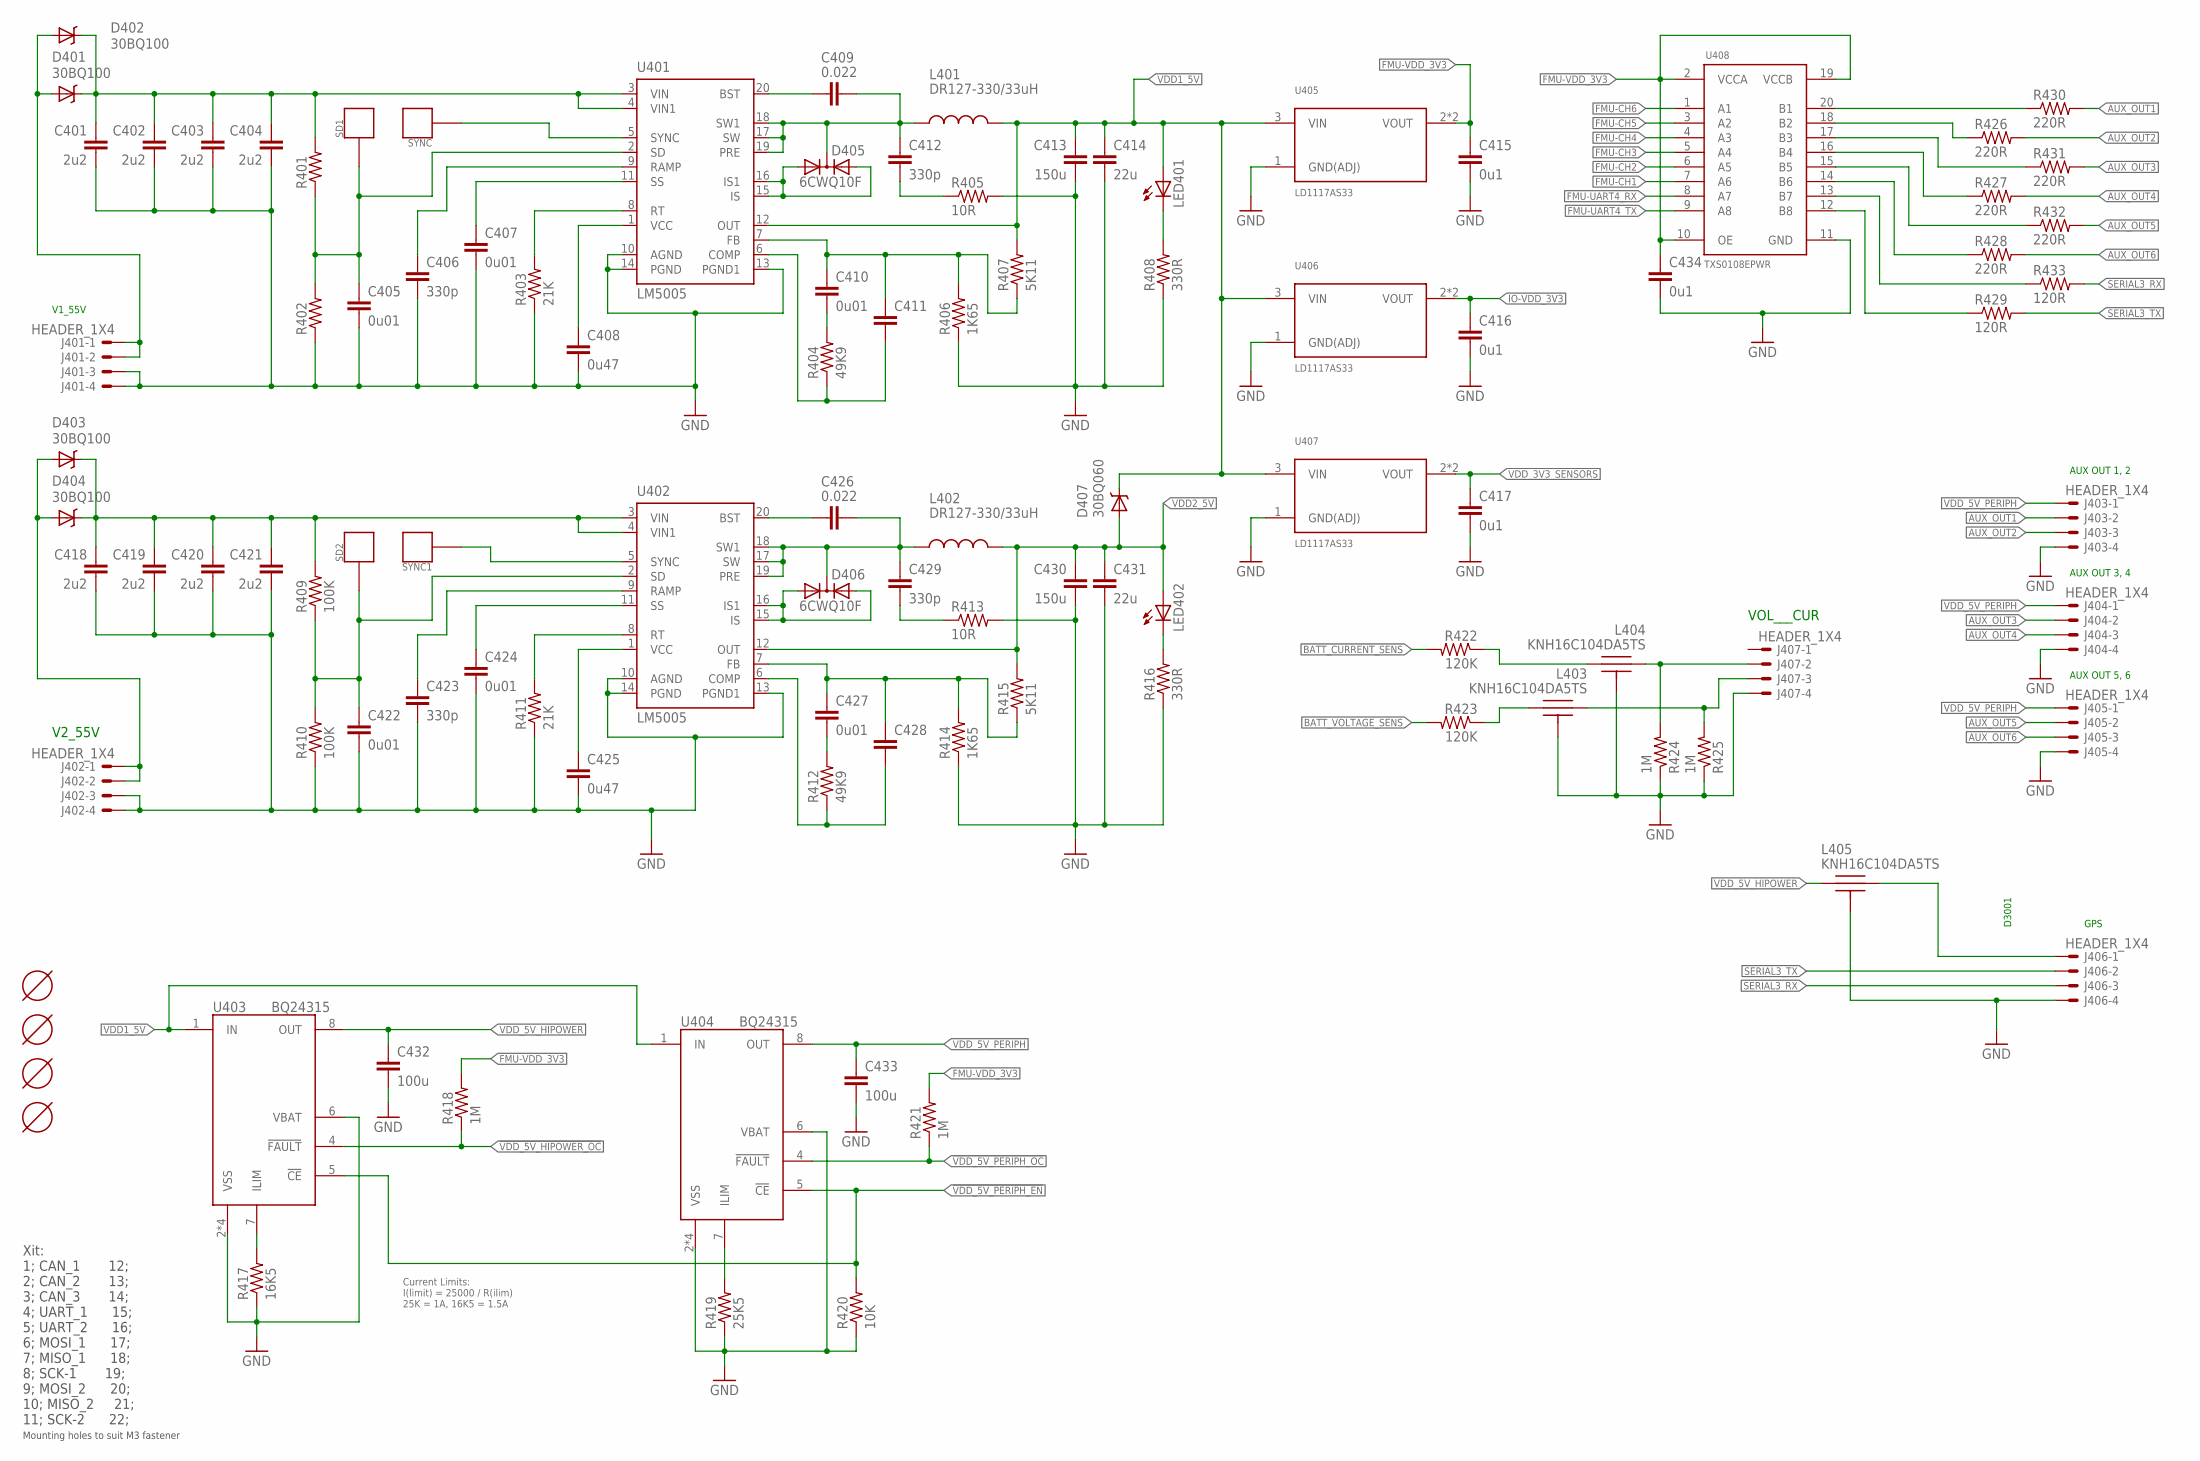
[picture p16: schematic PC104.sch, sheet 4]

Parts:
C401, C402, C403, C404, C418, C419, C420, C421: 2u2; 1812-CAP
C405, C407, C410, C422, C424, C427: 0u01; 0805-CAP
C406, C412, C423, C429: 330p; 0805-CAP
C408, C425: 0u47; 0805-CAP
C409, C426: 0.022; 0805-CAP
C411, C428: CAP0805; 0805-CAP
C413, C430: 150u; 1206-CAP
C414, C431: 22u; 1206-CAP
C415, C416, C417: 0u1; 0805-CAP
C432, C433: 100u; 1206-CAP
C434: 0u1; 0603-CAP
D401, D402, D403, D404: 30BQ100; SMA-DIODE
D405, D406: 6CWQ10F; SOT23
D407: 30BQ060; SMA-DIODE
J401, J402, J403, J404, J405, J406, J407: HEADER_1X4; HEADER_2.54MM-1X04
L401, L402: DR127-330/33uH; SLF10145
L403, L404, L405: KNH16C104DA5TS; KYOCERA-KNH16-DA
LED401, LED402: LED0603; 0603-LED
R401, R402: RESISTOR0805; 0805
R403, R411: 21K; 0805
R404, R412: 49K9; 0805
R405, R413: 10R; R2512
R406, R414: 1K65; 0805
R407, R415: 5K11; 0805
R408, R416: 330R; 0805
R409, R410: 100K; 0805
R417: 16K5; 0603-RES
R418, R421, R424, R425: 1M; 0603-RES
R419: 25K5; 0603-RES
R420: 10K; 0603-RES
R422, R423: 120K; 0603-RES
R426, R427, R428, R430, R431, R432: 220R; 0603-RES
R429, R433: 120R; 0603-RES
SD1, SD2: CYNC; PAD.03X.03
SYNC, SYNC1: CYNC; PAD.03X.03
U401, U402: LM5005; TSSOP20
U403, U404: BQ24315; QFN8-DSG
U405, U406, U407: LD1117AS33; SOT-223
U408: TXS0108EPWR; R-PDSO-G20
U$1, U$2, U$3, U$4: MOUNT-HOLE; MOUNT-HOLE3.3

Connections:
!VDD_5V_HIPOWER_OC: R418.1, U403.4 (!FAULT); also elsewhere on the board
!VDD_5V_PERIPH_EN: R420.2, U403.5 (!CE), U404.5 (!CE); also elsewhere on the board
!VDD_5V_PERIPH_OC: R421.1, U404.4 (!FAULT); also elsewhere on the board
+55V1: D401.A, D402.A, J401.1, J401.2
+55V1_V: C401.1, C402.1, C403.1, C404.1, D401.C, D402.C, R401.2, U401.3 (VIN), U401.4 (VIN1)
+55V2: D403.A, D404.A, J402.1, J402.2
+55V2_V: C418.1, C419.1, C420.1, C421.1, D403.C, D404.C, R409.2, U402.3 (VIN), U402.4 (VIN1)
AUX_OUT1: J403.2, R430.2
AUX_OUT2: J403.3, R426.2
AUX_OUT3: J404.2, R431.2
AUX_OUT4: J404.3, R427.2
AUX_OUT5: J405.2, R432.2
AUX_OUT6: J405.3, R428.2
BATT_CURRENT_SENS: R422.2; also elsewhere on the board
BATT_VOLTAGE_SENS: R423.2; also elsewhere on the board
D1X: C409.P$1 (1), C412.P$1 (1), D405.3 (C), L401.P$1 (1), U401.17 (SW), U401.18 (SW1), U401.19 (PRE)
D1_O: D405.1 (A1), D405.2 (A2), U401.15 (IS), U401.16 (IS1)
D2X: C426.P$1 (1), C429.P$1 (1), D406.3 (C), L402.P$1 (1), U402.17 (SW), U402.18 (SW1), U402.19 (PRE)
D2_O: D406.1 (A1), D406.2 (A2), U402.15 (IS), U402.16 (IS1)
FMU-CH1: U408.7 (A6); also elsewhere on the board
FMU-CH2: U408.6 (A5); also elsewhere on the board
FMU-CH3: U408.5 (A4); also elsewhere on the board
FMU-CH4: U408.4 (A3); also elsewhere on the board
FMU-CH5: U408.3 (A2); also elsewhere on the board
FMU-CH6: U408.1 (A1); also elsewhere on the board
FMU-UART4_RX: U408.8 (A7); also elsewhere on the board
FMU-UART4_TX: U408.9 (A8); also elsewhere on the board
FMU-VDD_3V3: C415.P$1 (1), C434.P$1 (1), R418.2, R421.2, U405.2 (VOUT), U405.4 (VOUT), U408.2 (VCCA), U408.10 (OE), U408.19 (VCCB); also elsewhere on the board
GND: C401.2, C402.2, C403.2, C404.2, C405.P$2 (2), C406.P$2 (2), C407.P$2 (2), C408.P$2 (2), C413.P$2 (2), C414.P$2 (2), C415.P$2 (2), C416.P$2 (2), C417.P$2 (2), C418.2, C419.2, C420.2, C421.2, C422.P$2 (2), C423.P$2 (2), C424.P$2 (2), C425.P$2 (2), C430.P$2 (2), C431.P$2 (2), C432.P$2 (2), C433.P$2 (2), C434.P$2 (2), J401.3, J401.4, J402.3, J402.4, J403.4, J404.4, J405.4, J406.4, J407.4, L403.P$3, L403.P$4, L403.P$5, L404.P$3, L404.P$4, L404.P$5, L405.P$3, L405.P$4, L405.P$5, R402.1, R403.1, R405.2, R406.1, R408.1, R410.1, R411.1, R413.2, R414.1, R416.1, R417.1, R419.1, R420.1, R424.1, R425.1, U401.10 (AGND), U401.13 (PGND1), U401.14 (PGND), U402.10 (AGND), U402.13 (PGND1), U402.14 (PGND), U403.2 (VSS), U403.6 (VBAT), U403.GND (VSS), U403.P$2 (VSS), U403.P$3 (VSS), U404.2 (VSS), U404.6 (VBAT), U404.GND (VSS), U404.P$2 (VSS), U404.P$3 (VSS), U405.1 (GND(ADJ)), U406.1 (GND(ADJ)), U407.1 (GND(ADJ)), U408.11 (GND); also elsewhere on the board
GPS: J406.1, L405.P$2
IO-VDD_3V3: C416.P$1 (1), U406.2 (VOUT), U406.4 (VOUT); also elsewhere on the board
unnamed: SYNC.P$1, U401.5 (SYNC)
unnamed: SYNC1.P$1, U402.5 (SYNC)
unnamed: L404.P$2, R422.1
unnamed: L403.P$2, R423.1
unnamed: J407.2, L404.P$1, R424.2
unnamed: J407.3, L403.P$1, R425.2
unnamed: R433.1, U408.13 (B7)
unnamed: C405.P$1 (1), R401.1, R402.2, SD1.P$1, U401.2 (SD)
unnamed: C412.P$2 (2), R405.1
unnamed: R429.1, U408.12 (B8)
unnamed: LED402.C, R416.2
unnamed: C407.P$1 (1), U401.11 (SS)
unnamed: C411.P$2 (2), R404.1, U401.6 (COMP)
unnamed: R403.2, U401.8 (RT)
unnamed: C409.P$2 (2), U401.20 (BST)
unnamed: C408.P$1 (1), U401.1 (VCC)
unnamed: LED401.C, R408.2
unnamed: R417.2, U403.7 (ILIM)
unnamed: C423.P$1 (1), U402.9 (RAMP)
unnamed: C410.P$1 (1), C411.P$1 (1), R406.2, R407.1, U401.7 (FB)
unnamed: C410.P$2 (2), R404.2
unnamed: C422.P$1 (1), R409.1, R410.2, SD2.P$1, U402.2 (SD)
unnamed: C424.P$1 (1), U402.11 (SS)
unnamed: R411.2, U402.8 (RT)
unnamed: C425.P$1 (1), U402.1 (VCC)
unnamed: C406.P$1 (1), U401.9 (RAMP)
unnamed: R430.1, U408.20 (B1)
unnamed: R426.1, U408.18 (B2)
unnamed: R431.1, U408.17 (B3)
unnamed: R427.1, U408.16 (B4)
unnamed: R432.1, U408.15 (B5)
unnamed: R428.1, U408.14 (B6)
unnamed: C426.P$2 (2), U402.20 (BST)
unnamed: C428.P$2 (2), R412.1, U402.6 (COMP)
unnamed: C429.P$2 (2), R413.1
unnamed: R419.2, U404.7 (ILIM)
unnamed: C427.P$1 (1), C428.P$1 (1), R414.2, R415.1, U402.7 (FB)
unnamed: C427.P$2 (2), R412.2
SERIAL3_RX: J406.3, R433.2
SERIAL3_TX: J406.2, R429.2
VDD1_5V: C413.P$1 (1), C414.P$1 (1), D407.C, L401.P$2 (2), LED401.A, R407.2, U401.12 (OUT), U403.1 (IN), U404.1 (IN), U405.3 (VIN), U406.3 (VIN), U407.3 (VIN); also elsewhere on the board
VDD2_5V: C430.P$1 (1), C431.P$1 (1), D407.A, L402.P$2 (2), LED402.A, R415.2, U402.12 (OUT)
VDD_3V3_SENSORS: C417.P$1 (1), U407.2 (VOUT), U407.4 (VOUT); also elsewhere on the board
VDD_5V_HIPOWER: C432.P$1 (1), L405.P$1, U403.8 (OUT); also elsewhere on the board
VDD_5V_PERIPH: C433.P$1 (1), J403.1, J404.1, J405.1, U404.8 (OUT); also elsewhere on the board

Notes on the sheet:
Mounting holes to suit M3 fastener
Xit: 1; CAN_1 12; 2; CAN_2 13; 3; CAN_3 14; 4; UART_1 15; 5; UART_2 16; 6; MOSI_1 17; 7; MISO_1 18; 8; SCK-1 19; 9; MOSI_2 20; 10; MISO_2 21; 11; SCK-2 22;
AUX OUT 1, 2
AUX OUT 3, 4
AUX OUT 5, 6
V1_55V
Current Limits: I(limit) = 25000 / R(ilim) 25K = 1A, 16K5 = 1.5A
D3001
GPS
VOL___CUR
V2_55V

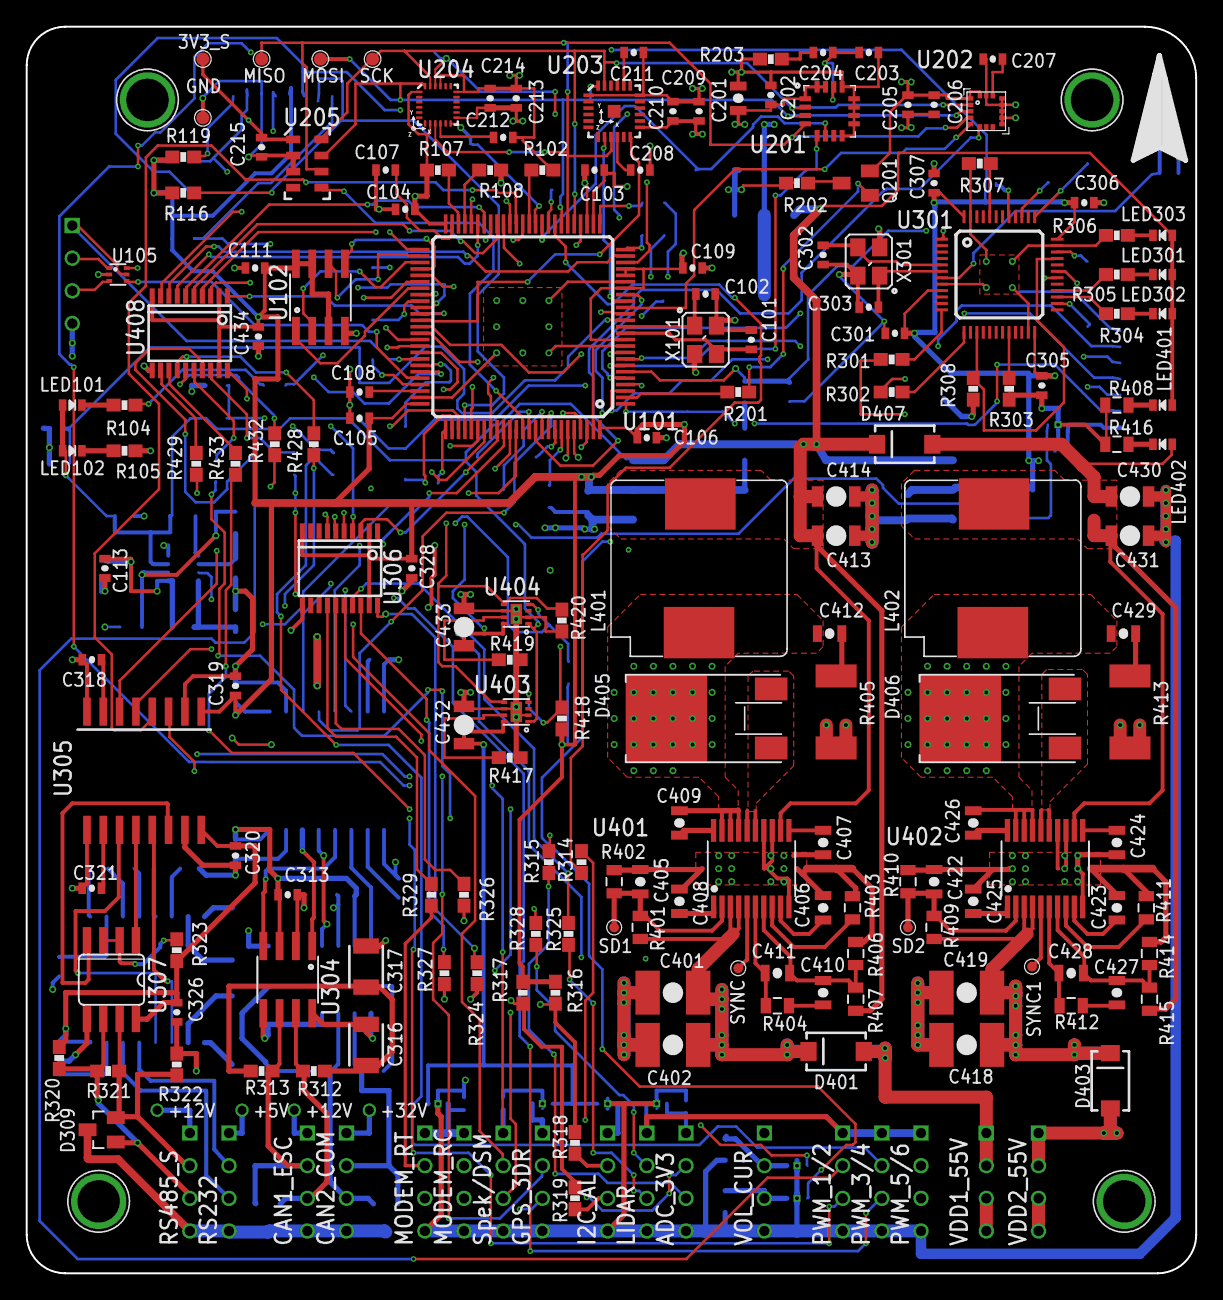
[picture p17: board PC104.brd from above]

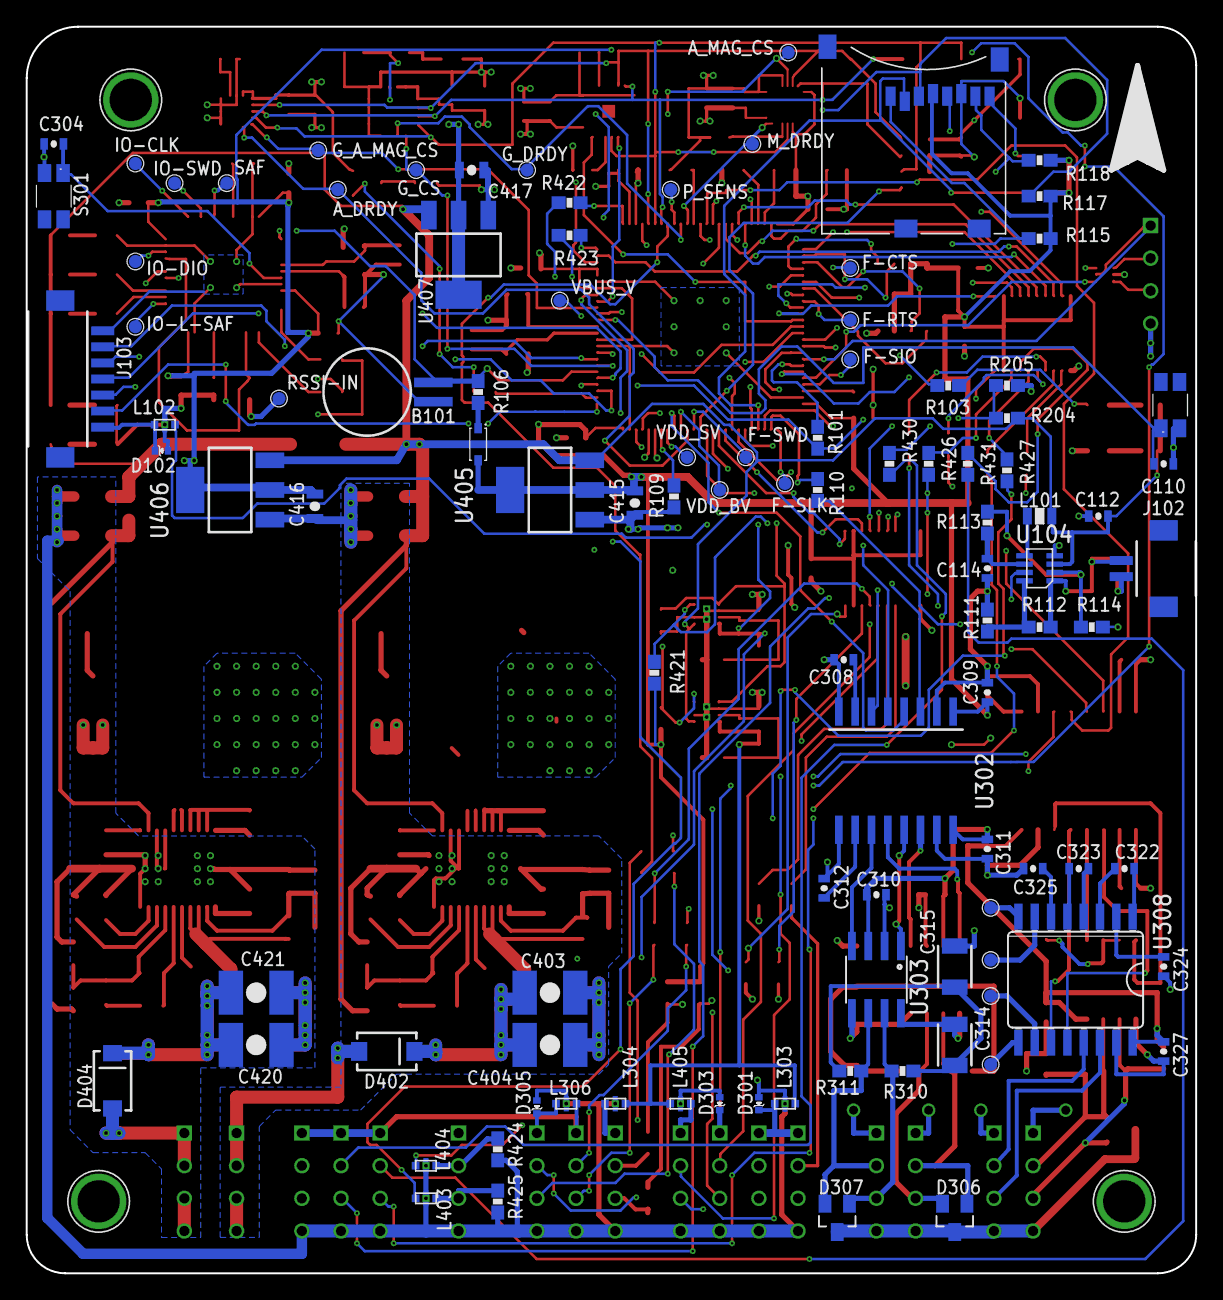
[picture p18: board PC104.brd from below]

Board: 4 copper layers, 91.0 x 97.0 mm, 298 parts (103 on the bottom side), 247 nets.
