Viktor-Matitsin/Hardware/(commit log)

2017-08-15 Тестовый файлик
    [PC104.brd]
2017-08-15 Тест
    [PC104.sch]
2017-08-15 Текущая плата автопилота
    [PC104.brd, PC104.sch]
2017-08-15 Изменили питание процессора
    [PX4FMUv2.4.6.sch, PX4FMUv2.4.brd]
2017-08-15 Исправление #1
2017-08-22 Исправленно #7,#6. Кнопки BOOT 0 выведенны на пятаки #4.
    [PC104_2V.brd, PC104_2V.sch, PX4FMUv2.4.6.sch, PX4FMUv2.4.brd]
2017-08-23 Исправленно #2, #3, #5, #8, #9
    [BOM_FMU_V.2.xlsx, FMU_V.2.brd, FMU_V.2.sch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]
